christoph-weiser/gf180mcu_cw_ip_vref/README.md

# Current Mode Voltage Reference

### [Documentation](doc/main.md)

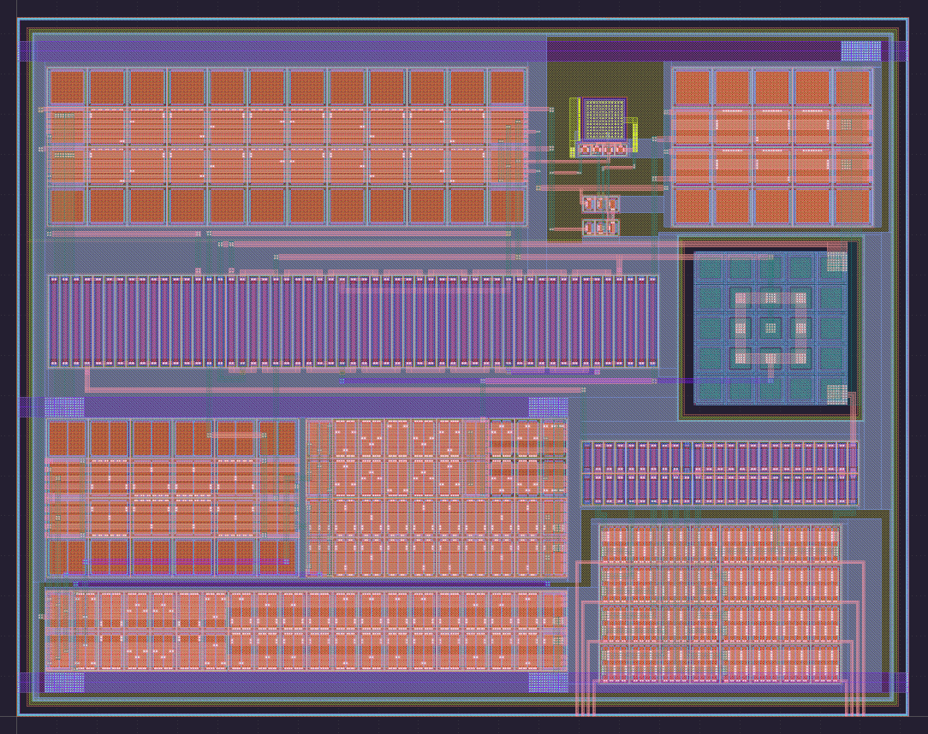
[picture p1: doc/pic/layout.png]
layout
