christoph-weiser/gf180mcu_cw_ip_vref/doc/bandgap/dc_bandgap_temperature.md

# Simulation Results 

Simulation results for dc_bandgap_temperature

## Pre-Layout Simulation

| | min | max | mean | std |
|:---|:---|:---|:---|:---|
| dv_dt | 32.53598u | 58.57123u | 42.82626u | 7.88363u |

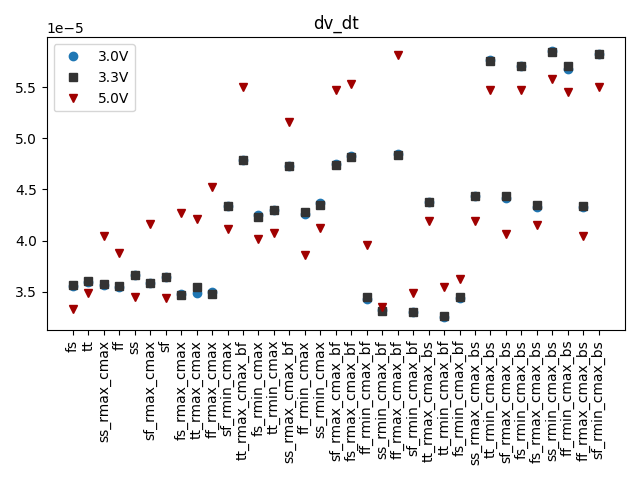
[picture p3: doc/bandgap/pic/sim_sch/dc_bandgap_temperature/dv_dt.png]
dv_dt


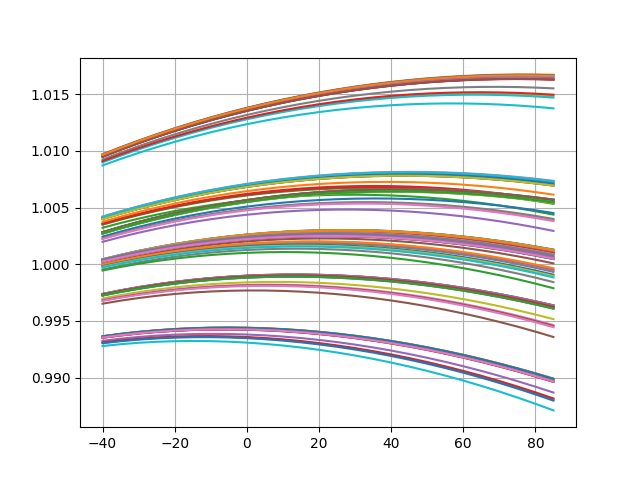
[picture p4: doc/bandgap/pic/sim_sch/dc_bandgap_temperature/tc.png]
tc

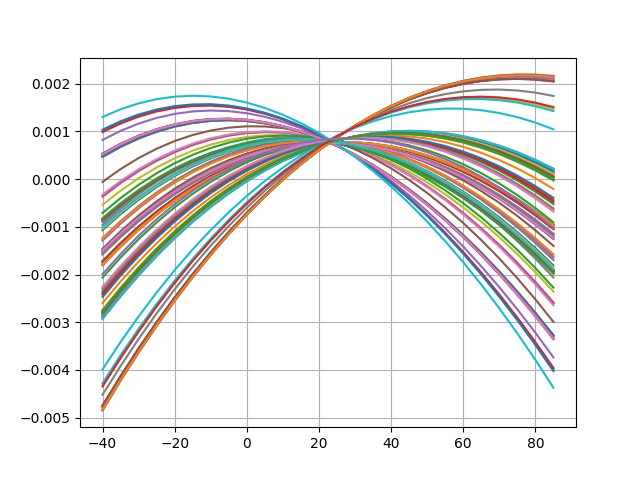
[picture p5: doc/bandgap/pic/sim_sch/dc_bandgap_temperature/tc_norm.png]
tc_norm


## Post-Layout Simulation

NGspice has difficulty to converge on the DC operating point of the circuit. 
While less efficient the Temperature coefficient can also be obtained
by stepping through transient simulations. 

For results see:
[tr_bandgap_temperature](tr_bandgap_temperature.md)
