christoph-weiser/gf180mcu_cw_ip_vref/doc/sim_sch.md

# Schematic Simulation Results

The results shown below are all pre-layout simulation results.

## op_bandgap_power

| | min | max | mean | std |
|:-----|:---|:---|:---|:---|
| iamp | 4.90561u  | 9.68597u  | 7.05185u  | 1.40299u  |
| ibgc | 7.19443u  | 12.44681u | 9.63843u  | 1.89971u  |
| itot | 16.42464u | 29.54914u | 22.46829u | 4.41985u  |
| pamp | 14.71684u | 48.42985u | 26.79417u | 9.11306u  |
| pbgc | 21.60794u | 62.15826u | 36.29921u | 11.20453u |
| ptot | 49.27392u | 147.7457u | 84.85841u | 27.02177u |

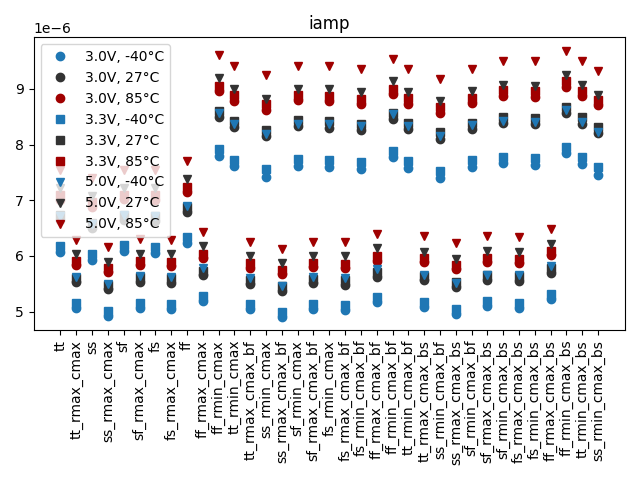
[picture p6: doc/pic/sim_sch/op_bandgap_power/iamp.png]
iamp

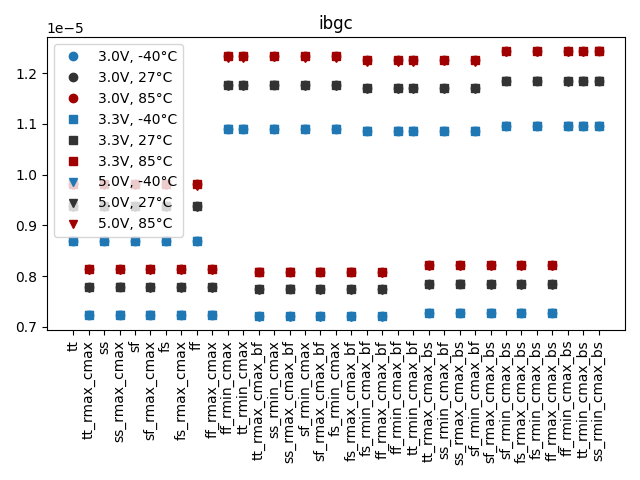
[picture p7: doc/pic/sim_sch/op_bandgap_power/ibgc.png]
ibgc

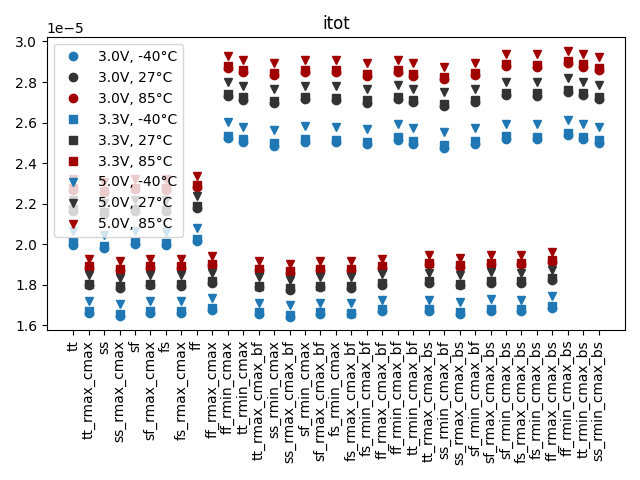
[picture p8: doc/pic/sim_sch/op_bandgap_power/itot.png]
itot

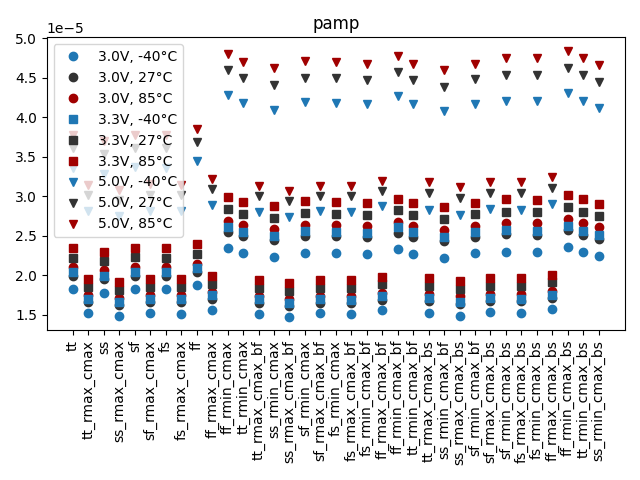
[picture p9: doc/pic/sim_sch/op_bandgap_power/pamp.png]
pamp

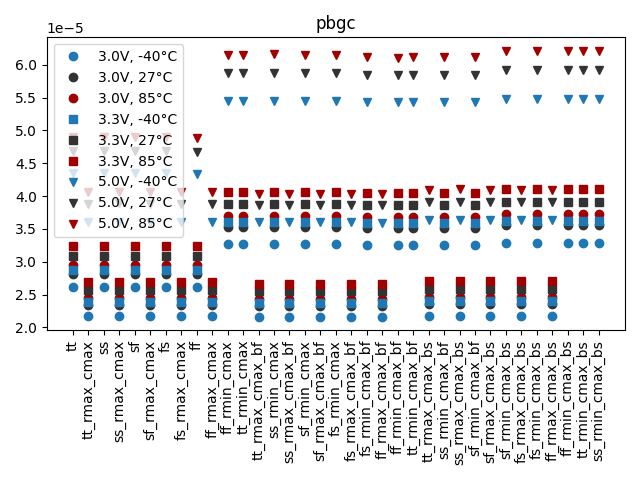
[picture p10: doc/pic/sim_sch/op_bandgap_power/pbgc.png]
pbgc

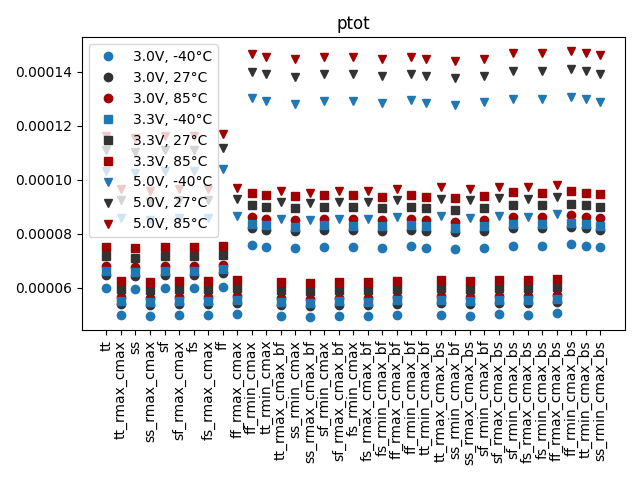
[picture p11: doc/pic/sim_sch/op_bandgap_power/ptot.png]
ptot
