christoph-weiser/gf180mcu_cw_ip_vref/doc/bandgap/no_bandgap.md

# Simulation Results 

Simulation results for no_bandgap

## Pre-Layout Simulation

| | min | max | mean | std |
|:---|:---|:---|:---|:---|
| onoise_total | 74.11961u | 96.98846u | 85.22032u | 5.52835u |

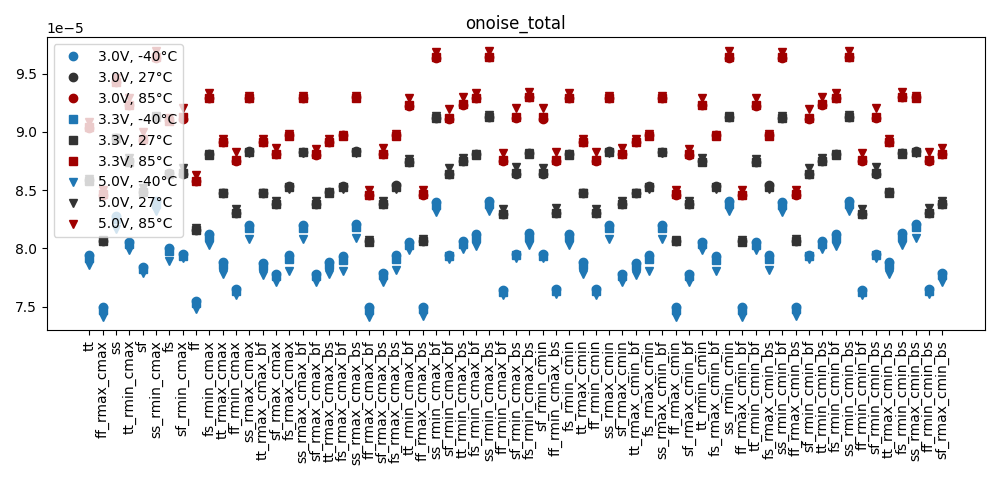
[picture p12: doc/bandgap/pic/sim_sch/no_bandgap/onoise_total.png]
onoise_total


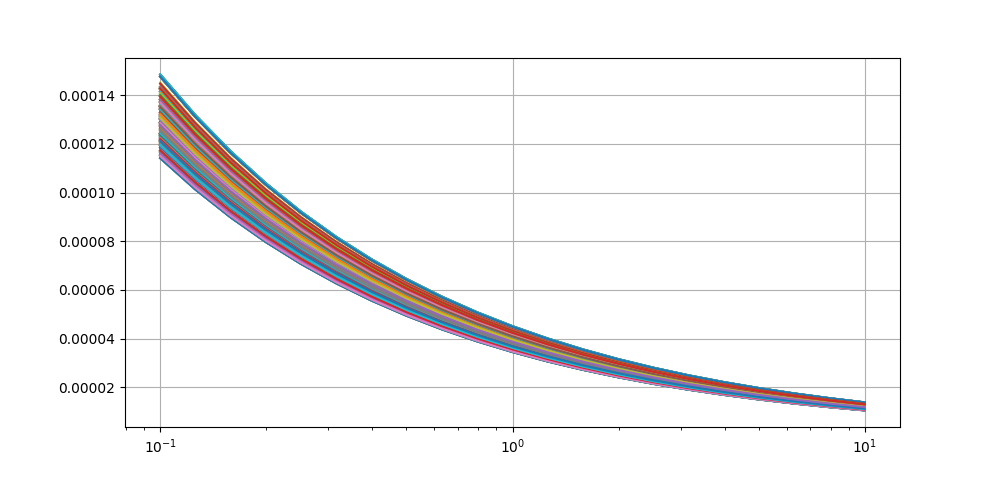
[picture p13: doc/bandgap/pic/sim_sch/no_bandgap/onoise.png]
onoise


## Post-Layout Simulation

| | min | max | mean | std |
|:---|:---|:---|:---|:---|
| onoise_total | 74.50524u | 97.26561u | 85.56302u | 5.44764u |

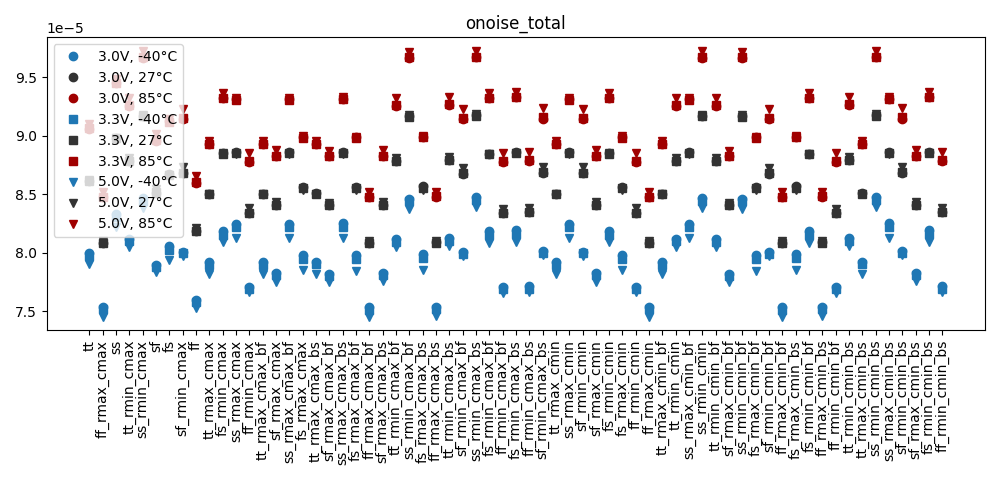
[picture p14: doc/bandgap/pic/sim_pex/no_bandgap/onoise_total.png]
onoise_total


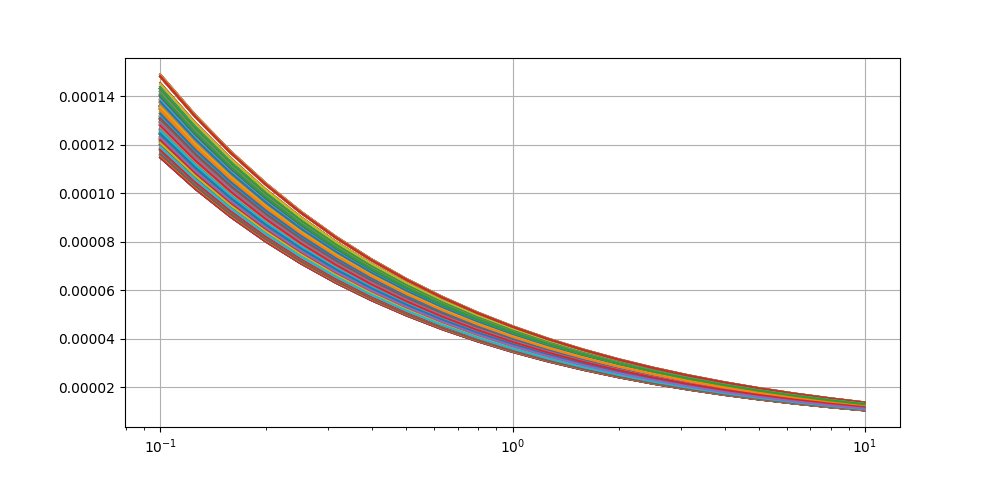
[picture p15: doc/bandgap/pic/sim_pex/no_bandgap/onoise.png]
onoise
