christoph-weiser/gf180mcu_cw_ip_vref/doc/bandgap/mc_bandgap_init_accuracy.md

# Simulation Results 

Simulation results for mc_bandgap_init_accuracy. 

## Pre-Layout Simulation

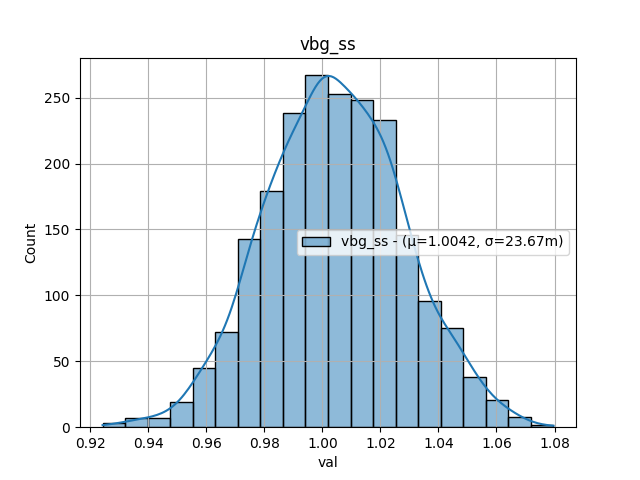
[picture p26: doc/bandgap/pic/sim_sch/mc_bandgap_init_accuracy/vbg_ss.png]
vbg
