christoph-weiser/gf180mcu_cw_ip_vref/doc/levelshifter/tr_levelshifter.md

# Simulation Results 

Simulation results for tr_levelshifter

## Pre-Layout Simulation

| | min | max | mean | std |
|:---|:---|:---|:---|:---|
| vhi | 1.79999 | 5.0 | 3.36666 | 1.30724 |
| vlo | -293.603n | 289.3036n | 379.6658p | 122.534n  |
| trise | 1.819n | 16.181n | 5.78693n  | 3.99033n  |
| tfall | 299.0p | 788.0p | 480.3111p | 105.1477p |

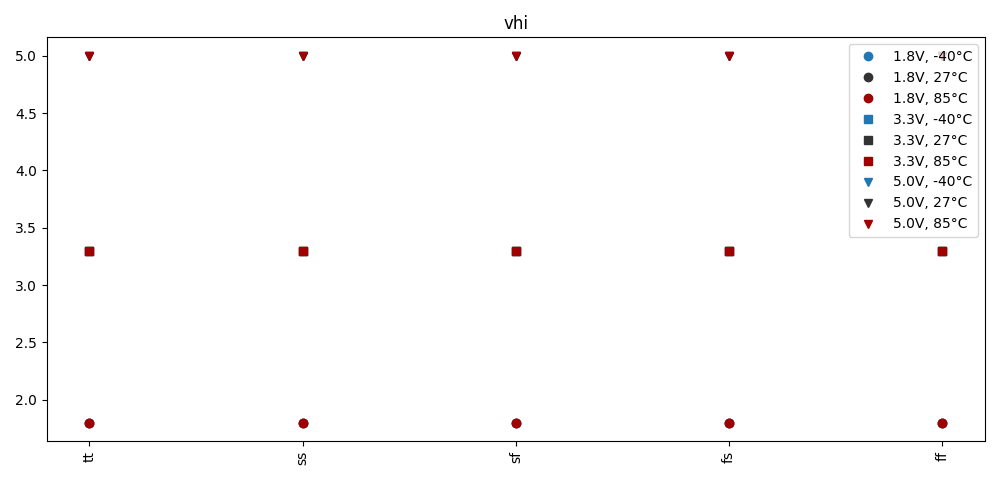
[picture p31: doc/levelshifter/pic/sim_sch/tr_levelshifter/vhi.png]
vhi

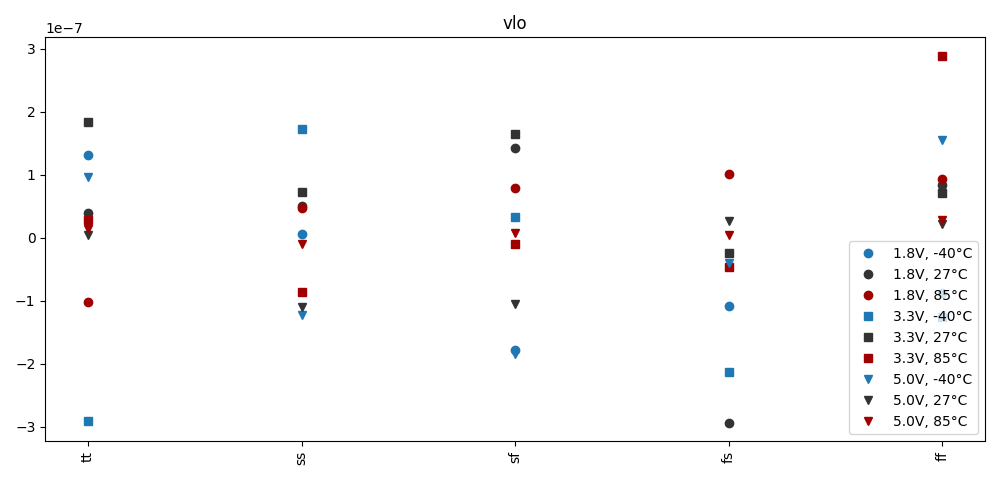
[picture p32: doc/levelshifter/pic/sim_sch/tr_levelshifter/vlo.png]

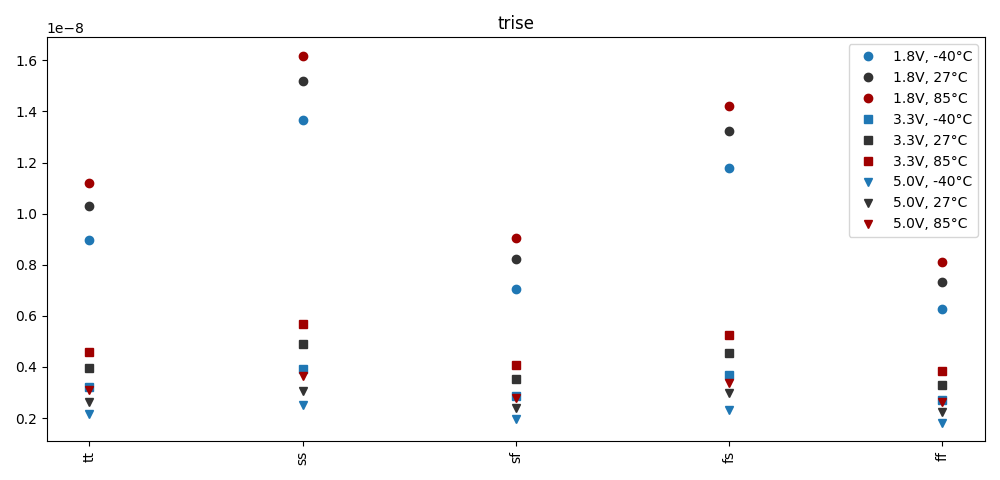
[picture p33: doc/levelshifter/pic/sim_sch/tr_levelshifter/trise.png]
trise

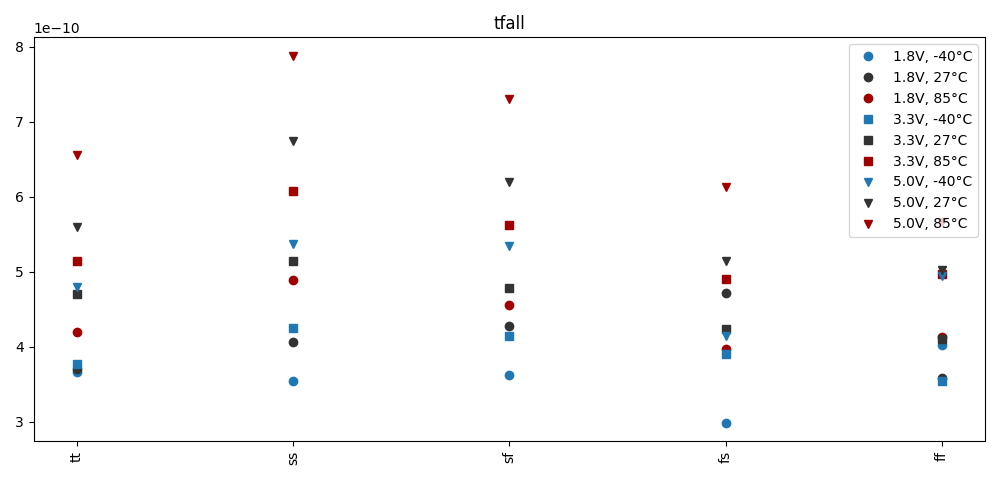
[picture p34: doc/levelshifter/pic/sim_sch/tr_levelshifter/tfall.png]
tfall


## Pre-Layout Simulation

| | min | max | mean | std |
|:---|:---|:---|:---|:---|
| vhi | 1.79999 | 5.0 | 3.36666 | 1.30724 |
| vlo | 652.4982p | 3.97652n | 1.87742n  | 867.5701p |
| trise | 1.91n | 16.477n  | 5.88106n  | 4.06896n  |
| tfall | 287.0p | 817.0p | 475.6222p | 117.6001p |

vhi
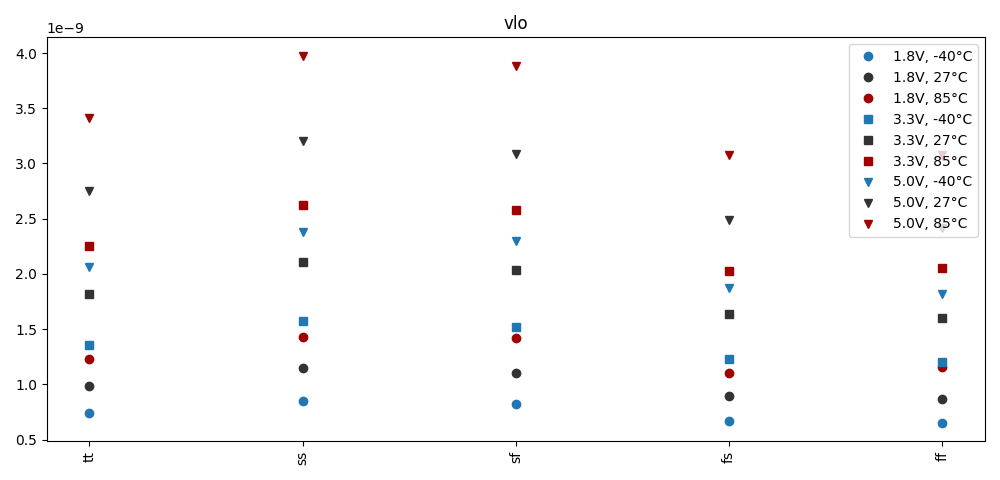
[picture p35: doc/levelshifter/pic/sim_pex/tr_levelshifter/vlo.png]

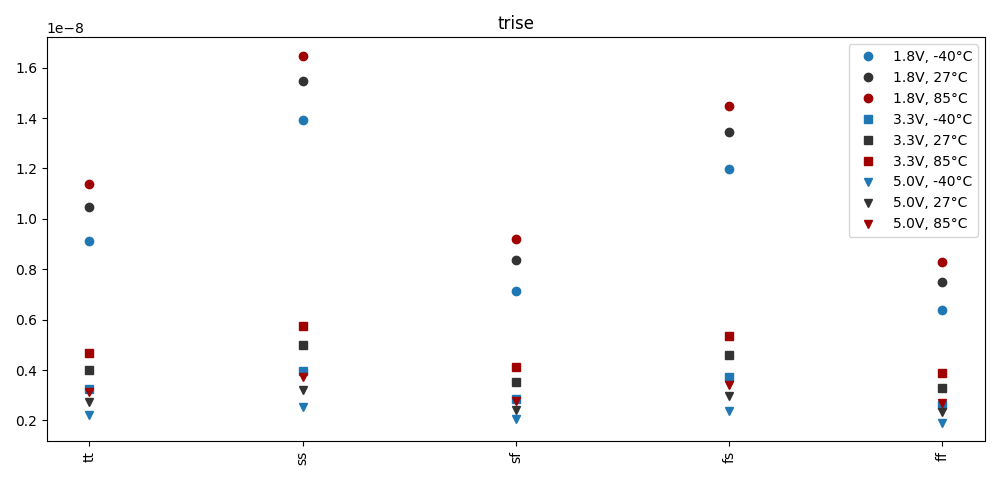
[picture p36: doc/levelshifter/pic/sim_pex/tr_levelshifter/trise.png]
trise

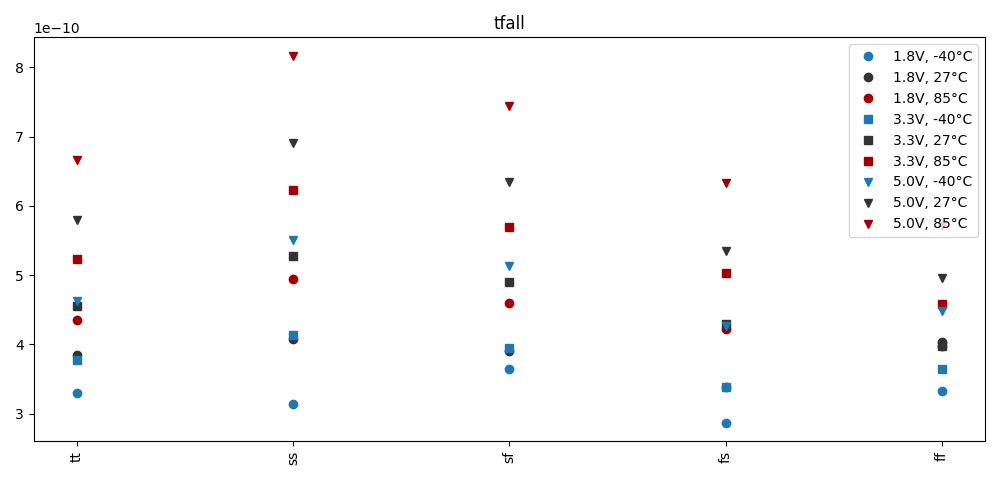
[picture p37: doc/levelshifter/pic/sim_pex/tr_levelshifter/tfall.png]
tfall
