christoph-weiser/gf180mcu_cw_ip_vref/doc/bandgap/tr_bandgap_power_off.md

# Simulation Results 

Simulation results for tr_bandgap_power_off

## Pre-Layout Simulation

| | min | max | mean | std |
|:---|:---|:---|:---|:---|
| ivdd_ss | 577.7768p | 1.07685n | 824.3538p | 156.7362p |

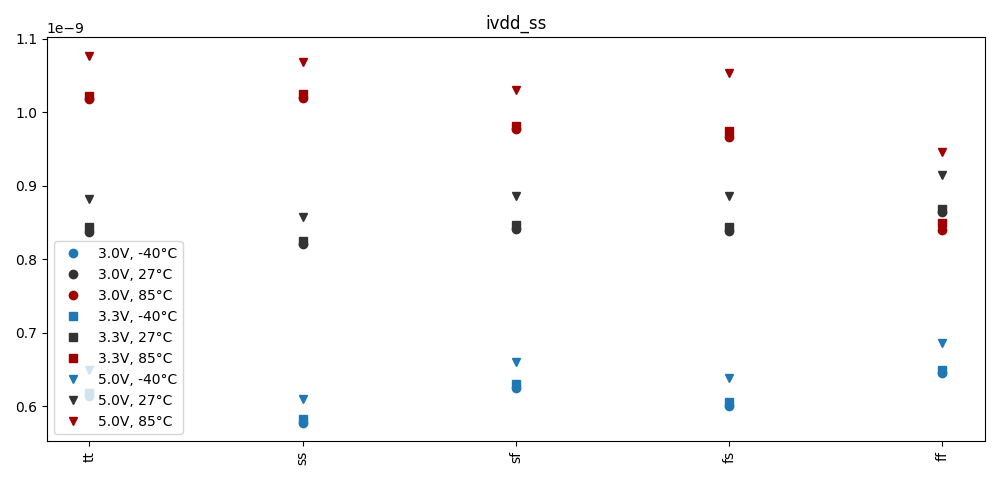
[picture p38: doc/bandgap/pic/sim_sch/tr_bandgap_power_off/ivdd_ss.png]
ivdd_ss


## Post-Layout Simulation

| | min | max | mean | std |
|:---|:---|:---|:---|:---|
| ivdd_ss | 803.8972p | 1.40141n | 1.08660n | 201.2443p |

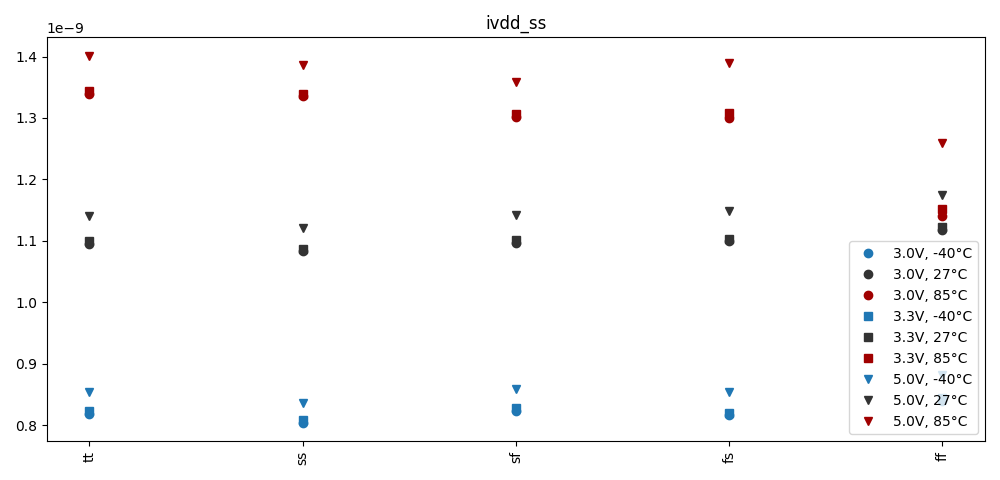
[picture p39: doc/bandgap/pic/sim_pex/tr_bandgap_power_off/ivdd_ss.png]
ivdd_ss
