christoph-weiser/gf180mcu_cw_ip_vref/doc/bandgap/tr_bandgap_trim_ss.md

# Simulation Results 

Simulation results for tr_bandgap_trim_ss

## Pre-Layout Simulation

| | min | max | mean | std |
|:----|---:|---:|---:|---:|
| vbg | 0.854512 | 1.15614 | 1.0061 | 0.0878226 |
| dnl | 0.000665 | 0.00195845 | 0.0011811 | 0.000326729 |

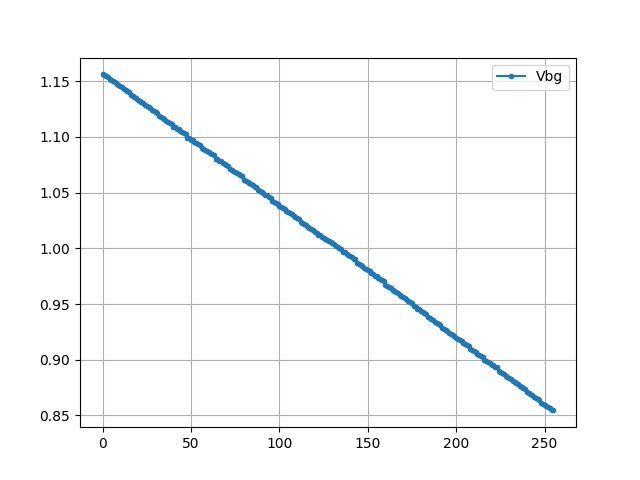
[picture p40: doc/bandgap/pic/sim_sch/tr_bandgap_trim_ss/trim.png]
trim

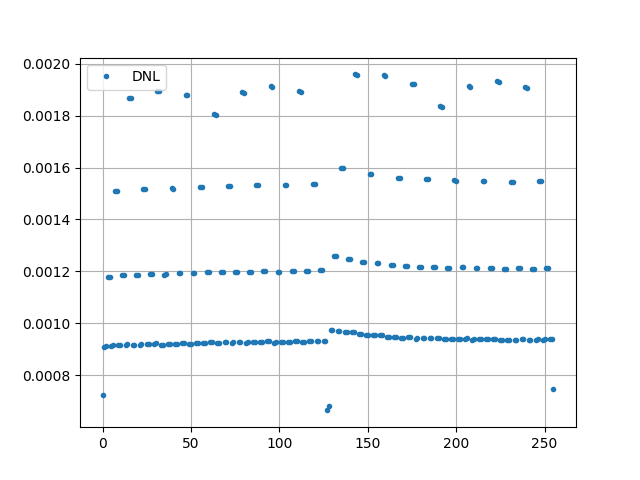
[picture p41: doc/bandgap/pic/sim_sch/tr_bandgap_trim_ss/dnl.png]


## Post-Layout Simulation

| | min | max | mean | std |
|:----|---:|---:|---:|---:|
| vbg | 0.855481 | 1.1622 | 1.00962 | 0.0896754 |
| dnl | 0.00072  | 0.00247275 | 0.00120096 | 0.000376068 |

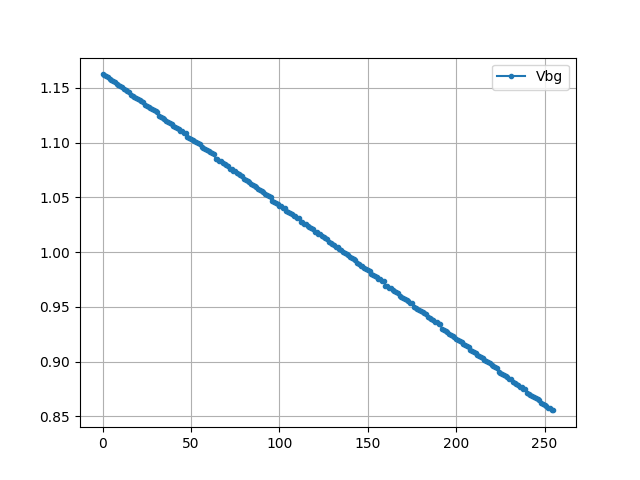
[picture p42: doc/bandgap/pic/sim_pex/tr_bandgap_trim_ss/trim.png]
trim

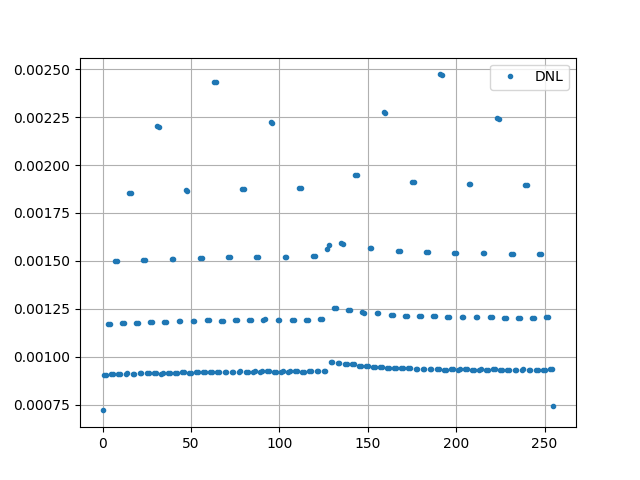
[picture p43: doc/bandgap/pic/sim_pex/tr_bandgap_trim_ss/dnl.png]
