christoph-weiser/gf180mcu_cw_ip_vref/doc/bandgap/tr_bandgap_supply.md

# Simulation Results 

Simulation results for tr_bandgap_supply

## Pre-Layout Simulation

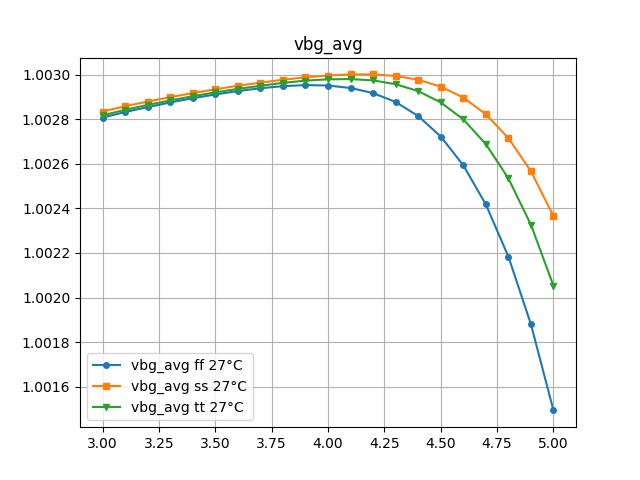
[picture p44: doc/bandgap/pic/sim_sch/tr_bandgap_supply/dv_dvdd.png]
dv_dvdd

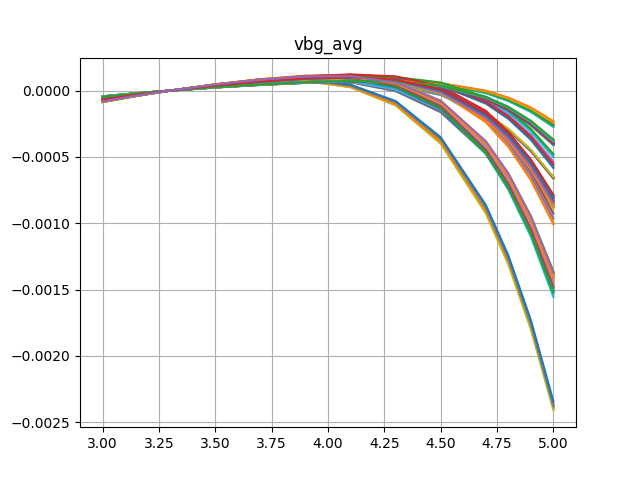
[picture p45: doc/bandgap/pic/sim_pex/tr_bandgap_supply/dv_dvdd_norm.png]
dv_dvdd_norm


## Post-Layout Simulation

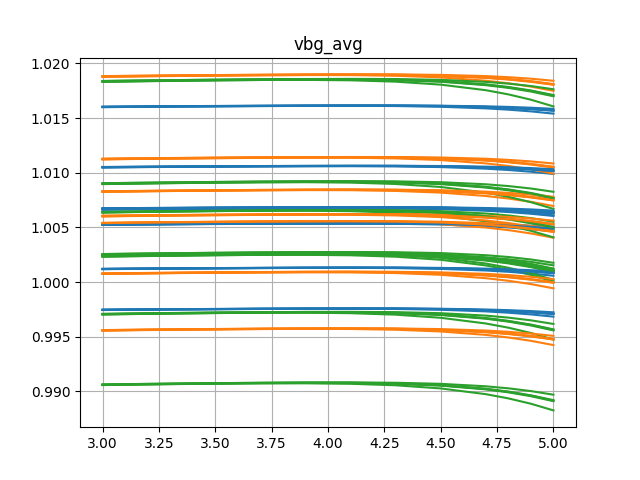
[picture p46: doc/bandgap/pic/sim_pex/tr_bandgap_supply/dv_dvdd.png]
dv_dvdd

dv_dvdd_norm
