christoph-weiser/gf180mcu_cw_ip_vref/doc/bandgap/dc_bandgap_supply.md

# Simulation Results 

Simulation results for dc_bandgap_supply

## Pre-Layout Simulation

| | min | max | mean | std |
|:---|:---|:---|:---|:---|
| vbg_min | 986.566m  | 1.01519 | 1.00181  | 6.74978m  |
| vbg_max | 989.0445m | 1.01600 | 1.00284  | 6.67039m  |
| dv_dvdd | 120.4u | 991.4u  | 411.693u | 226.6034u |

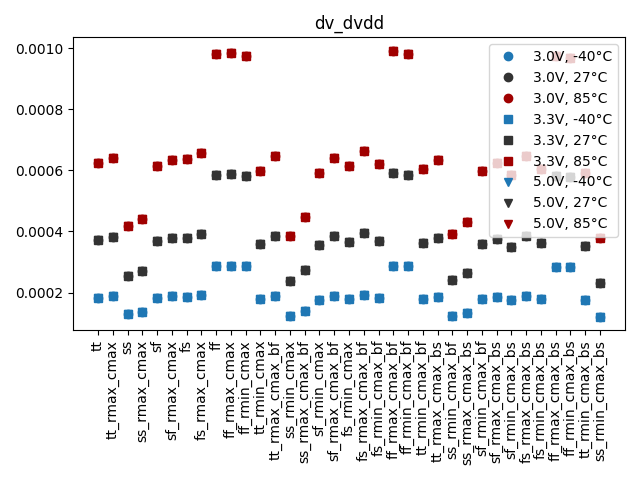
[picture p47: doc/bandgap/pic/sim_sch/dc_bandgap_supply/dv_dvdd.png]
dv_dvdd

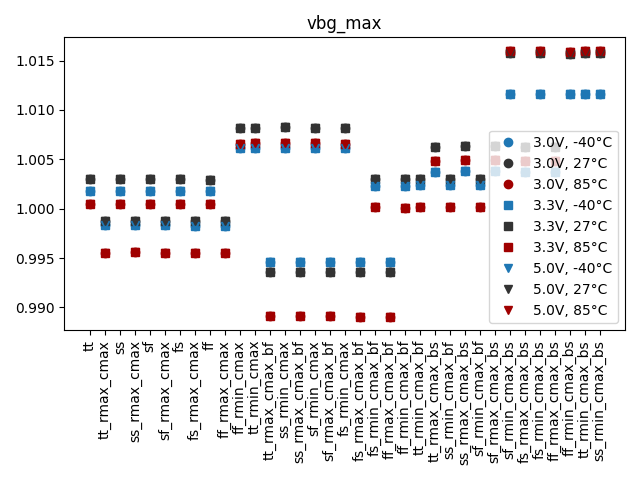
[picture p48: doc/bandgap/pic/sim_sch/dc_bandgap_supply/vbg_max.png]
vbg_max

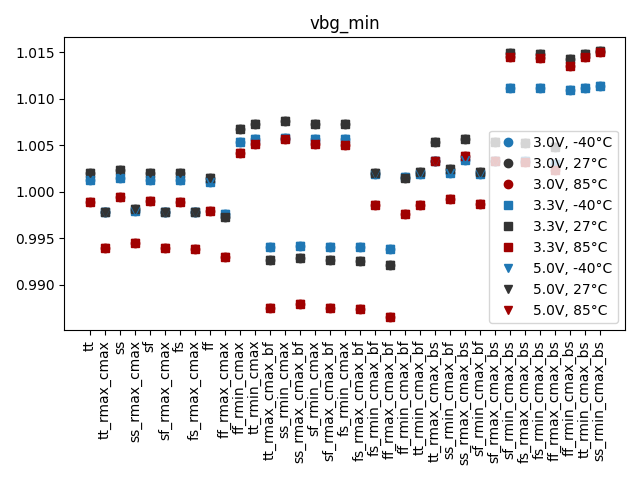
[picture p49: doc/bandgap/pic/sim_sch/dc_bandgap_supply/vbg_min.png]
vbg_min


## Post-Layout Simulation

NGspice has difficulty to converge on the DC operating point of the circuit. 
While less efficient the Supply dependency can also be obtained
by stepping through transient simulations. 

For results see:
[tr_bandgap_supply](tr_bandgap_supply.md)
