christoph-weiser/gf180mcu_cw_ip_vref/doc/bandgap/tr_bandgap_temperature.md

# Simulation Results 

Simulation results for tr_bandgap_temperature

The purpose of this particular testbench is to establish the
correctness of the corresponding .dc testbench.

## Pre-Layout Simulation

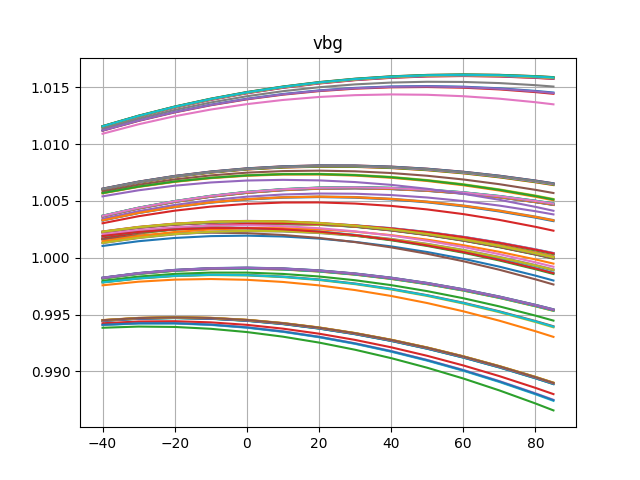
[picture p50: doc/bandgap/pic/sim_sch/tr_bandgap_temperature/vbg.png]

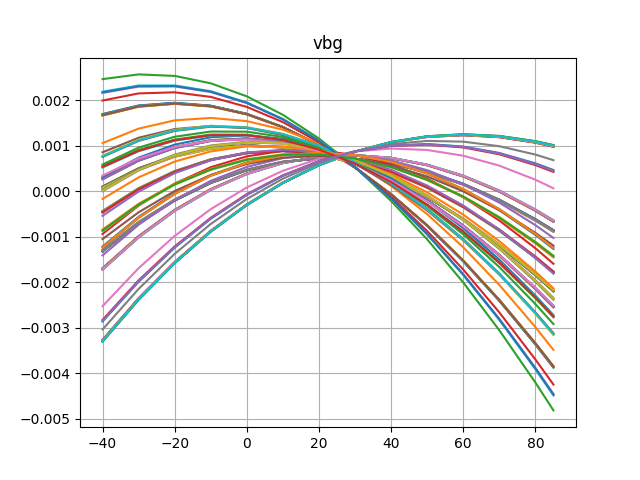
[picture p51: doc/bandgap/pic/sim_sch/tr_bandgap_temperature/vbg_norm.png]
vbg_norm


## Post-Layout Simulation

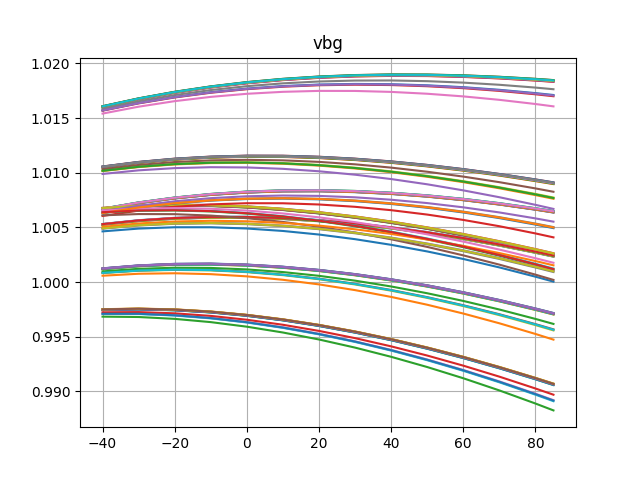
[picture p52: doc/bandgap/pic/sim_pex/tr_bandgap_temperature/vbg.png]

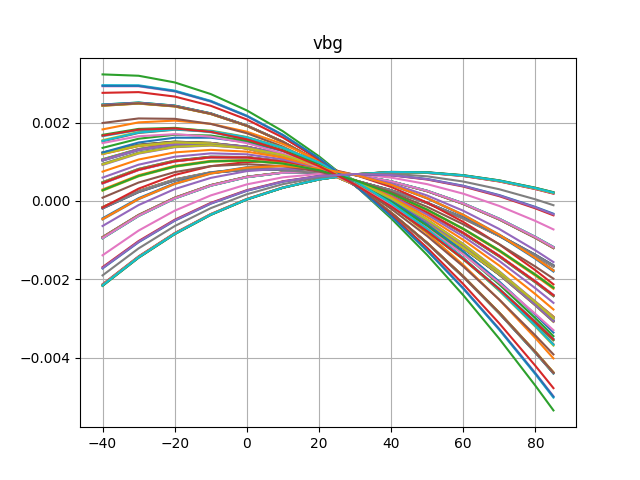
[picture p53: doc/bandgap/pic/sim_pex/tr_bandgap_temperature/vbg_norm.png]
vbg_norm
