christoph-weiser/gf180mcu_cw_ip_vref/doc/spdt/dc_spdt_leakage.md

# Simulation Results 

Simulation results for dc_spdt_leakage

## Pre-Layout Simulation

| | min | max | mean | std |
|:---|:---|:---|:---|:---|
| iin_max  | 7.37331p  | 101.7355p | 18.36708p | 23.94926p |

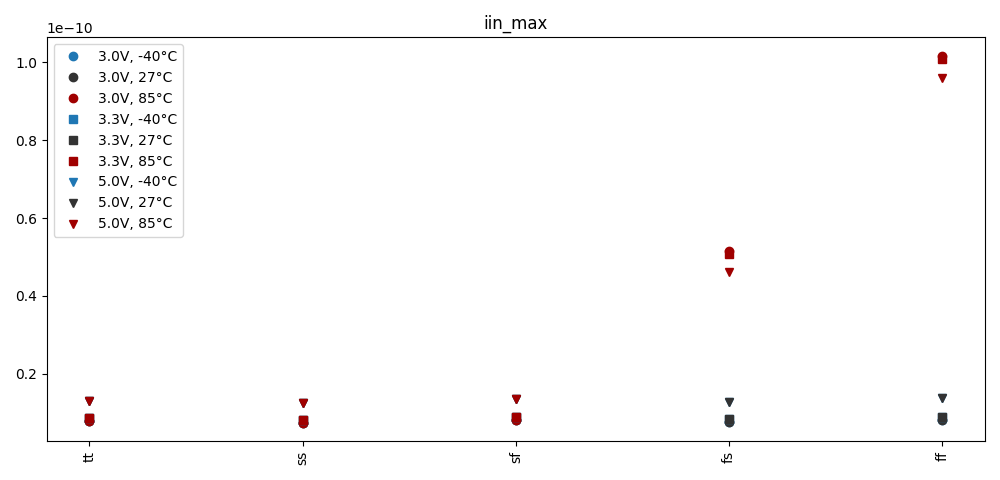
[picture p60: doc/spdt/pic/sim_sch/dc_spdt_leakage/iin_max.png]
iin_max
