christoph-weiser/gf180mcu_cw_ip_vref/doc/spdt/dc_spdt_ron.md

# Simulation Results 

Simulation results for dc_spdt_ron

## Pre-Layout Simulation

| | min | max | mean | std |
|:---|:---|:---|:---|:---|
| rsw_max | 185.4978 | 6.11348k | 934.2965  | 981.0074  |
| rsw_min | 50.0m | 2.4986 | 430.5267m | 886.6032m |

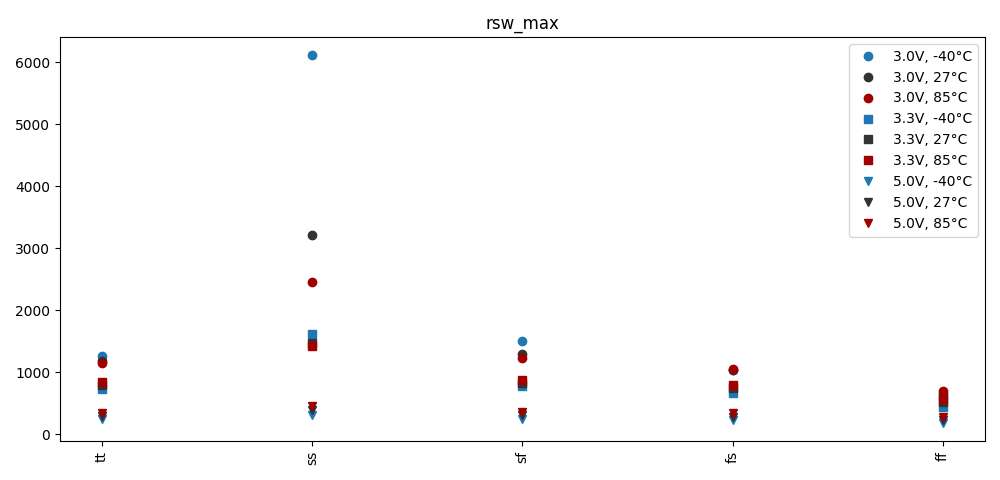
[picture p61: doc/spdt/pic/sim_sch/dc_spdt_ron/rsw_max.png]
rsw_max

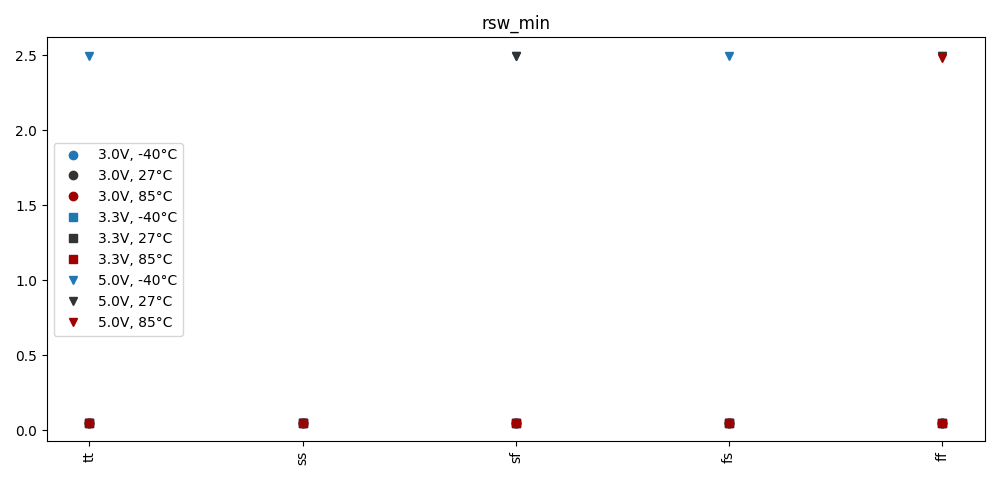
[picture p62: doc/spdt/pic/sim_sch/dc_spdt_ron/rsw_min.png]
rsw_min


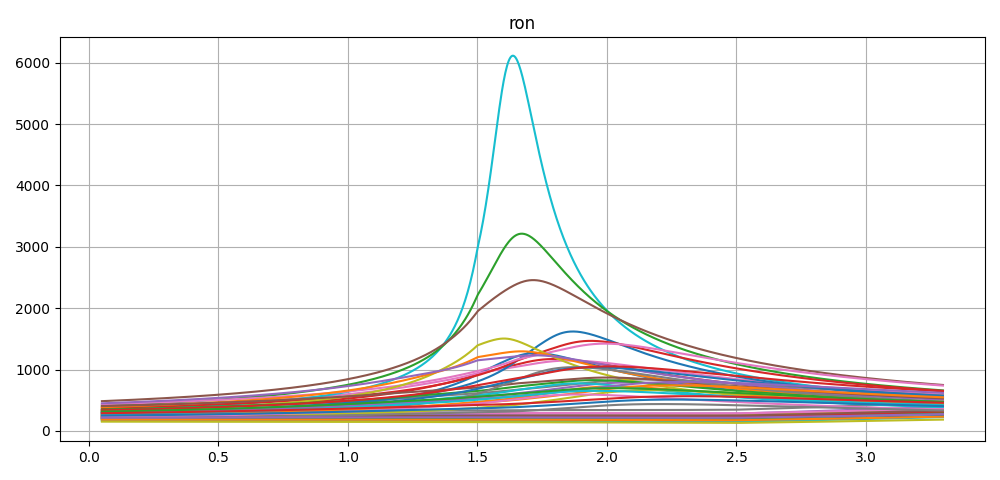
[picture p63: doc/spdt/pic/sim_sch/dc_spdt_ron/ron.png]
ron
