christoph-weiser/gf180mcu_cw_ip_vref/doc/bandgap/mc_bandgap_temperature.md

# Simulation Results 

Simulation results for mc_bandgap_temperature

## Pre-Layout Simulation

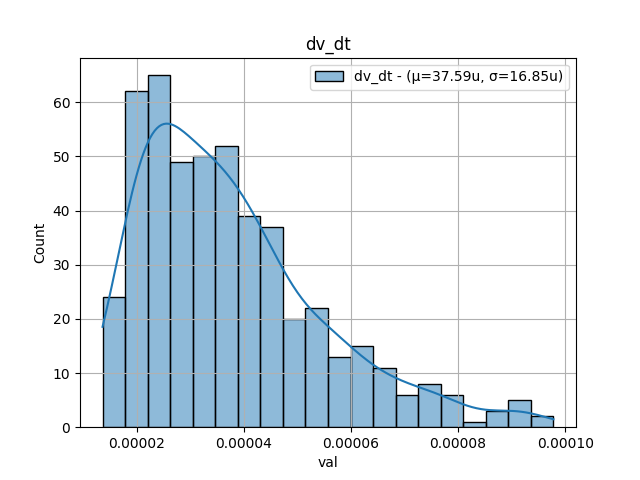
[picture p64: doc/bandgap/pic/sim_sch/mc_bandgap_temperature/dv_dt.png]
dv_dt


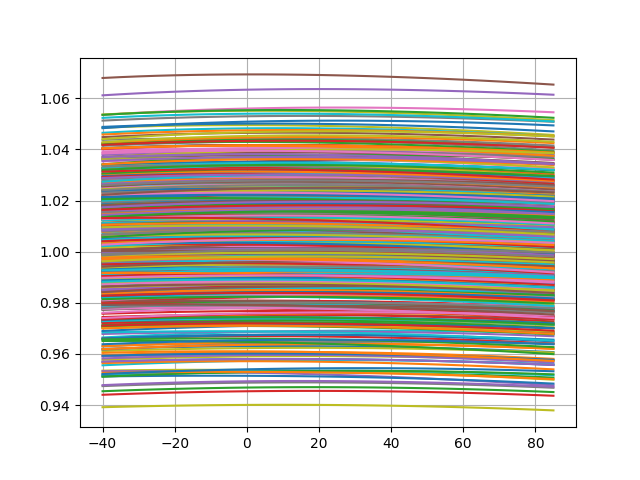
[picture p65: doc/bandgap/pic/sim_sch/mc_bandgap_temperature/tc.png]
tc

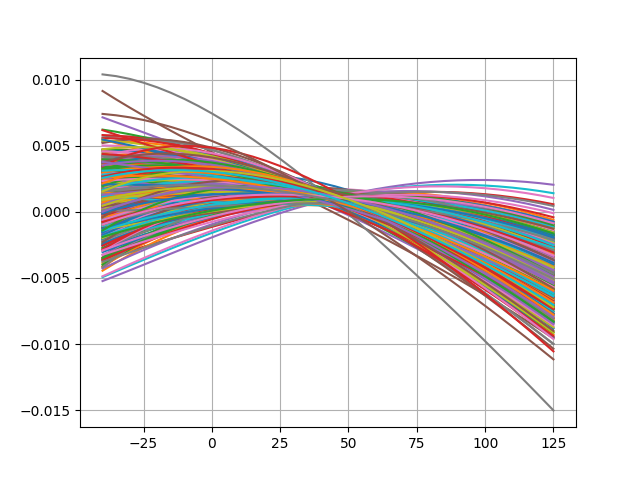
[picture p66: doc/bandgap/pic/sim_sch/mc_bandgap_temperature/tc_norm.png]
tc_norm


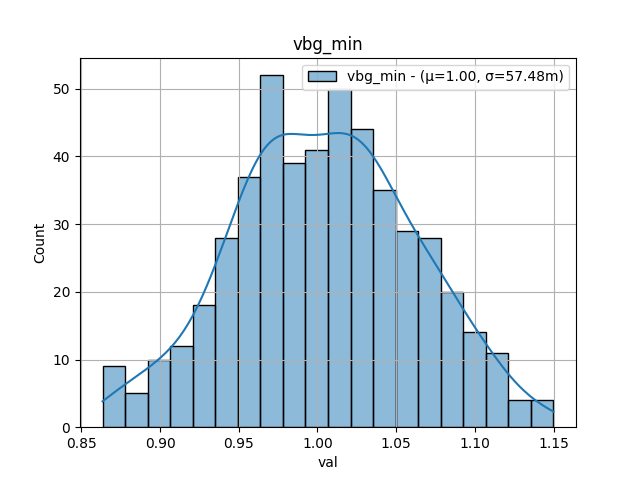
[picture p67: doc/bandgap/pic/sim_sch/mc_bandgap_temperature/vbg_min.png]
vbg_min

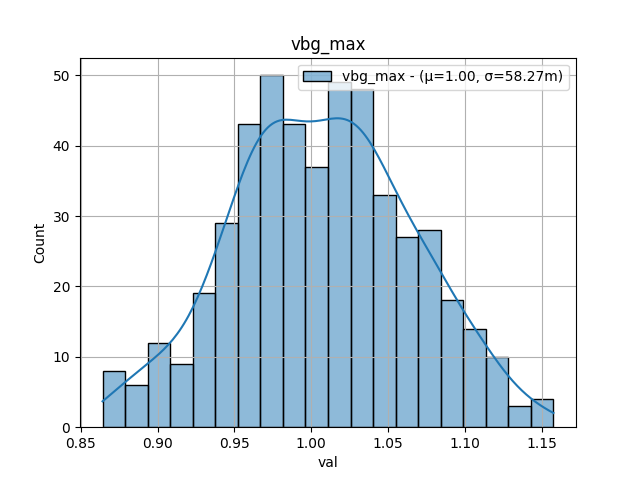
[picture p68: doc/bandgap/pic/sim_sch/mc_bandgap_temperature/vbg_max.png]
vbg_max
