christoph-weiser/gf180mcu_cw_ip_vref/doc/bandgap/tr_bandgap_psrr.md

# Simulation Results 

Simulation results for tr_bandgap_psrr

The purpose of this particular testbench is to establish the
correctness of the corresponding .ac testbench.

## Pre-Layout Simulation

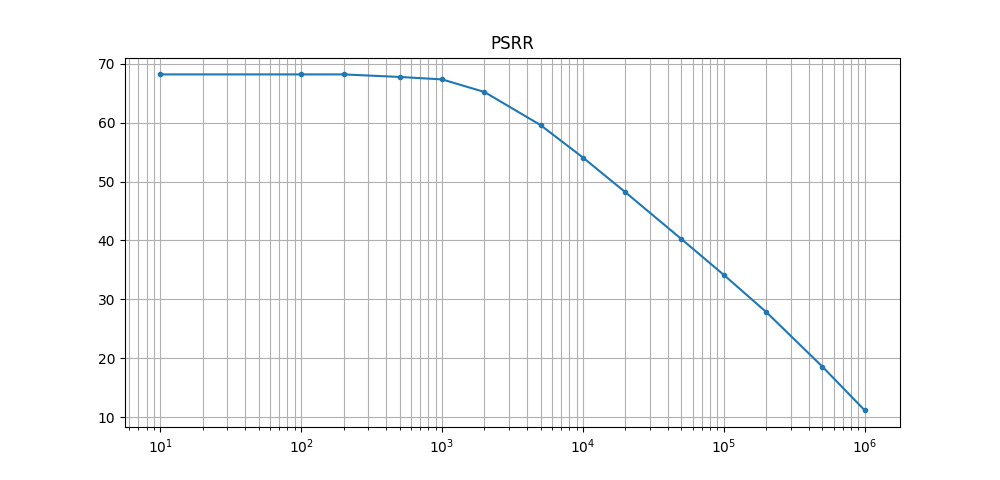
[picture p69: doc/bandgap/pic/sim_sch/tr_bandgap_psrr/psrr.png]
psrr
