christoph-weiser/gf180mcu_cw_ip_vref/doc/bandgap/ac_bandgap_stb.md

# Simulation Results 

Simulation results for ac_bandgap_stb

## Pre-Layout Simulation

| | min | max | mean | std |
|:---|:---|:---|:---|:---|
| gain | 60.67386  | 89.81982  | 81.48283  | 7.65744 |
| ugbw | 678.7398k | 1.57968M  | 1.02607M  | 240.2428k |
| pm | 75.4057 | 82.16207  | 79.44465  | 1.86628 |

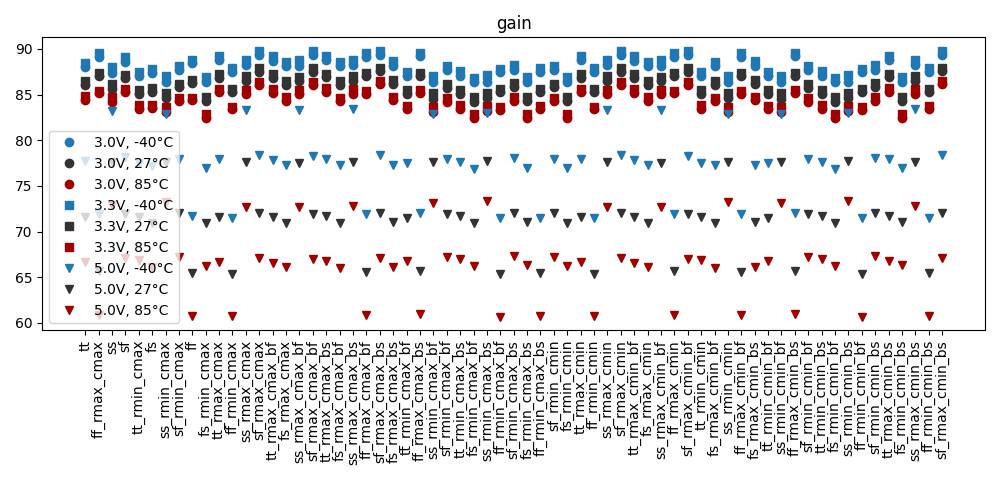
[picture p70: doc/bandgap/pic/sim_sch/ac_bandgap_stb/gain.png]
gain

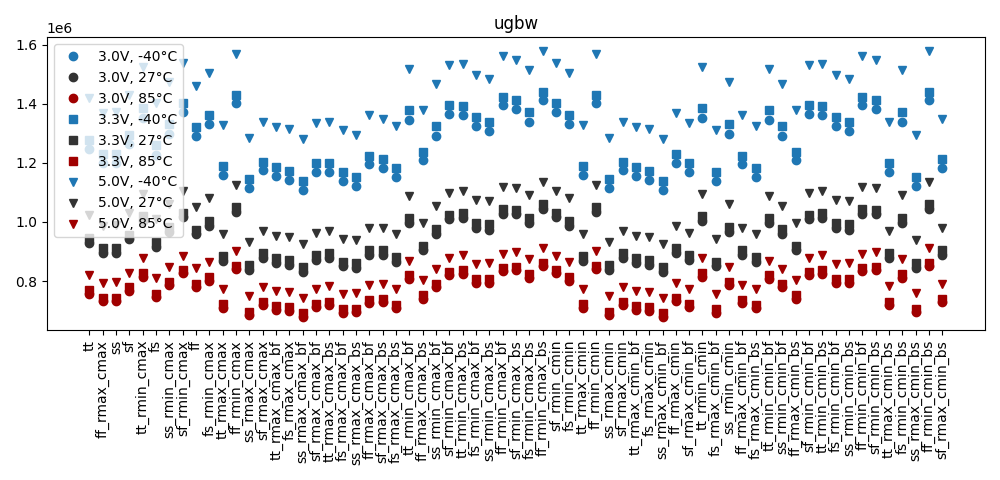
[picture p71: doc/bandgap/pic/sim_sch/ac_bandgap_stb/ugbw.png]
ugbw

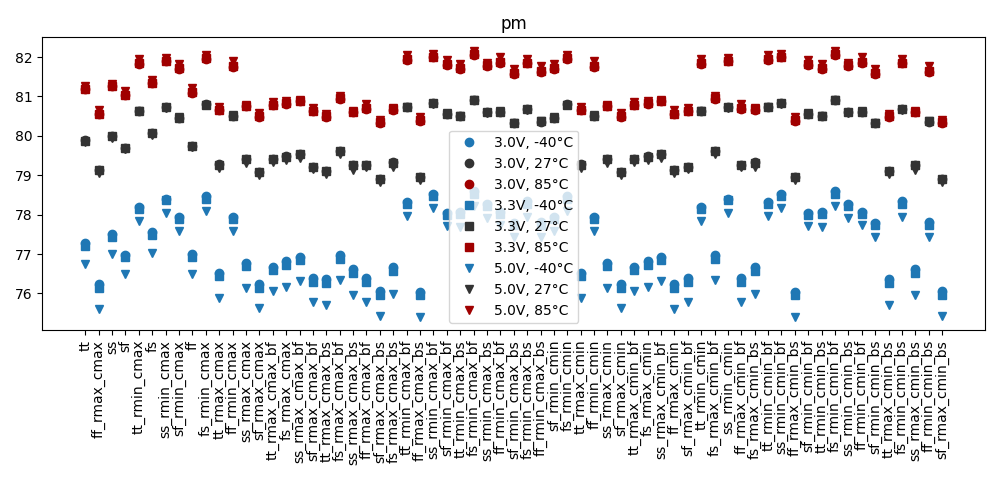
[picture p72: doc/bandgap/pic/sim_sch/ac_bandgap_stb/pm.png]
pm

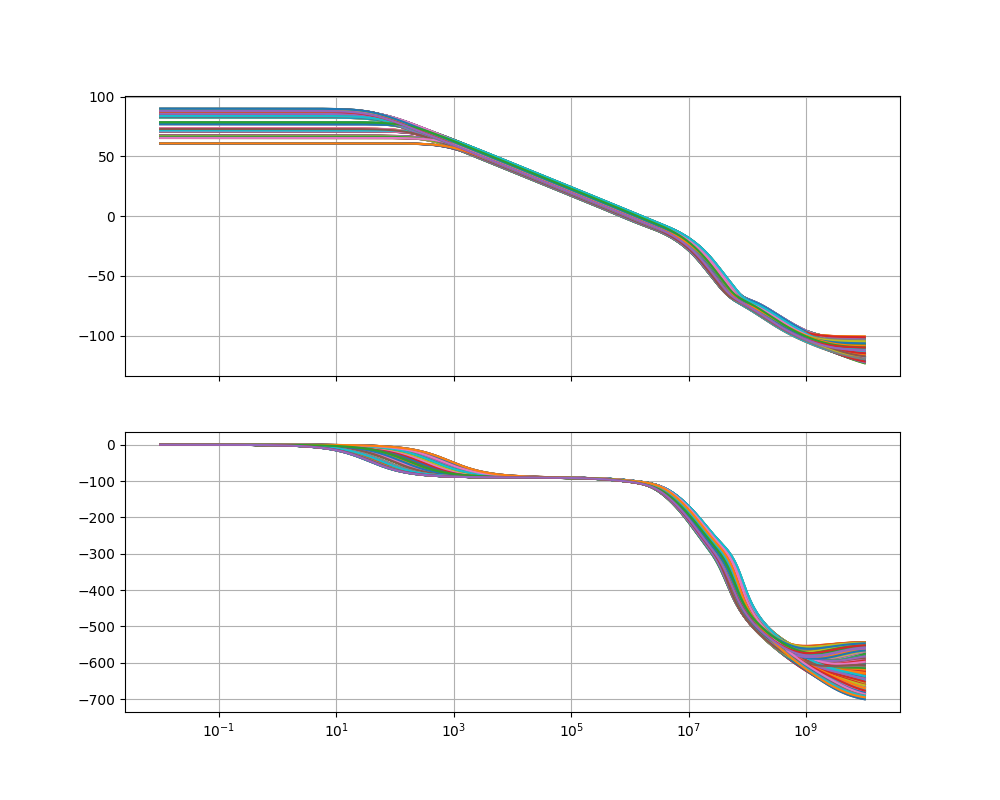
[picture p73: doc/bandgap/pic/sim_sch/ac_bandgap_stb/bode.png]
bode
