christoph-weiser/gf180mcu_cw_ip_vref/doc/bandgap/pic/sim_pex/t_lh.png

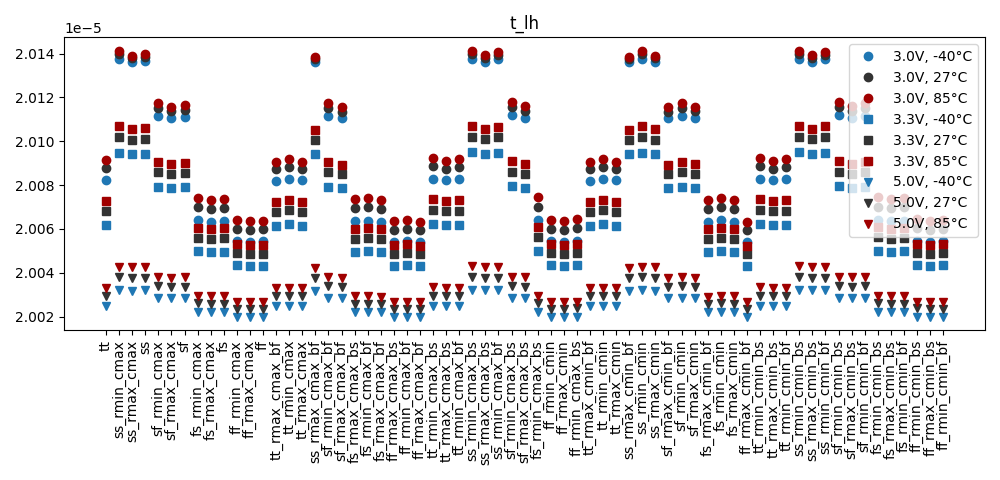
doc/bandgap/pic/sim_pex/t_lh.png
