christoph-weiser/gf180mcu_cw_ip_vref/doc/bandgap/pic/sim_pex/tr_bandgap_supply/vbg_ss.png

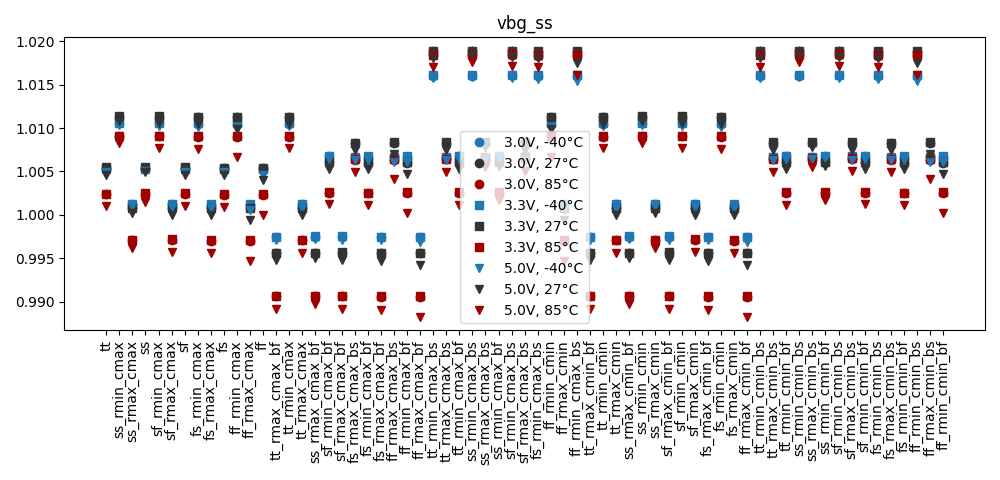
doc/bandgap/pic/sim_pex/tr_bandgap_supply/vbg_ss.png
