christoph-weiser/gf180mcu_cw_ip_vref/doc/testbuffer/ac_tb_amplifier_cmrr.md

# Simulation Results 

Simulation results for ac_tb_amplifier_cmrr

## Pre-Layout Simulation

| | min | max | mean | std |
|:-----|---:|---:|---:|---:|
| cmrr | 86.3821 | 109.983 | 93.1609 | 6.63915 |

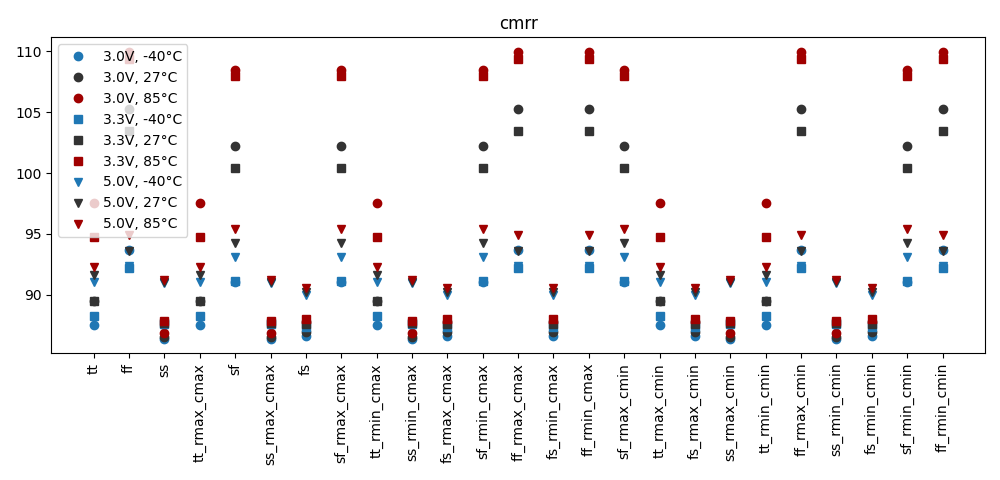
[picture p78: doc/testbuffer/pic/sim_sch/ac_tb_amplifier_cmrr/cmrr.png]
cmrr


## Post-Layout Simulation

| | min | max | mean | std |
|:-----|---:|---:|---:|---:|
| cmrr | 86.3819 | 109.984 | 93.1623 | 6.64021 |

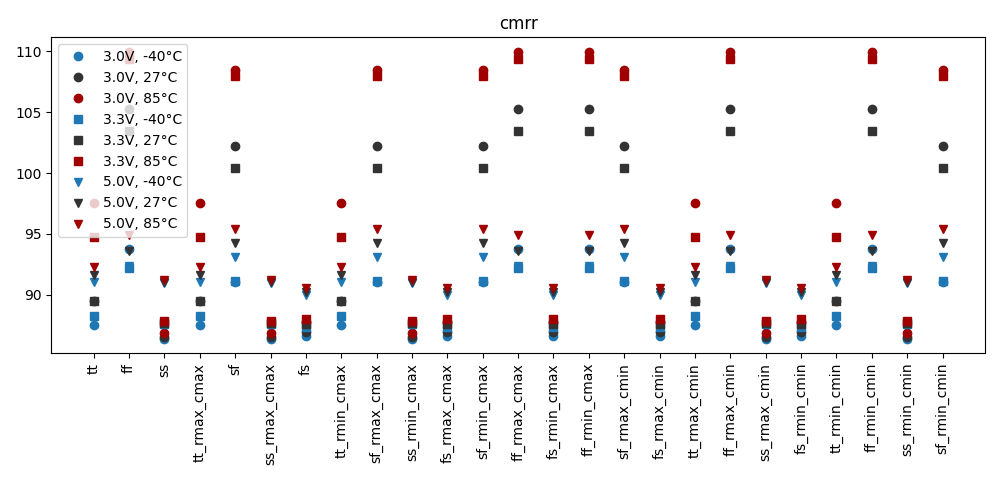
[picture p79: doc/testbuffer/pic/sim_pex/ac_tb_amplifier_cmrr/cmrr.png]
cmrr
