christoph-weiser/gf180mcu_cw_ip_vref/doc/testbuffer/ac_tb_amplifier_psrr.md

# Simulation Results 

Simulation results for ac_tb_amplifier_psrr

## Pre-Layout Simulation

| | min | max | mean | std |
|:---|---:|---:|---:|---:|
| psrr_p_1 | 103.15 | 131.412  | 113.903  |  6.83289 |
| psrr_p_10  | 102.508  | 114.559  | 109.289  |  2.70646 |
| psrr_p_100 |  90.0271 |  96.0439 |  92.7876 |  1.35344 |
| psrr_p_1k  |  70.0272 |  76.1325 |  72.8597 |  1.35908 |
| psrr_p_10k |  50.0271 |  56.1334 |  52.8604 |  1.35915 |
| psrr_n_1 |  99.9941 | 146.248  | 118.31 | 11.5974  |
| psrr_n_10  |  99.9941 | 145.994  | 118.29 | 11.5609  |
| psrr_n_100 |  99.9923 | 137.747  | 117.335  | 10.0519  |
| psrr_n_1k  |  99.8179 | 118.401  | 110.742  |  4.39667 |
| psrr_n_10k |  90.553  |  98.632  |  94.2556 |  1.70738 |

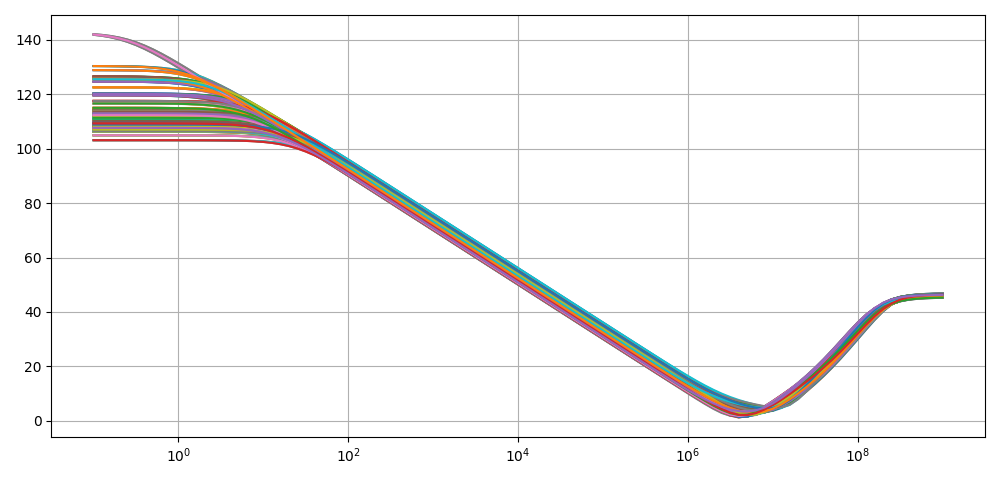
[picture p80: doc/testbuffer/pic/sim_sch/ac_tb_amplifier_psrr/psrr_p.png]
psrr_p

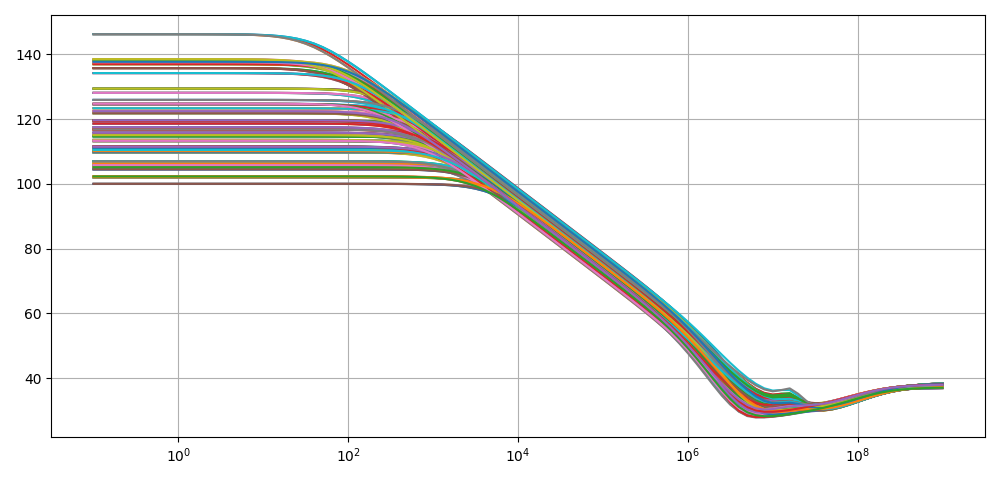
[picture p81: doc/testbuffer/pic/sim_sch/ac_tb_amplifier_psrr/psrr_n.png]
psrr_n


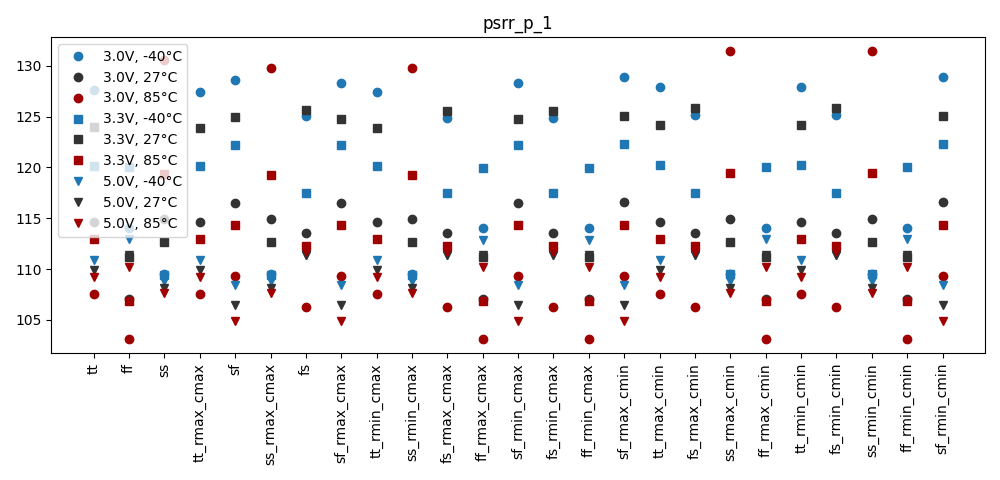
[picture p82: doc/testbuffer/pic/sim_sch/ac_tb_amplifier_psrr/psrr_p_1.png]
psrr_p_1

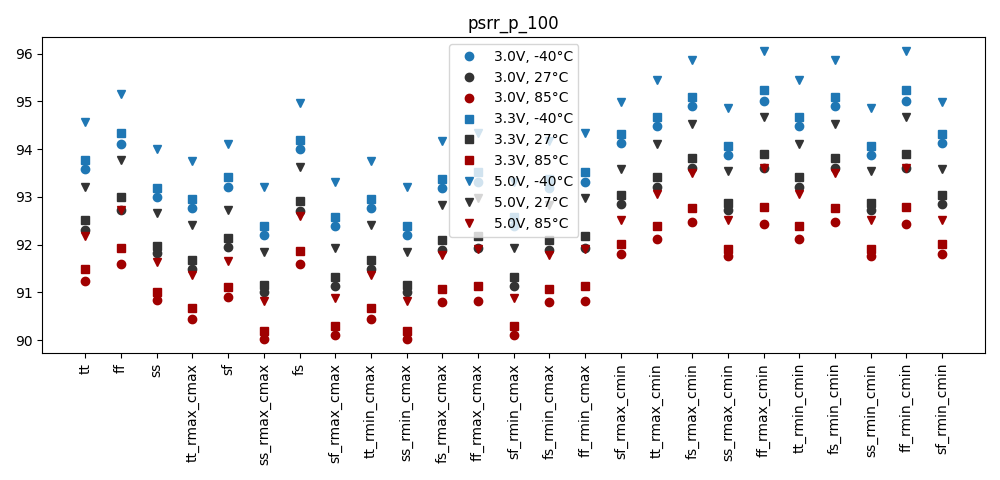
[picture p83: doc/testbuffer/pic/sim_sch/ac_tb_amplifier_psrr/psrr_p_100.png]
psrr_p_100

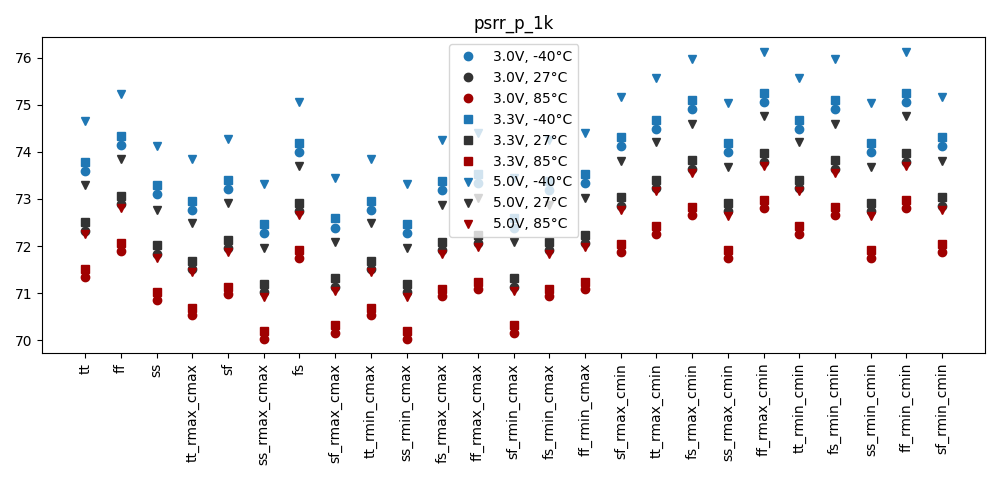
[picture p84: doc/testbuffer/pic/sim_sch/ac_tb_amplifier_psrr/psrr_p_1k.png]
psrr_p_1k

psrr_p_10k
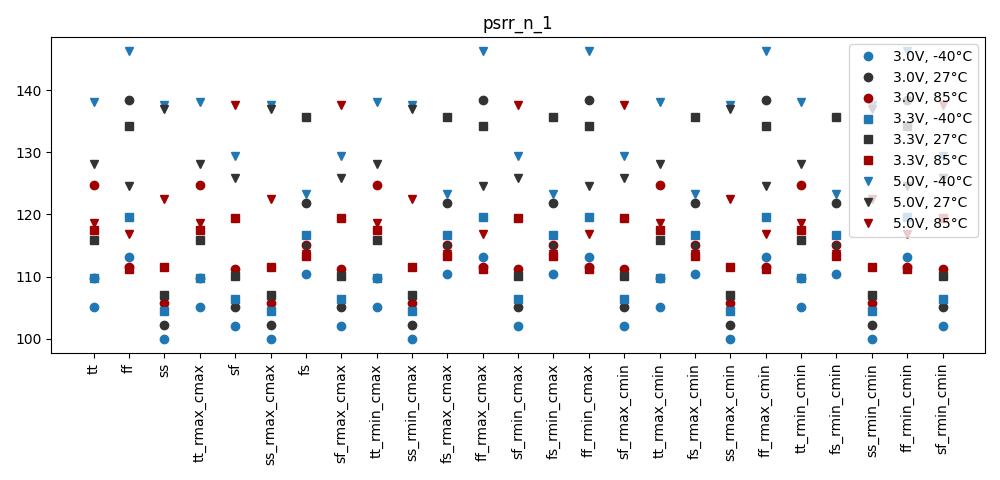
[picture p85: doc/testbuffer/pic/sim_sch/ac_tb_amplifier_psrr/psrr_n_1.png]
psrr_n_1

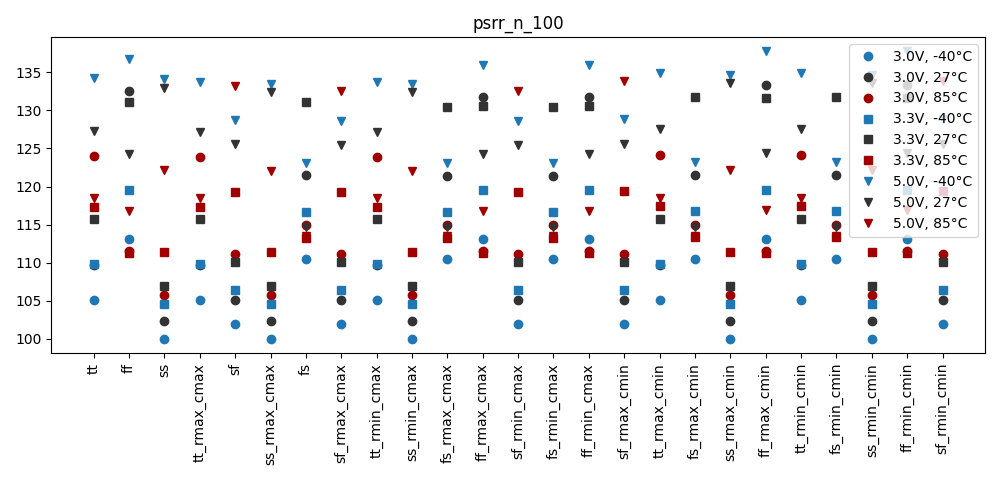
[picture p86: doc/testbuffer/pic/sim_sch/ac_tb_amplifier_psrr/psrr_n_100.png]
psrr_n_100

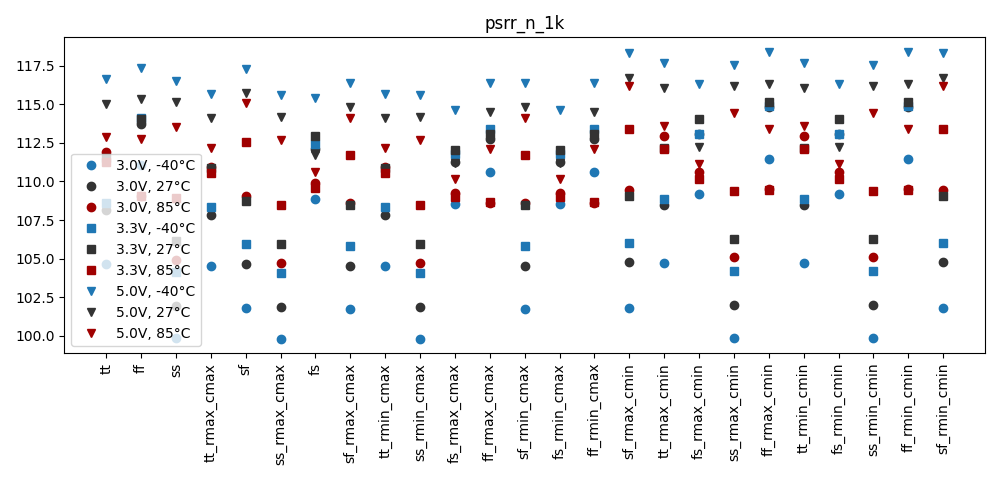
[picture p87: doc/testbuffer/pic/sim_sch/ac_tb_amplifier_psrr/psrr_n_1k.png]
psrr_n_1k


## Post-Layout Simulation

| | min | max | mean | std |
|:---|---:|---:|---:|---:|
| psrr_p_1 | 103.144  | 131.386  | 113.899  |  6.82287 |
| psrr_p_10  | 102.499  | 114.527  | 109.274  |  2.69577 |
| psrr_p_100 |  89.9982 |  96.0093 |  92.7561 |  1.35193 |
| psrr_p_1k  |  69.9982 |  76.0973 |  72.8276 |  1.35742 |
| psrr_p_10k |  49.9982 |  56.0982 |  52.8283 |  1.35749 |
| psrr_n_1 |  99.9936 | 167.739  | 118.47 | 12.8245  |
| psrr_n_10  |  99.9936 | 159.498  | 118.25 | 12.0483  |
| psrr_n_100 |  99.9929 | 142.499  | 117.523  | 10.393 |
| psrr_n_1k  |  99.9285 | 124.841  | 113.28 |  6.05051 |
| psrr_n_10k |  93.8559 | 106.478  |  99.0905 |  2.5436  |

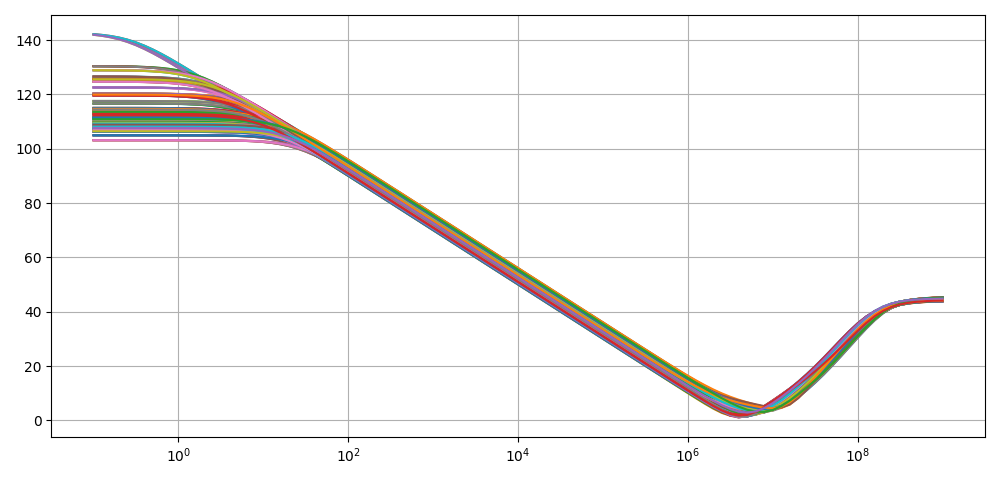
[picture p88: doc/testbuffer/pic/sim_pex/ac_tb_amplifier_psrr/psrr_p.png]
psrr_p

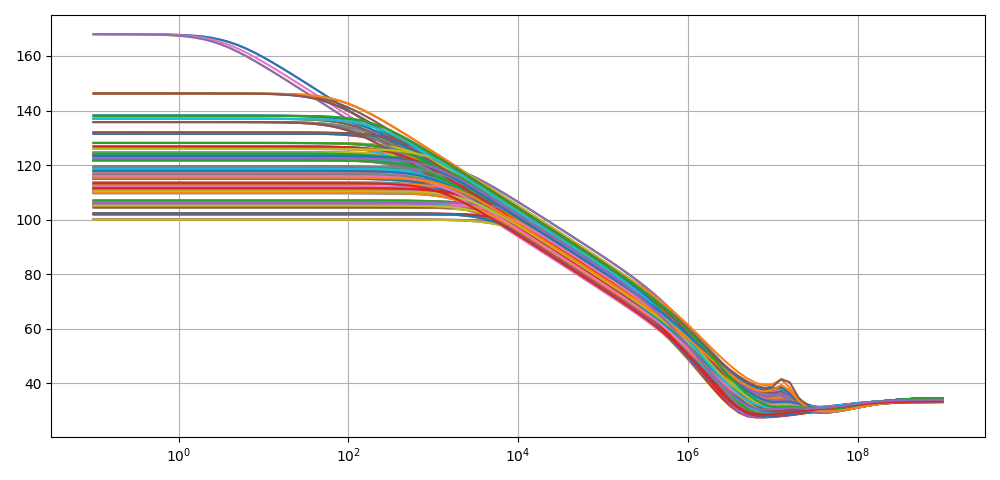
[picture p89: doc/testbuffer/pic/sim_pex/ac_tb_amplifier_psrr/psrr_n.png]
psrr_n


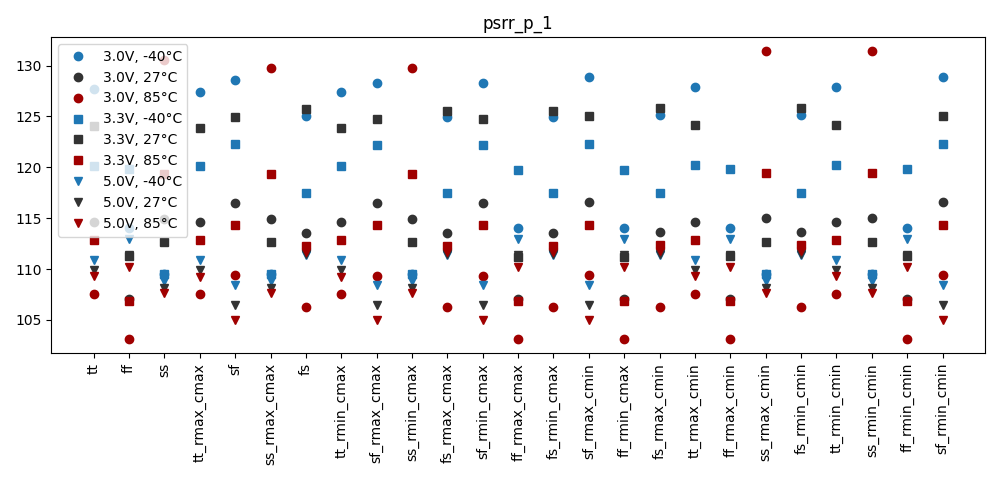
[picture p90: doc/testbuffer/pic/sim_pex/ac_tb_amplifier_psrr/psrr_p_1.png]
psrr_p_1

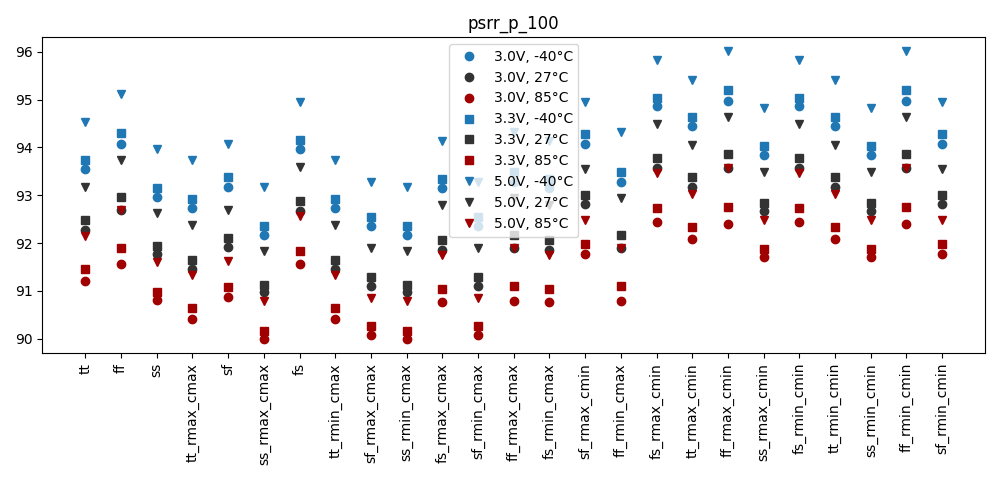
[picture p91: doc/testbuffer/pic/sim_pex/ac_tb_amplifier_psrr/psrr_p_100.png]
psrr_p_100

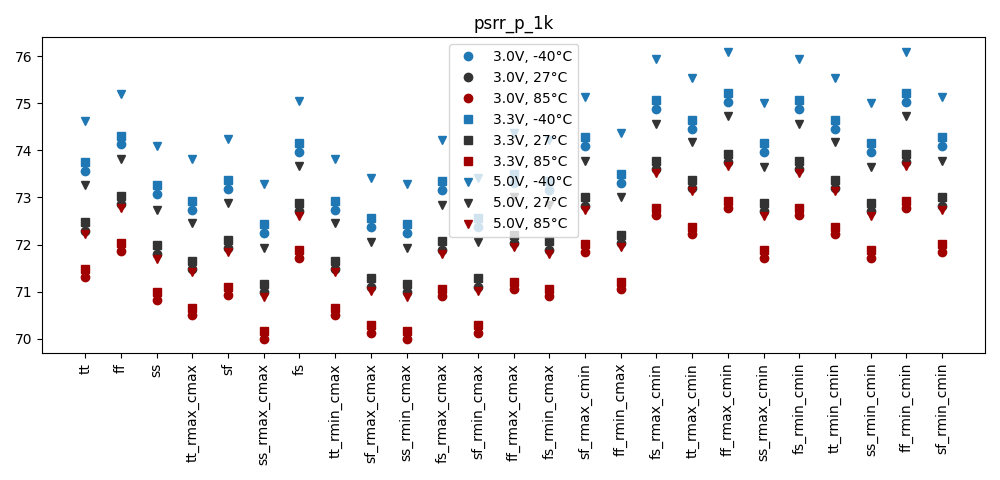
[picture p92: doc/testbuffer/pic/sim_pex/ac_tb_amplifier_psrr/psrr_p_1k.png]
psrr_p_1k

psrr_p_10k
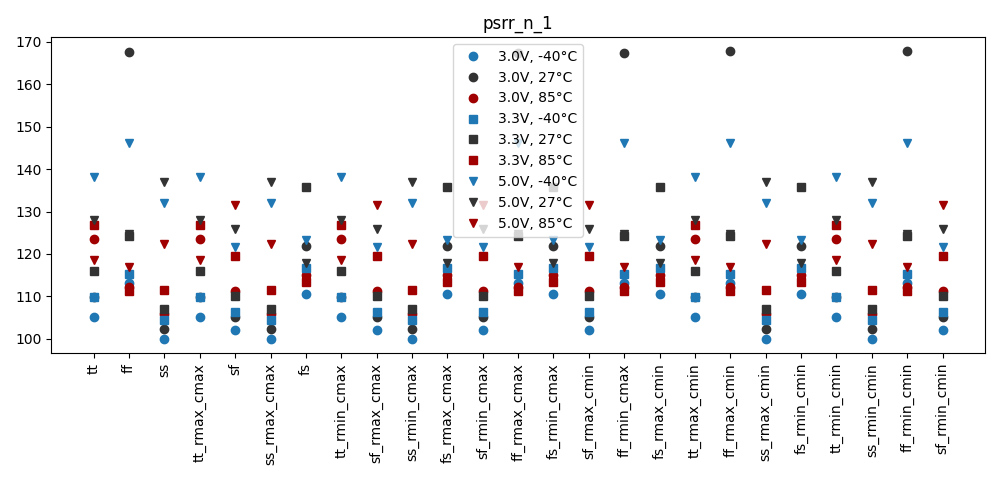
[picture p93: doc/testbuffer/pic/sim_pex/ac_tb_amplifier_psrr/psrr_n_1.png]
psrr_n_1

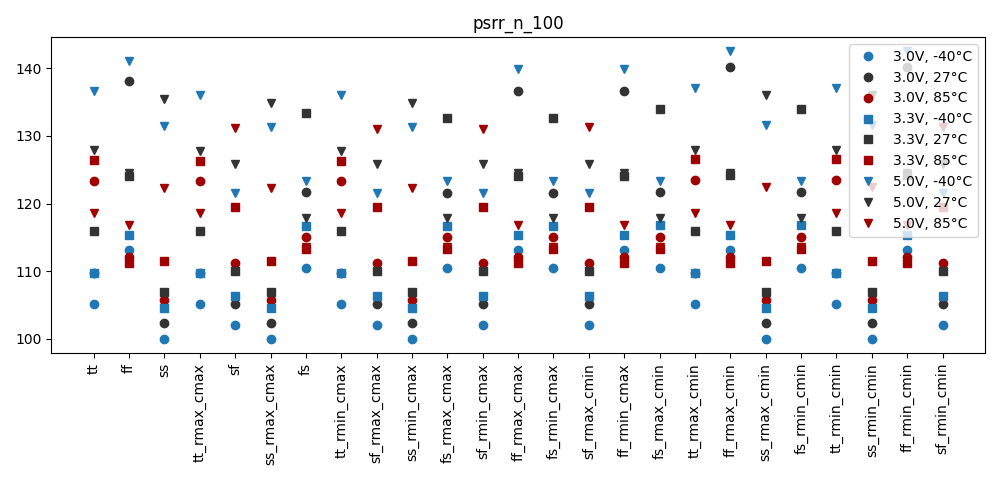
[picture p94: doc/testbuffer/pic/sim_pex/ac_tb_amplifier_psrr/psrr_n_100.png]
psrr_n_100

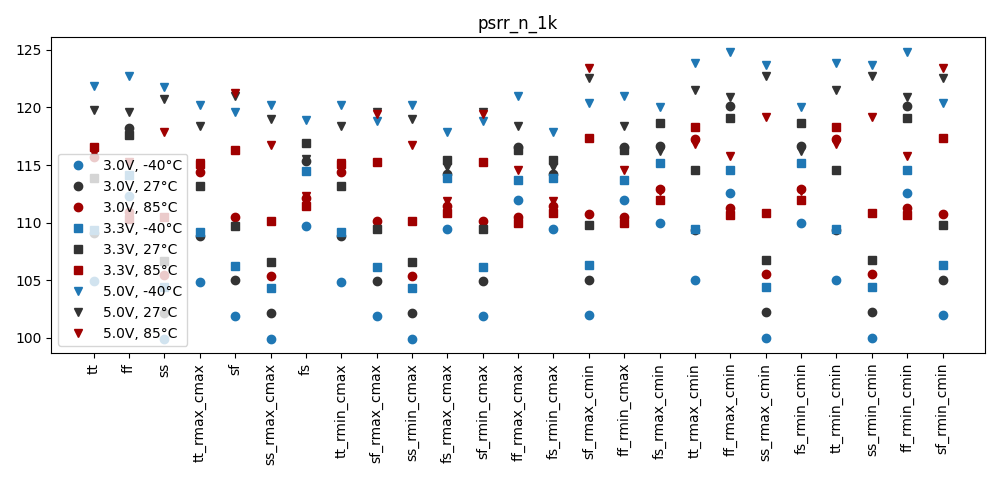
[picture p95: doc/testbuffer/pic/sim_pex/ac_tb_amplifier_psrr/psrr_n_1k.png]
psrr_n_1k
