christoph-weiser/gf180mcu_cw_ip_vref/doc/testbuffer/dc_tb_amplifier_icmr.md

# Simulation Results 

Simulation results for dc_tb_amplifier_icmr

## Pre-Layout Simulation

| | min | max | mean | std |
|:---|:---|:---|:---|:---|
| vin_min  | 328.8146m | 759.9463m | 566.7406m | 102.0405m |
| icmr_min | 328.8146m | 759.9463m | 566.7406m | 102.0405m |
| vin_max  | 2.91150 | 4.98706 | 3.72923 | 890.2352m |
| icmr_max | 12.933m | 88.492m | 37.43636m | 17.40443m |

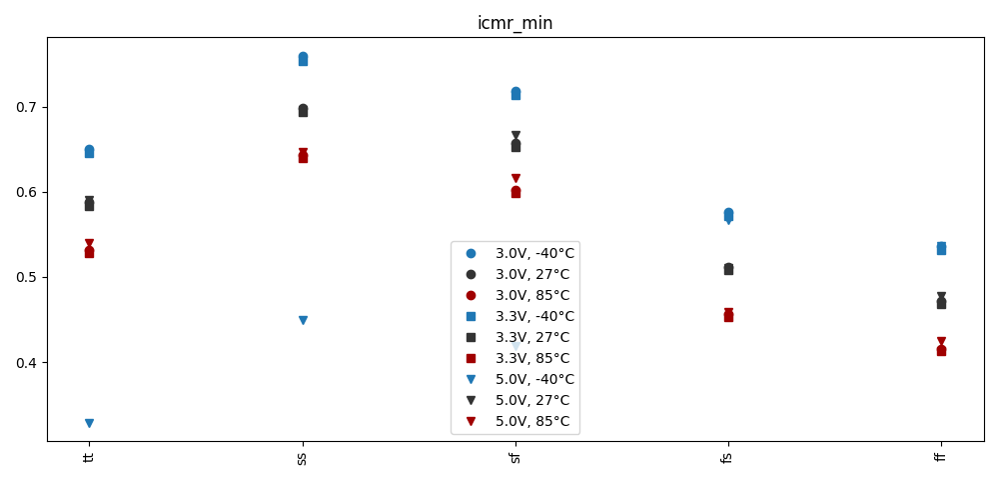
[picture p104: doc/testbuffer/pic/sim_sch/dc_tb_amplifier_icmr/icmr_min.png]
icmr_min

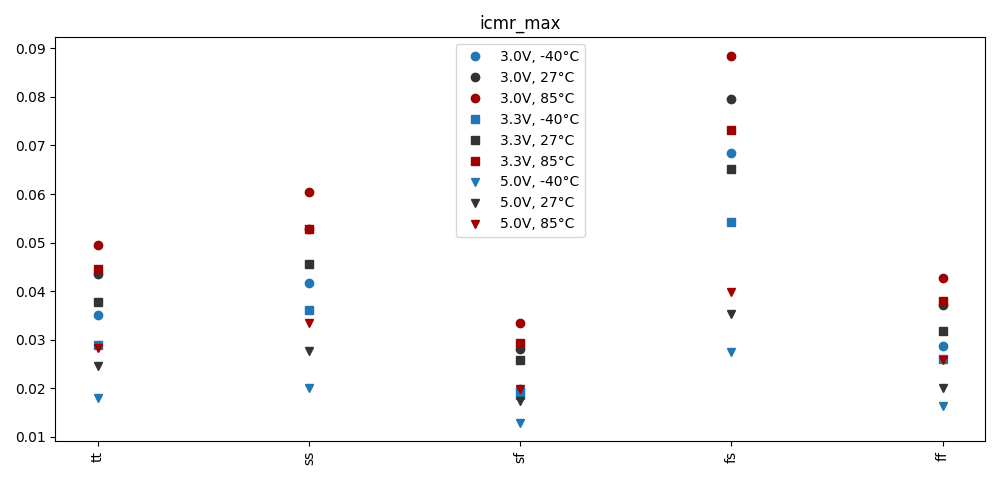
[picture p105: doc/testbuffer/pic/sim_sch/dc_tb_amplifier_icmr/icmr_max.png]
icmr_max


## Post-Layout Simulation

| | min | max | mean | std |
|:---|:---|:---|:---|:---|
| vin_min  | 412.5882m | 760.0589m | 587.1753m | 96.68055m |
| icmr_min | 412.5882m | 760.0589m | 587.1753m | 96.68055m |
| vin_max  | 2.91150 | 4.98707 | 3.72923 | 890.2362m |
| icmr_max | 12.928m | 88.491m | 37.435m | 17.4054m  |

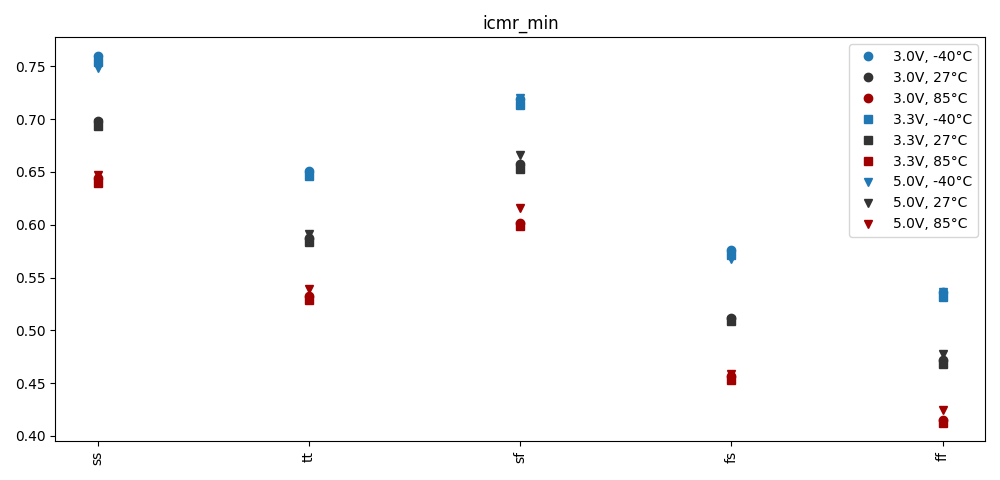
[picture p106: doc/testbuffer/pic/sim_pex/dc_tb_amplifier_icmr/icmr_min.png]
icmr_min

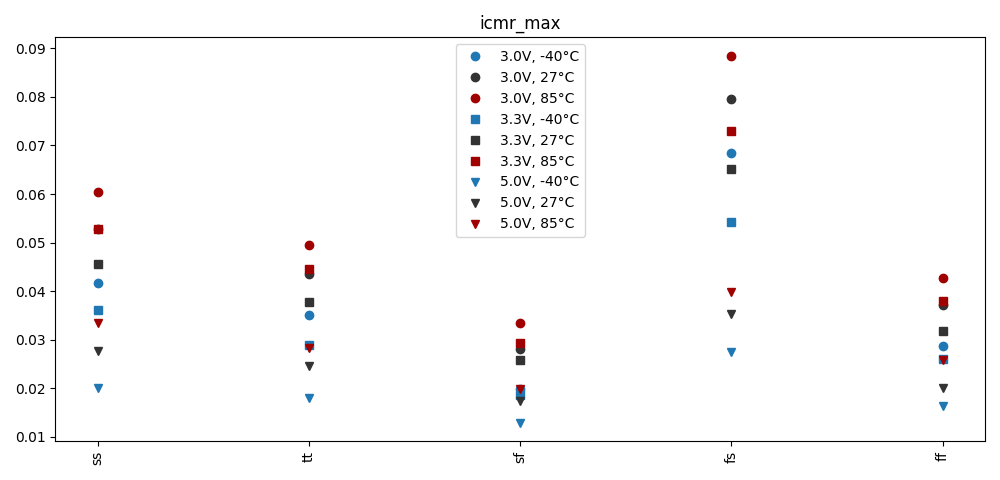
[picture p107: doc/testbuffer/pic/sim_pex/dc_tb_amplifier_icmr/icmr_max.png]
icmr_max
