christoph-weiser/gf180mcu_cw_ip_vref/doc/testbuffer/no_tb_amplifier.md

# Simulation Results 

Simulation results for no_tb_amplifier

## Pre-Layout Simulation

| | min | max | mean | std |
|:---|:---|:---|:---|:---|
| inoise_total | 27.4658u  | 43.31215u | 35.35848u | 4.57442u  |

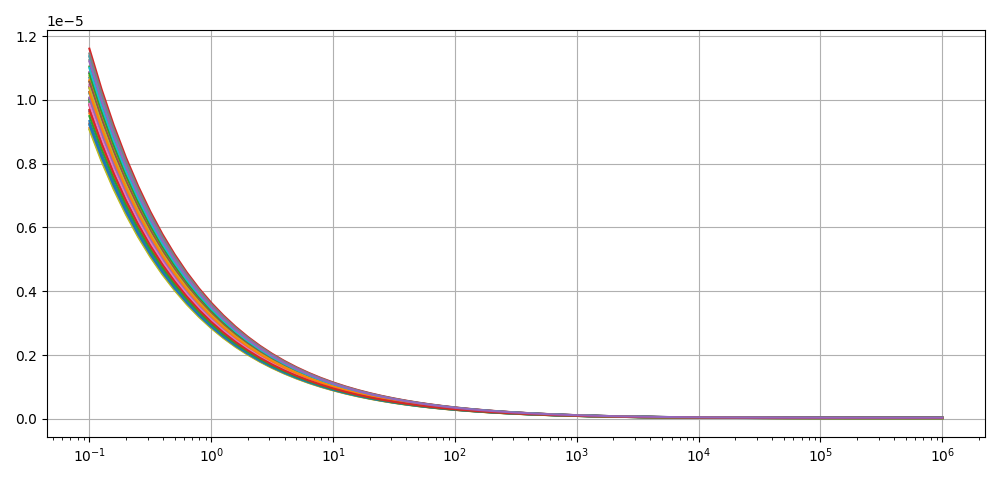
[picture p112: doc/testbuffer/pic/sim_sch/no_tb_amplifier/inoise.png]
inoise


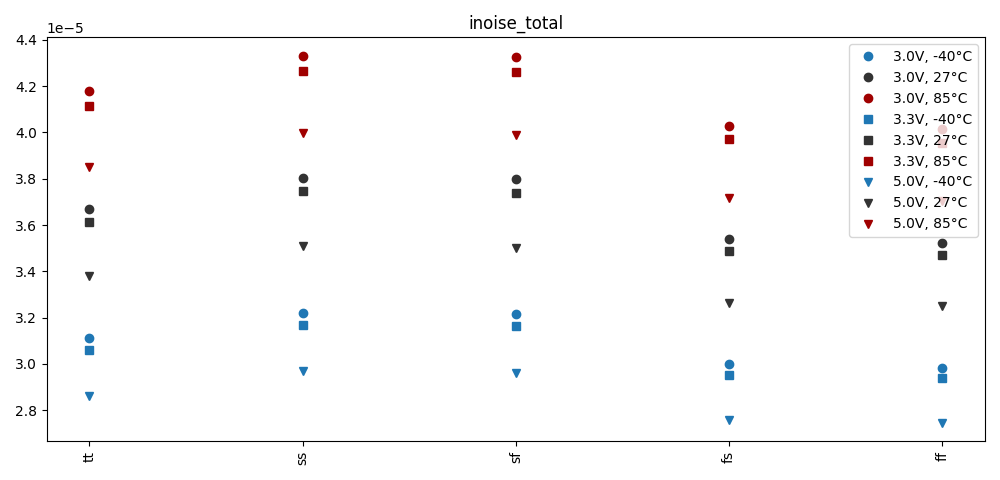
[picture p113: doc/testbuffer/pic/sim_sch/no_tb_amplifier/inoise_total.png]
inoise_total


## Post-Layout Simulation

| | min | max | mean | std |
|:---|:---|:---|:---|:---|
| inoise_total | 27.49043u | 43.34846u | 35.389u  | 4.57674u  |

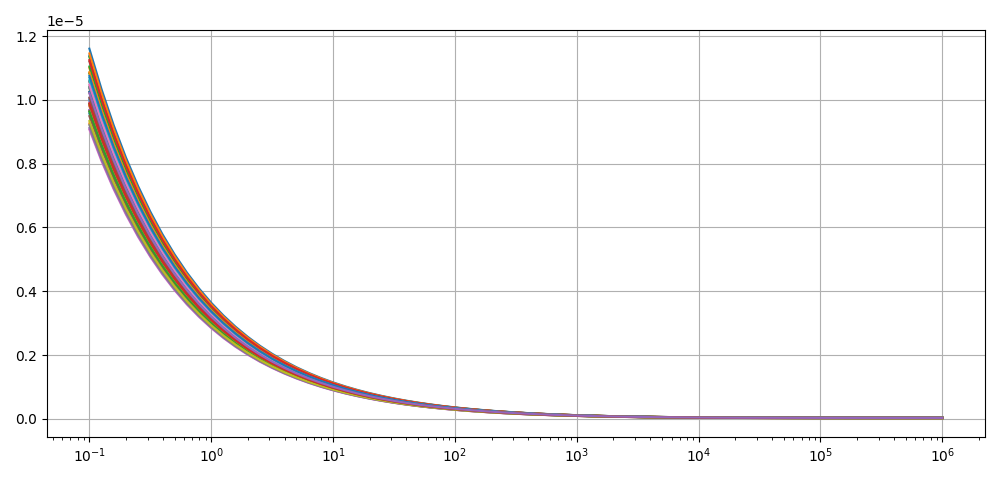
[picture p114: doc/testbuffer/pic/sim_pex/no_tb_amplifier/inoise.png]
inoise


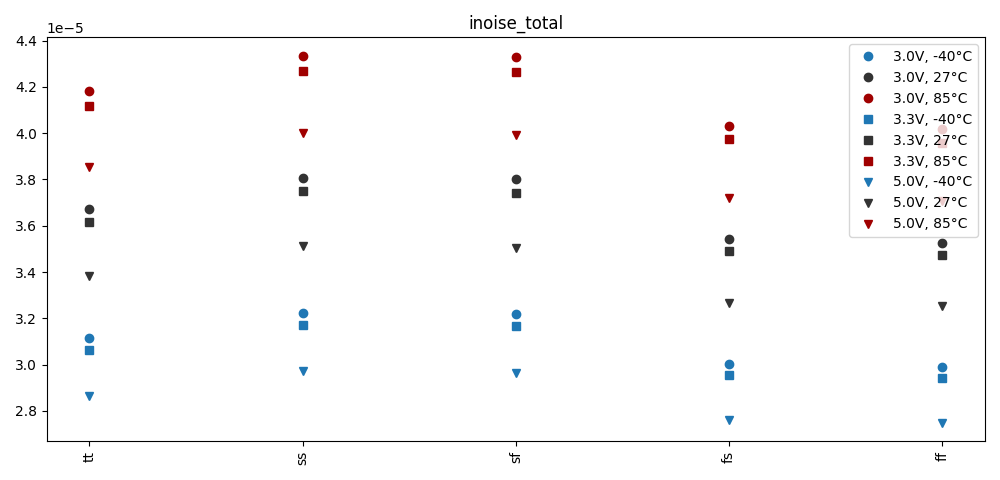
[picture p115: doc/testbuffer/pic/sim_pex/no_tb_amplifier/inoise_total.png]
inoise_total
