christoph-weiser/gf180mcu_cw_ip_vref/doc/testbuffer/tr_tb_amplifier_slew.md

# Simulation Results 

Simulation results for tr_tb_amplifier_slew

## Pre-Layout Simulation

| | min | max | mean | std |
|:---|:---|:---|:---|:---|
| sr_pos  | 2.88439M  | 3.77450M  | 3.21177M  | 247.14k |
| sr_neg  | 2.31689M  | 2.87512M  | 2.56397M  | 155.1168k |

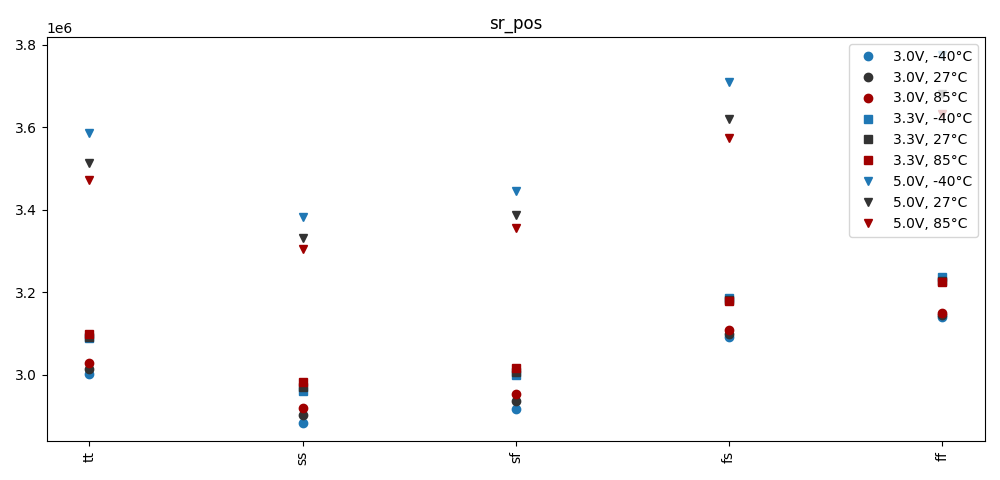
[picture p116: doc/testbuffer/pic/sim_sch/tr_tb_amplifier_slew/sr_pos.png]

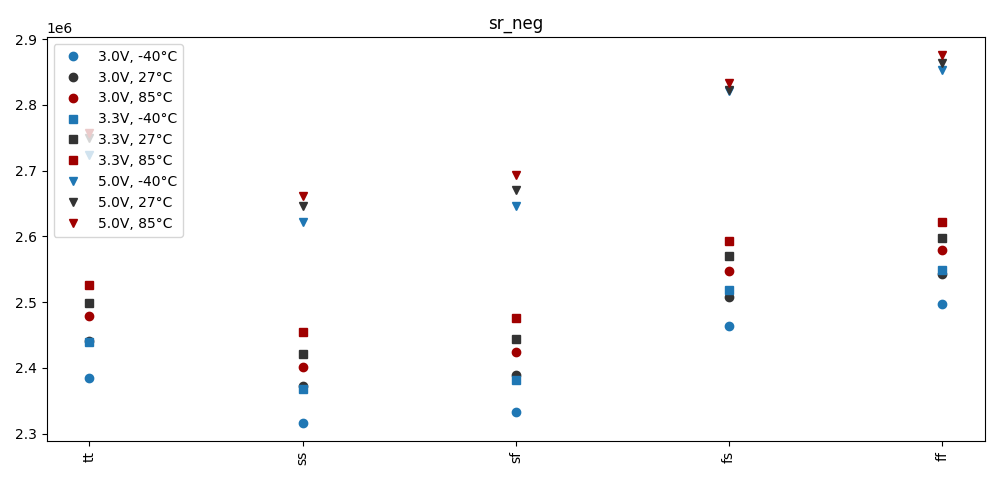
[picture p117: doc/testbuffer/pic/sim_sch/tr_tb_amplifier_slew/sr_neg.png]


## Post-Layout Simulation

| | min | max | mean | std |
|:---|:---|:---|:---|:---|
| sr_pos  | 2.88355M  | 3.77523M  | 3.21119M  | 247.0098k |
| sr_neg  | 2.30429M  | 2.86052M  | 2.55397M  | 155.2369k |

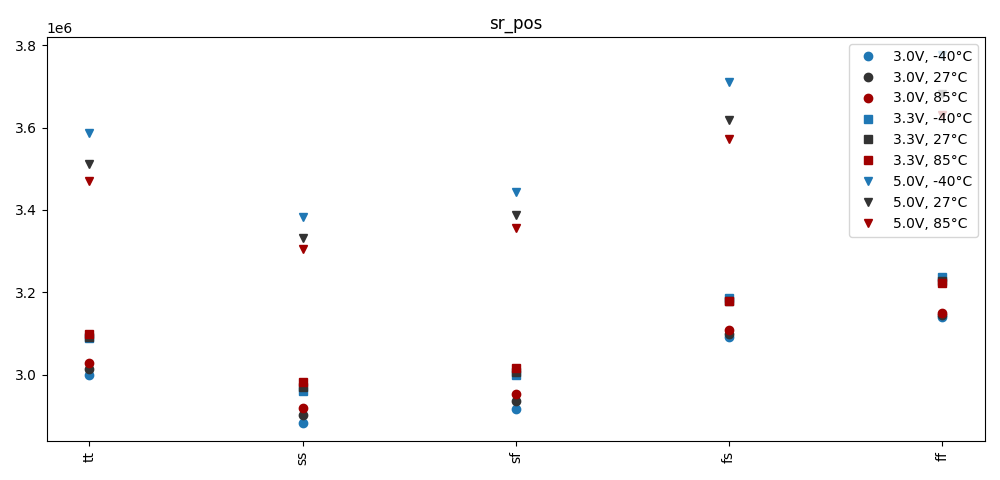
[picture p118: doc/testbuffer/pic/sim_pex/tr_tb_amplifier_slew/sr_pos.png]

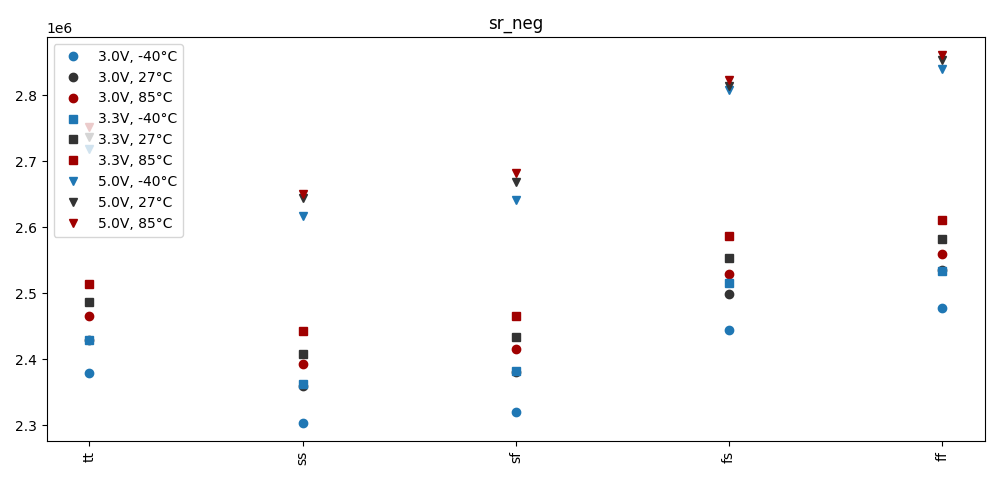
[picture p119: doc/testbuffer/pic/sim_pex/tr_tb_amplifier_slew/sr_neg.png]
