christoph-weiser/gf180mcu_cw_ip_vref/doc/testbuffer/op_tb_amplifier.md

# Simulation Results 

Simulation results for op_tb_amplifier

## Pre-Layout Simulation

| | min | max | mean | std |
|:---|:---|:---|:---|:---|
| id_xm1 | 2.28579u  | 2.84622u  | 2.54057u | 150.7684n |
| id_xm2 | 2.28558u  | 2.84492u  | 2.53989u | 150.6269n |
| id_xm4 | 2.28558u  | 2.84524u  | 2.53992u | 150.6662n |
| id_xmb1 | 4.99999u  | 5.00000u  | 4.99999u | 1.20779p  |
| id_xm5 | 4.57138u  | 5.69114u  | 5.08039u | 301.3606n |
| id_xm6 | 32.35317u | 39.14687u | 34.80915u  | 1.89415u  |
| id_xm3 | 2.28579u  | 2.84652u  | 2.54057u | 150.7892n |
| id_xm7 | 33.85321u | 41.64758u | 36.69295u  | 2.28729u  |
| id_xmb2 | 4.21708u  | 6.68118u  | 5.38986u | 647.4807n |
| id_xmb3 | 4.21708u  | 6.68155u  | 5.38996u | 647.6341n |
| id_xmb4 | 4.21708u  | 6.68154u  | 5.38995u | 647.6329n |
| gm_xm4 | 21.2649u  | 32.59083u | 25.84675u  | 2.79683u  |
| gm_xmb1 | 81.25665u | 118.7497u | 98.43662u  | 13.05831u |
| gm_xm5 | 78.5205u  | 130.5965u | 99.62703u  | 13.42088u |
| gm_xm6 | 520.2831u | 884.2992u | 667.6933u  | 97.23236u |
| gm_xm1 | 40.57791u | 66.85407u | 51.2648u | 6.62221u  |
| gm_xm2 | 40.56891u | 66.82813u | 51.24825u  | 6.62104u  |
| gm_xm3 | 21.26876u | 32.60111u | 25.85358u  | 2.79724u  |
| gm_xm7 | 304.3259u | 508.7748u | 387.3328u  | 49.0226u  |
| gm_xmb2 | 77.04428u | 150.2138u | 104.3642u  | 16.61674u |
| gm_xmb3 | 45.40499u | 82.52233u | 59.63922u  | 8.36105u  |
| gm_xmb4 | 45.11201u | 81.49818u | 59.05292u  | 8.12668u  |
| gds_xm1 | 115.5628n | 179.0793n | 144.6808n  | 17.86007n |
| gds_xm2 | 115.4065n | 178.6611n | 144.2854n  | 17.85822n |
| gds_xm4 | 27.06869n | 39.61464n | 32.37785n  | 2.92218n  |
| gds_xmb1 | 647.5557n | 1.01331u  | 828.251n | 115.5683n |
| gds_xm5 | 544.5705n | 1.05919u  | 818.0424n  | 134.3443n |
| gds_xm6 | 2.75626u  | 4.92377u  | 3.80411u | 534.6684n |
| gds_xm3 | 26.97711n | 38.69848n | 31.99672n  | 2.74545n  |
| gds_xm7 | 712.168n  | 1.10569u  | 918.1732n  | 99.30239n |
| gds_xmb2 | 464.9555n | 2.16953u  | 808.2079n  | 298.3222n |
| gds_xmb3 | 117.7186n | 237.0886n | 170.5207n  | 30.23741n |
| gds_xmb4 | 140.0299n | 288.4737n | 206.5863n  | 37.9621n  |
| vdsat_xm1  | 50.7144m  | 82.63359m | 65.97608m  | 10.80276m |
| vdsat_xm2  | 50.68726m | 82.6119m  | 65.94923m  | 10.79725m |
| vdsat_xm4  | 115.5309m | 178.6061m | 145.9701m  | 18.98317m |
| vdsat_xmb1 | 43.60908m | 70.12239m | 56.64522m  | 9.10936m  |
| vdsat_xm5  | 43.60908m | 70.12239m | 56.64522m  | 9.10936m  |
| vdsat_xm6  | 43.60909m | 70.1224m  | 56.64523m  | 9.10936m  |
| vdsat_xm3  | 115.5309m | 178.6061m | 145.9701m  | 18.98317m |
| vdsat_xm7  | 119.8208m | 189.2815m | 153.0801m  | 20.61315m |
| vdsat_xmb2 | 43.60908m | 70.1224m  | 56.64522m  | 9.10936m  |
| vdsat_xmb3 | 120.4202m | 200.1613m | 157.0221m  | 22.70576m |
| vdsat_xmb4 | 112.3552m | 186.3693m | 146.4291m  | 21.3607m  |
| vth_xm1 | 792.8543m | 1.34149 | 1.03701 | 140.0903m |
| vth_xm2 | 792.8543m | 1.34149 | 1.03701 | 140.0903m |
| vth_xm4 | 688.064m  | 1.09899 | 892.2202m  | 115.4598m |
| vth_xmb1 | 524.3686m | 926.5539m | 724.8095m  | 116.1086m |
| vth_xm5 | 524.3685m | 926.5539m | 724.8095m  | 116.1087m |
| vth_xm6 | 524.3685m | 926.5539m | 724.8095m  | 116.1087m |
| vth_xm3 | 688.064m  | 1.09899 | 892.2202m  | 115.4598m |
| vth_xm7 | 660.1865m | 1.08626 | 872.1574m  | 119.3326m |
| vth_xmb2 | 524.3684m | 926.5539m | 724.8095m  | 116.1087m |
| vth_xmb3 | 1.00246 | 1.53154 | 1.26930 | 150.0525m |
| vth_xmb4 | 660.3856m | 1.08628 | 872.2453m  | 119.3099m |
| vgs_xm1 | 803.8623m | 1.34285 | 1.04316 | 139.3543m |
| vgs_xm2 | 803.7432m | 1.34282 | 1.04309 | 139.3639m |
| vgs_xm4 | 854.9322m | 1.24461 | 1.04869 | 111.8593m |
| vgs_xmb1 | 529.5499m | 925.7523m | 727.4593m  | 115.9985m |
| vgs_xm5 | 529.5499m | 925.7523m | 727.4593m  | 115.9985m |
| vgs_xm6 | 529.5499m | 925.7523m | 727.4593m  | 115.9985m |
| vgs_xm3 | 854.9322m | 1.24461 | 1.04869 | 111.8593m |
| vgs_xm7 | 823.1867m | 1.23551 | 1.02866 | 118.228m  |
| vgs_xmb2 | 529.5499m | 925.7523m | 727.4593m  | 115.9985m |
| vgs_xmb3 | 1.15544 | 1.67660 | 1.41605 | 148.6165m |
| vgs_xmb4 | 815.6533m | 1.22862 | 1.01895 | 114.5361m |
| vds_xm1 | 1.23130 | 2.82005 | 1.87773 | 556.9416m |
| vds_xm2 | 1.24313 | 2.84948 | 1.89776 | 558.125m  |
| vds_xm4 | 823.187m  | 1.23551 | 1.02866 | 118.228m  |
| vds_xmb1 | 529.5497m | 925.7521m | 727.4591m  | 115.9985m |
| vds_xm5 | 413.904m  | 1.44397 | 840.2361m  | 339.3929m |
| vds_xm6 | 1.50002 | 2.50010 | 1.88340 | 440.3265m |
| vds_xm3 | 854.9321m | 1.24461 | 1.04869 | 111.8593m |
| vds_xm7 | 1.49988 | 2.49997 | 1.88326 | 440.3298m |
| vds_xmb2 | 153.6208m | 2.98068 | 1.33166 | 897.2315m |
| vds_xmb3 | 1.15544 | 1.67660 | 1.41605 | 148.6165m |
| vds_xmb4 | 815.6529m | 1.22862 | 1.01894 | 114.536m  |
| vsat_xm1 | 1.17228 | 2.73809 | 1.81176 | 555.329m  |
| vsat_xm2 | 1.19184 | 2.76757 | 1.83181 | 556.4521m |
| vsat_xm4 | 662.6483m | 1.10541 | 882.6933m  | 124.0581m |
| vsat_xmb1  | 464.8257m | 878.2606m | 670.8139m  | 119.221m  |
| vsat_xm5 | 366.4125m | 1.37925 | 783.591m | 338.8471m |
| vsat_xm6 | 1.42993 | 2.45646 | 1.82675 | 440.4204m |
| vsat_xm3 | 694.3933m | 1.11450 | 902.7232m  | 117.6164m |
| vsat_xm7 | 1.31805 | 2.37423 | 1.73018 | 437.7848m |
| vsat_xmb2  | 106.1293m | 2.91595 | 1.27501 | 896.3867m |
| vsat_xmb3  | 985.8548m | 1.53088 | 1.25903 | 152.8132m |
| vsat_xmb4  | 656.1005m | 1.09399 | 872.5201m  | 121.1415m |
| vov_xm1 | -3.8103m  | 16.80866m | 6.15307m | 6.47413m  |
| vov_xm2 | -3.88643m | 16.75245m | 6.08326m | 6.46387m  |
| vov_xm4 | 122.3066m | 195.2971m | 156.4731m  | 19.77771m |
| vov_xmb1 | -9.77164m | 17.47461m | 2.64975m | 7.91729m  |
| vov_xm5 | -9.77164m | 17.47463m | 2.64975m | 7.91729m  |
| vov_xm6 | -9.77162m | 17.47466m | 2.64978m | 7.91729m  |
| vov_xm3 | 122.3066m | 195.2971m | 156.4731m  | 19.77771m |
| vov_xm7 | 118.8249m | 199.2006m | 156.5056m  | 22.23618m |
| vov_xmb2 | -9.77164m | 17.47466m | 2.64977m | 7.91729m  |
| vov_xmb3 | 110.2541m | 192.0348m | 146.7512m  | 21.44678m |
| vov_xmb4 | 107.4089m | 195.1126m | 146.7043m  | 23.4412m  |
| comp | 1.77396 | 4.16676 | 2.73800 | 884.2457m |
| vbm | 153.6211m | 2.98068 | 1.33166 | 897.2316m |
| vbt | 1.79714 | 4.16398 | 2.74771 | 878.4243m |
| mirr | 1.76613 | 4.13411 | 2.71797 | 882.9731m |
| vcm | 413.9043m | 1.44397 | 840.2366m  | 339.393m  |
| bias | 529.5501m | 925.7525m | 727.4595m  | 115.9985m |
| in | 1.5 | 2.5 | 1.88333 | 440.3282m |
| out | 1.50002 | 2.50010 | 1.88340 | 440.3265m |
| voff | -119.097u | -27.6961u | -69.81961u | 23.50588u |
