christoph-weiser/gf180mcu_cw_ip_vref/doc/testbuffer/pic/sim_pex/tr_tb_amplifier_slew/slew.png

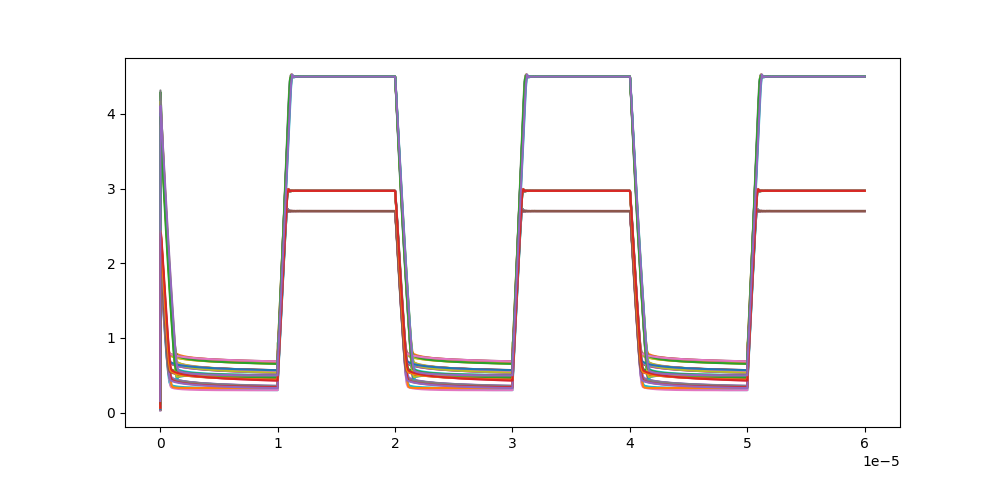
doc/testbuffer/pic/sim_pex/tr_tb_amplifier_slew/slew.png
