christoph-weiser/gf180mcu_cw_ip_vref/validate/lvs/lay_gf180mcu_cw_ip_vref_hier.spice

* Layout netlist hierachical

Xgf__bandgap_cm_0 w_41706_23485# m3_53511_9912# m2_50770_8396# m2_49918_7454# m3_64941_21277#
+ m2_36786_6525# w_9284_9257# m2_50202_7790# m2_36502_6193# VAPWR m3_58309_21277#
+ m2_37354_7139# m2_37070_6795# m2_50486_8120# VGND gf__bandgap_cm
Xgf__spdt_group_0 m3_62910_8048# m3_63806_8346# VAPWR w_55284_17504# m3_64941_21277#
+ vext m3_65487_22109# m3_58309_21277# vout m3_60905_21401# VGND gf__spdt_group
Xgf__testbuffer_0 w_55284_25430# VAPWR m3_60905_21401# m3_65487_22109# VGND bias gf__testbuffer
Xgf__levelshifter_0[0] en VDPWR VAPWR m3_53511_9912# VDPWR VAPWR VGND VGND gf__levelshifter
Xgf__levelshifter_0[1] trim[0] VDPWR VAPWR m2_50770_8396# VDPWR VAPWR VGND VGND gf__levelshifter
Xgf__levelshifter_0[2] trim[1] VDPWR VAPWR m2_50486_8120# VDPWR VAPWR VGND VGND gf__levelshifter
Xgf__levelshifter_0[3] trim[2] VDPWR VAPWR m2_50202_7790# VDPWR VAPWR VGND VGND gf__levelshifter
Xgf__levelshifter_0[4] trim[3] VDPWR VAPWR m2_49918_7454# VDPWR VAPWR VGND VGND gf__levelshifter
Xgf__levelshifter_0[5] trim[4] VDPWR VAPWR m2_37354_7139# VDPWR VAPWR VGND VGND gf__levelshifter
Xgf__levelshifter_0[6] trim[5] VDPWR VAPWR m2_37070_6795# VDPWR VAPWR VGND VGND gf__levelshifter
Xgf__levelshifter_0[7] trim[6] VDPWR VAPWR m2_36786_6525# VDPWR VAPWR VGND VGND gf__levelshifter
Xgf__levelshifter_0[8] trim[7] VDPWR VAPWR m2_36502_6193# VDPWR VAPWR VGND VGND gf__levelshifter
Xgf__levelshifter_0[9] dsw[0] VDPWR VAPWR m3_62910_8048# VDPWR VAPWR VGND VGND gf__levelshifter
Xgf__levelshifter_0[10] dsw[1] VDPWR VAPWR m3_63806_8346# VDPWR VAPWR VGND VGND gf__levelshifter


.subckt nfet_06v0_8u_8u_1nf a_192_272# a_280_180# a_1880_272# a_48_48#
X0 a_1880_272# a_280_180# a_192_272# a_48_48# nfet_06v0 ad=3.52p pd=16.88u as=3.52p ps=16.88u w=8u l=8u
.ends

.subckt bg__mb2_mb3 m2_61_3679# m2_61_4900# m2_61_2331# m2_61_5655# m2_61_4307# m2_61_2924#
+ VSUBS
Xnfet_06v0_8u_8u_1nf_0[0|0] VSUBS VSUBS VSUBS VSUBS nfet_06v0_8u_8u_1nf
Xnfet_06v0_8u_8u_1nf_0[1|0] VSUBS VSUBS VSUBS VSUBS nfet_06v0_8u_8u_1nf
Xnfet_06v0_8u_8u_1nf_0[2|0] VSUBS VSUBS VSUBS VSUBS nfet_06v0_8u_8u_1nf
Xnfet_06v0_8u_8u_1nf_0[3|0] VSUBS VSUBS VSUBS VSUBS nfet_06v0_8u_8u_1nf
Xnfet_06v0_8u_8u_1nf_0[0|1] VSUBS VSUBS VSUBS VSUBS nfet_06v0_8u_8u_1nf
Xnfet_06v0_8u_8u_1nf_0[1|1] m2_61_2924# m2_61_3679# m2_61_3679# VSUBS nfet_06v0_8u_8u_1nf
Xnfet_06v0_8u_8u_1nf_0[2|1] m2_61_4900# m2_61_5655# m2_61_5655# VSUBS nfet_06v0_8u_8u_1nf
Xnfet_06v0_8u_8u_1nf_0[3|1] VSUBS VSUBS VSUBS VSUBS nfet_06v0_8u_8u_1nf
Xnfet_06v0_8u_8u_1nf_0[0|2] VSUBS VSUBS VSUBS VSUBS nfet_06v0_8u_8u_1nf
Xnfet_06v0_8u_8u_1nf_0[1|2] m2_61_2924# m2_61_3679# m2_61_2331# VSUBS nfet_06v0_8u_8u_1nf
Xnfet_06v0_8u_8u_1nf_0[2|2] m2_61_4307# m2_61_5655# m2_61_4900# VSUBS nfet_06v0_8u_8u_1nf
Xnfet_06v0_8u_8u_1nf_0[3|2] VSUBS VSUBS VSUBS VSUBS nfet_06v0_8u_8u_1nf
Xnfet_06v0_8u_8u_1nf_0[0|3] VSUBS VSUBS VSUBS VSUBS nfet_06v0_8u_8u_1nf
Xnfet_06v0_8u_8u_1nf_0[1|3] m2_61_3679# m2_61_3679# m2_61_2924# VSUBS nfet_06v0_8u_8u_1nf
Xnfet_06v0_8u_8u_1nf_0[2|3] m2_61_5655# m2_61_5655# m2_61_4900# VSUBS nfet_06v0_8u_8u_1nf
Xnfet_06v0_8u_8u_1nf_0[3|3] VSUBS VSUBS VSUBS VSUBS nfet_06v0_8u_8u_1nf
Xnfet_06v0_8u_8u_1nf_0[0|4] VSUBS VSUBS VSUBS VSUBS nfet_06v0_8u_8u_1nf
Xnfet_06v0_8u_8u_1nf_0[1|4] VSUBS VSUBS VSUBS VSUBS nfet_06v0_8u_8u_1nf
Xnfet_06v0_8u_8u_1nf_0[2|4] VSUBS VSUBS VSUBS VSUBS nfet_06v0_8u_8u_1nf
Xnfet_06v0_8u_8u_1nf_0[3|4] VSUBS VSUBS VSUBS VSUBS nfet_06v0_8u_8u_1nf
.ends

.subckt nfet_06v0_2u_1u_1nf a_480_272# a_192_272# a_280_180# a_48_48#
X0 a_480_272# a_280_180# a_192_272# a_48_48# nfet_06v0 ad=0.88p pd=4.88u as=0.88p ps=4.88u w=2u l=1u
.ends

.subckt pfet_06v0_2u_1u_1nf a_480_272# a_192_272# a_280_180# w_16_16#
X0 a_480_272# a_280_180# a_192_272# w_16_16# pfet_06v0 ad=0.88p pd=4.88u as=0.88p ps=4.88u w=2u l=1u
.ends

.subckt bg__mi1_mi2_me1_me2_me3_me4 m2_294_694# via__M1_M2_SQU_0/m1_0_0# via__M1_M2_SQU_1/m1_0_0#
+ via__M1_M2_SQU_2/m1_0_0# via__M1_M2_SQU_3/m1_0_0# VSUBS m1_61_1458#
Xnfet_06v0_2u_1u_1nf_0[0] m2_498_378# VSUBS m2_294_694# VSUBS nfet_06v0_2u_1u_1nf
Xnfet_06v0_2u_1u_1nf_0[1] via__M1_M2_SQU_2/m1_0_0# VSUBS m2_498_378# VSUBS nfet_06v0_2u_1u_1nf
Xnfet_06v0_2u_1u_1nf_0[2] via__M1_M2_SQU_3/m1_0_0# VSUBS m2_498_378# VSUBS nfet_06v0_2u_1u_1nf
Xpfet_06v0_2u_1u_1nf_0[0] m2_498_378# m1_61_1458# m2_294_694# m1_61_1458# pfet_06v0_2u_1u_1nf
Xpfet_06v0_2u_1u_1nf_0[1] via__M1_M2_SQU_0/m1_0_0# m1_61_1458# m2_294_694# m1_61_1458#
+ pfet_06v0_2u_1u_1nf
Xpfet_06v0_2u_1u_1nf_0[2] via__M1_M2_SQU_1/m1_0_0# m1_61_1458# m2_294_694# m1_61_1458#
+ pfet_06v0_2u_1u_1nf
.ends

.subckt nfet_06v0_1u_1u_1nf a_480_272# a_192_272# a_280_180# a_48_48#
X0 a_480_272# a_280_180# a_192_272# a_48_48# nfet_06v0 ad=0.44p pd=2.88u as=0.44p ps=2.88u w=1u l=1u
.ends

.subckt cap_mim_10u_10u m4_120_120# m4_0_0#
X0 m4_120_120# m4_0_0# cap_mim_2f0_m4m5_noshield c_width=10u c_length=10u
.ends

.subckt bg__ms1_ms2_ms3_ms4_c1 m2_61_286# m2_935_505# m2_2274_286# m2_294_505# via__M1_M2_MIN_0/m1_0_0#
+ VSUBS
Xnfet_06v0_1u_1u_1nf_0[0] VSUBS m2_61_286# m2_294_505# VSUBS nfet_06v0_1u_1u_1nf
Xnfet_06v0_1u_1u_1nf_0[1] m2_1090_286# m2_294_505# m2_935_505# VSUBS nfet_06v0_1u_1u_1nf
Xnfet_06v0_1u_1u_1nf_0[2] VSUBS m2_1090_286# via__M1_M2_MIN_0/m1_0_0# VSUBS nfet_06v0_1u_1u_1nf
Xnfet_06v0_1u_1u_1nf_0[3] m2_2274_286# m2_1090_286# m2_935_505# VSUBS nfet_06v0_1u_1u_1nf
Xcap_mim_10u_10u_0 m2_2274_286# VSUBS cap_mim_10u_10u
.ends

.subckt ppoly_u_1k_6p0_1u_20u w_8_8# a_244_244# a_244_4366#
X0 a_244_4366# a_244_244# w_8_8# ppolyf_u_1k_6p0 r_width=1u r_length=20u
.ends

.subckt bg__r1_r2_r3_ro m2_9068_4406# m2_7412_4406# m3_14588_n259# m2_1892_n259# m3_22868_n259#
+ m3_9620_n259# m2_27284_n259# m2_28388_4406# w_n24_n40#
Xppoly_u_1k_6p0_1u_20u_0[0] w_n24_n40# w_n24_n40# w_n24_n40# ppoly_u_1k_6p0_1u_20u
Xppoly_u_1k_6p0_1u_20u_0[1] w_n24_n40# w_n24_n40# w_n24_n40# ppoly_u_1k_6p0_1u_20u
Xppoly_u_1k_6p0_1u_20u_0[2] w_n24_n40# w_n24_n40# w_n24_n40# ppoly_u_1k_6p0_1u_20u
Xppoly_u_1k_6p0_1u_20u_0[3] w_n24_n40# m2_1892_n259# m2_1892_4406# ppoly_u_1k_6p0_1u_20u
Xppoly_u_1k_6p0_1u_20u_0[4] w_n24_n40# m2_2444_234# m2_1892_4406# ppoly_u_1k_6p0_1u_20u
Xppoly_u_1k_6p0_1u_20u_0[5] w_n24_n40# m2_2444_234# m2_2996_4406# ppoly_u_1k_6p0_1u_20u
Xppoly_u_1k_6p0_1u_20u_0[6] w_n24_n40# m2_3548_234# m2_2996_4406# ppoly_u_1k_6p0_1u_20u
Xppoly_u_1k_6p0_1u_20u_0[7] w_n24_n40# m2_3548_234# m2_4100_4406# ppoly_u_1k_6p0_1u_20u
Xppoly_u_1k_6p0_1u_20u_0[8] w_n24_n40# m2_4652_234# m2_4100_4406# ppoly_u_1k_6p0_1u_20u
Xppoly_u_1k_6p0_1u_20u_0[9] w_n24_n40# m2_4652_234# m2_5204_4406# ppoly_u_1k_6p0_1u_20u
Xppoly_u_1k_6p0_1u_20u_0[10] w_n24_n40# m2_5756_234# m2_5204_4406# ppoly_u_1k_6p0_1u_20u
Xppoly_u_1k_6p0_1u_20u_0[11] w_n24_n40# m2_5756_234# m2_6308_4406# ppoly_u_1k_6p0_1u_20u
Xppoly_u_1k_6p0_1u_20u_0[12] w_n24_n40# m2_6860_234# m2_6308_4406# ppoly_u_1k_6p0_1u_20u
Xppoly_u_1k_6p0_1u_20u_0[13] w_n24_n40# m2_6860_234# m2_7412_4406# ppoly_u_1k_6p0_1u_20u
Xppoly_u_1k_6p0_1u_20u_0[14] w_n24_n40# w_n24_n40# w_n24_n40# ppoly_u_1k_6p0_1u_20u
Xppoly_u_1k_6p0_1u_20u_0[15] w_n24_n40# w_n24_n40# w_n24_n40# ppoly_u_1k_6p0_1u_20u
Xppoly_u_1k_6p0_1u_20u_0[16] w_n24_n40# m2_9068_n166# m2_9068_4406# ppoly_u_1k_6p0_1u_20u
Xppoly_u_1k_6p0_1u_20u_0[17] w_n24_n40# m3_9620_n259# m2_9620_4406# ppoly_u_1k_6p0_1u_20u
Xppoly_u_1k_6p0_1u_20u_0[18] w_n24_n40# m2_9068_n166# m2_10172_4406# ppoly_u_1k_6p0_1u_20u
Xppoly_u_1k_6p0_1u_20u_0[19] w_n24_n40# m2_10724_n166# m2_10172_4406# ppoly_u_1k_6p0_1u_20u
Xppoly_u_1k_6p0_1u_20u_0[20] w_n24_n40# m2_11276_234# m2_9620_4406# ppoly_u_1k_6p0_1u_20u
Xppoly_u_1k_6p0_1u_20u_0[21] w_n24_n40# m2_11276_234# m2_11828_4406# ppoly_u_1k_6p0_1u_20u
Xppoly_u_1k_6p0_1u_20u_0[22] w_n24_n40# m2_10724_n166# m2_12380_4406# ppoly_u_1k_6p0_1u_20u
Xppoly_u_1k_6p0_1u_20u_0[23] w_n24_n40# m2_12932_n166# m2_12380_4406# ppoly_u_1k_6p0_1u_20u
Xppoly_u_1k_6p0_1u_20u_0[24] w_n24_n40# m2_13484_234# m2_11828_4406# ppoly_u_1k_6p0_1u_20u
Xppoly_u_1k_6p0_1u_20u_0[25] w_n24_n40# m2_13484_234# m2_14036_4406# ppoly_u_1k_6p0_1u_20u
Xppoly_u_1k_6p0_1u_20u_0[26] w_n24_n40# m3_14588_n259# m2_14588_3806# ppoly_u_1k_6p0_1u_20u
Xppoly_u_1k_6p0_1u_20u_0[27] w_n24_n40# m2_12932_n166# m2_15140_4406# ppoly_u_1k_6p0_1u_20u
Xppoly_u_1k_6p0_1u_20u_0[28] w_n24_n40# m2_15692_n166# m2_15140_4406# ppoly_u_1k_6p0_1u_20u
Xppoly_u_1k_6p0_1u_20u_0[29] w_n24_n40# m2_16244_234# m2_14036_4406# ppoly_u_1k_6p0_1u_20u
Xppoly_u_1k_6p0_1u_20u_0[30] w_n24_n40# m2_16244_234# m2_16796_4406# ppoly_u_1k_6p0_1u_20u
Xppoly_u_1k_6p0_1u_20u_0[31] w_n24_n40# m2_15692_n166# m2_17348_4406# ppoly_u_1k_6p0_1u_20u
Xppoly_u_1k_6p0_1u_20u_0[32] w_n24_n40# m2_17900_n166# m2_17348_4406# ppoly_u_1k_6p0_1u_20u
Xppoly_u_1k_6p0_1u_20u_0[33] w_n24_n40# m2_18452_234# m2_16796_4406# ppoly_u_1k_6p0_1u_20u
Xppoly_u_1k_6p0_1u_20u_0[34] w_n24_n40# m2_18452_234# m2_19004_4406# ppoly_u_1k_6p0_1u_20u
Xppoly_u_1k_6p0_1u_20u_0[35] w_n24_n40# m2_17900_n166# m2_19556_4406# ppoly_u_1k_6p0_1u_20u
Xppoly_u_1k_6p0_1u_20u_0[36] w_n24_n40# m2_20108_n166# m2_19556_4406# ppoly_u_1k_6p0_1u_20u
Xppoly_u_1k_6p0_1u_20u_0[37] w_n24_n40# m2_20660_234# m2_19004_4406# ppoly_u_1k_6p0_1u_20u
Xppoly_u_1k_6p0_1u_20u_0[38] w_n24_n40# m2_20660_234# m2_21212_4406# ppoly_u_1k_6p0_1u_20u
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
Xpfet_06v0_8u_8u_1nf_0[0|6] m1_107_107# m1_107_107# m1_107_107# m1_107_107# pfet_06v0_8u_8u_1nf
Xpfet_06v0_8u_8u_1nf_0[1|6] m2_61_3254# m2_61_3846# m1_107_107# m2_61_3498# pfet_06v0_8u_8u_1nf
Xpfet_06v0_8u_8u_1nf_0[2|6] m2_61_5230# m2_61_5822# m1_107_107# m2_61_5474# pfet_06v0_8u_8u_1nf
Xpfet_06v0_8u_8u_1nf_0[3|6] m1_107_107# m1_107_107# m1_107_107# m1_107_107# pfet_06v0_8u_8u_1nf
Xpfet_06v0_8u_8u_1nf_0[0|7] m1_107_107# m1_107_107# m1_107_107# m1_107_107# pfet_06v0_8u_8u_1nf
Xpfet_06v0_8u_8u_1nf_0[1|7] m2_61_3498# m2_61_3846# m1_107_107# m2_61_3010# pfet_06v0_8u_8u_1nf
Xpfet_06v0_8u_8u_1nf_0[2|7] m2_61_5474# m2_61_5822# m1_107_107# m2_61_4986# pfet_06v0_8u_8u_1nf
Xpfet_06v0_8u_8u_1nf_0[3|7] m1_107_107# m1_107_107# m1_107_107# m1_107_107# pfet_06v0_8u_8u_1nf
Xpfet_06v0_8u_8u_1nf_0[0|8] m1_107_107# m1_107_107# m1_107_107# m1_107_107# pfet_06v0_8u_8u_1nf
Xpfet_06v0_8u_8u_1nf_0[1|8] m2_61_2522# m2_61_3846# m1_107_107# m2_61_3498# pfet_06v0_8u_8u_1nf
Xpfet_06v0_8u_8u_1nf_0[2|8] m2_61_4498# m2_61_5822# m1_107_107# m2_61_5474# pfet_06v0_8u_8u_1nf
Xpfet_06v0_8u_8u_1nf_0[3|8] m1_107_107# m1_107_107# m1_107_107# m1_107_107# pfet_06v0_8u_8u_1nf
Xpfet_06v0_8u_8u_1nf_0[0|9] m1_107_107# m1_107_107# m1_107_107# m1_107_107# pfet_06v0_8u_8u_1nf
Xpfet_06v0_8u_8u_1nf_0[1|9] m2_61_3498# m2_61_3846# m1_107_107# m2_61_2766# pfet_06v0_8u_8u_1nf
Xpfet_06v0_8u_8u_1nf_0[2|9] m2_61_5474# m2_61_5822# m1_107_107# m2_61_5230# pfet_06v0_8u_8u_1nf
Xpfet_06v0_8u_8u_1nf_0[3|9] m1_107_107# m1_107_107# m1_107_107# m1_107_107# pfet_06v0_8u_8u_1nf
Xpfet_06v0_8u_8u_1nf_0[0|10] m1_107_107# m1_107_107# m1_107_107# m1_107_107# pfet_06v0_8u_8u_1nf
Xpfet_06v0_8u_8u_1nf_0[1|10] m2_61_2278# m2_61_3846# m1_107_107# m2_61_3498# pfet_06v0_8u_8u_1nf
Xpfet_06v0_8u_8u_1nf_0[2|10] m2_61_4254# m2_61_5822# m1_107_107# m2_61_5474# pfet_06v0_8u_8u_1nf
Xpfet_06v0_8u_8u_1nf_0[3|10] m1_107_107# m1_107_107# m1_107_107# m1_107_107# pfet_06v0_8u_8u_1nf
Xpfet_06v0_8u_8u_1nf_0[0|11] m1_107_107# m1_107_107# m1_107_107# m1_107_107# pfet_06v0_8u_8u_1nf
Xpfet_06v0_8u_8u_1nf_0[1|11] m1_107_107# m1_107_107# m1_107_107# m1_107_107# pfet_06v0_8u_8u_1nf
Xpfet_06v0_8u_8u_1nf_0[2|11] m1_107_107# m1_107_107# m1_107_107# m1_107_107# pfet_06v0_8u_8u_1nf
Xpfet_06v0_8u_8u_1nf_0[3|11] m1_107_107# m1_107_107# m1_107_107# m1_107_107# pfet_06v0_8u_8u_1nf
.ends

.subckt ppolyf_u_1k_6p0_1u_5u w_8_8# a_244_244# a_244_1366#
X0 a_244_1366# a_244_244# w_8_8# ppolyf_u_1k_6p0 r_width=1u r_length=5u
.ends

.subckt bgt__runits m2_4636_218# via__M1_M2_SQU_89/m1_0_0# m2_7948_2986# m2_5740_218#
+ m2_2428_218# m2_7948_1814# m2_5740_2986# m2_4084_2986# m2_3532_218# m2_5740_1390#
+ w_n40_n40# m2_4636_1390#
Xppolyf_u_1k_6p0_1u_5u_0[0|0] w_n40_n40# w_n40_n40# w_n40_n40# ppolyf_u_1k_6p0_1u_5u
Xppolyf_u_1k_6p0_1u_5u_0[1|0] w_n40_n40# w_n40_n40# w_n40_n40# ppolyf_u_1k_6p0_1u_5u
Xppolyf_u_1k_6p0_1u_5u_0[0|1] w_n40_n40# via__M1_M2_SQU_89/m1_0_0# m2_772_1390# ppolyf_u_1k_6p0_1u_5u
Xppolyf_u_1k_6p0_1u_5u_0[1|1] w_n40_n40# m2_772_1390# m2_772_2986# ppolyf_u_1k_6p0_1u_5u
Xppolyf_u_1k_6p0_1u_5u_0[0|2] w_n40_n40# m2_1324_218# m2_1324_1390# ppolyf_u_1k_6p0_1u_5u
Xppolyf_u_1k_6p0_1u_5u_0[1|2] w_n40_n40# m2_1324_1390# m2_772_2986# ppolyf_u_1k_6p0_1u_5u
Xppolyf_u_1k_6p0_1u_5u_0[0|3] w_n40_n40# m2_1324_218# m2_1876_1390# ppolyf_u_1k_6p0_1u_5u
Xppolyf_u_1k_6p0_1u_5u_0[1|3] w_n40_n40# m2_1876_1390# m2_1876_2986# ppolyf_u_1k_6p0_1u_5u
Xppolyf_u_1k_6p0_1u_5u_0[0|4] w_n40_n40# m2_2428_218# m2_2428_1390# ppolyf_u_1k_6p0_1u_5u
Xppolyf_u_1k_6p0_1u_5u_0[1|4] w_n40_n40# m2_2428_1390# m2_1876_2986# ppolyf_u_1k_6p0_1u_5u
Xppolyf_u_1k_6p0_1u_5u_0[0|5] w_n40_n40# m2_2428_218# m2_2980_1390# ppolyf_u_1k_6p0_1u_5u
Xppolyf_u_1k_6p0_1u_5u_0[1|5] w_n40_n40# m2_2980_1390# m2_2980_2986# ppolyf_u_1k_6p0_1u_5u
Xppolyf_u_1k_6p0_1u_5u_0[0|6] w_n40_n40# m2_3532_218# m2_3532_1390# ppolyf_u_1k_6p0_1u_5u
Xppolyf_u_1k_6p0_1u_5u_0[1|6] w_n40_n40# m2_3532_1390# m2_2980_2986# ppolyf_u_1k_6p0_1u_5u
Xppolyf_u_1k_6p0_1u_5u_0[0|7] w_n40_n40# m2_3532_218# m2_4084_1390# ppolyf_u_1k_6p0_1u_5u
Xppolyf_u_1k_6p0_1u_5u_0[1|7] w_n40_n40# m2_4084_1390# m2_4084_2986# ppolyf_u_1k_6p0_1u_5u
Xppolyf_u_1k_6p0_1u_5u_0[0|8] w_n40_n40# m2_4636_218# m2_4636_1390# ppolyf_u_1k_6p0_1u_5u
Xppolyf_u_1k_6p0_1u_5u_0[1|8] w_n40_n40# m2_4636_1390# m2_4084_2986# ppolyf_u_1k_6p0_1u_5u
Xppolyf_u_1k_6p0_1u_5u_0[0|9] w_n40_n40# m2_4636_218# m2_4636_1390# ppolyf_u_1k_6p0_1u_5u
Xppolyf_u_1k_6p0_1u_5u_0[1|9] w_n40_n40# w_n40_n40# w_n40_n40# ppolyf_u_1k_6p0_1u_5u
Xppolyf_u_1k_6p0_1u_5u_0[0|10] w_n40_n40# m2_5740_218# m2_5740_1390# ppolyf_u_1k_6p0_1u_5u
Xppolyf_u_1k_6p0_1u_5u_0[1|10] w_n40_n40# m2_5740_1390# m2_5740_2986# ppolyf_u_1k_6p0_1u_5u
Xppolyf_u_1k_6p0_1u_5u_0[0|11] w_n40_n40# m2_5740_218# m2_5740_1390# ppolyf_u_1k_6p0_1u_5u
Xppolyf_u_1k_6p0_1u_5u_0[1|11] w_n40_n40# m2_5740_1390# m2_5740_2986# ppolyf_u_1k_6p0_1u_5u
Xppolyf_u_1k_6p0_1u_5u_0[0|12] w_n40_n40# m2_5740_218# m2_5740_1390# ppolyf_u_1k_6p0_1u_5u
Xppolyf_u_1k_6p0_1u_5u_0[1|12] w_n40_n40# m2_5740_1390# m2_5740_2986# ppolyf_u_1k_6p0_1u_5u
Xppolyf_u_1k_6p0_1u_5u_0[0|13] w_n40_n40# m2_5740_218# m2_5740_1390# ppolyf_u_1k_6p0_1u_5u
Xppolyf_u_1k_6p0_1u_5u_0[1|13] w_n40_n40# m2_5740_1390# m2_5740_2986# ppolyf_u_1k_6p0_1u_5u
Xppolyf_u_1k_6p0_1u_5u_0[0|14] w_n40_n40# m2_5740_218# m2_5740_1390# ppolyf_u_1k_6p0_1u_5u
Xppolyf_u_1k_6p0_1u_5u_0[1|14] w_n40_n40# m2_7948_1814# m2_7948_2986# ppolyf_u_1k_6p0_1u_5u
Xppolyf_u_1k_6p0_1u_5u_0[0|15] w_n40_n40# m2_5740_218# m2_5740_1390# ppolyf_u_1k_6p0_1u_5u
Xppolyf_u_1k_6p0_1u_5u_0[1|15] w_n40_n40# m2_7948_1814# m2_7948_2986# ppolyf_u_1k_6p0_1u_5u
Xppolyf_u_1k_6p0_1u_5u_0[0|16] w_n40_n40# m2_5740_218# m2_5740_1390# ppolyf_u_1k_6p0_1u_5u
Xppolyf_u_1k_6p0_1u_5u_0[1|16] w_n40_n40# m2_7948_1814# m2_7948_2986# ppolyf_u_1k_6p0_1u_5u
Xppolyf_u_1k_6p0_1u_5u_0[0|17] w_n40_n40# m2_5740_218# m2_5740_1390# ppolyf_u_1k_6p0_1u_5u
Xppolyf_u_1k_6p0_1u_5u_0[1|17] w_n40_n40# m2_7948_1814# m2_7948_2986# ppolyf_u_1k_6p0_1u_5u
Xppolyf_u_1k_6p0_1u_5u_0[0|18] w_n40_n40# m2_7948_2986# m2_7948_1814# ppolyf_u_1k_6p0_1u_5u
Xppolyf_u_1k_6p0_1u_5u_0[1|18] w_n40_n40# m2_7948_1814# m2_7948_2986# ppolyf_u_1k_6p0_1u_5u
Xppolyf_u_1k_6p0_1u_5u_0[0|19] w_n40_n40# m2_7948_2986# m2_7948_1814# ppolyf_u_1k_6p0_1u_5u
Xppolyf_u_1k_6p0_1u_5u_0[1|19] w_n40_n40# m2_7948_1814# m2_7948_2986# ppolyf_u_1k_6p0_1u_5u
Xppolyf_u_1k_6p0_1u_5u_0[0|20] w_n40_n40# m2_7948_2986# m2_7948_1814# ppolyf_u_1k_6p0_1u_5u
Xppolyf_u_1k_6p0_1u_5u_0[1|20] w_n40_n40# m2_7948_1814# m2_7948_2986# ppolyf_u_1k_6p0_1u_5u
Xppolyf_u_1k_6p0_1u_5u_0[0|21] w_n40_n40# m2_7948_2986# m2_7948_1814# ppolyf_u_1k_6p0_1u_5u
Xppolyf_u_1k_6p0_1u_5u_0[1|21] w_n40_n40# m2_7948_1814# m2_7948_2986# ppolyf_u_1k_6p0_1u_5u
Xppolyf_u_1k_6p0_1u_5u_0[0|22] w_n40_n40# m2_7948_2986# m2_7948_1814# ppolyf_u_1k_6p0_1u_5u
Xppolyf_u_1k_6p0_1u_5u_0[1|22] w_n40_n40# m2_7948_1814# m2_7948_2986# ppolyf_u_1k_6p0_1u_5u
Xppolyf_u_1k_6p0_1u_5u_0[0|23] w_n40_n40# m2_7948_2986# m2_7948_1814# ppolyf_u_1k_6p0_1u_5u
Xppolyf_u_1k_6p0_1u_5u_0[1|23] w_n40_n40# m2_7948_1814# m2_7948_2986# ppolyf_u_1k_6p0_1u_5u
Xppolyf_u_1k_6p0_1u_5u_0[0|24] w_n40_n40# w_n40_n40# w_n40_n40# ppolyf_u_1k_6p0_1u_5u
Xppolyf_u_1k_6p0_1u_5u_0[1|24] w_n40_n40# w_n40_n40# w_n40_n40# ppolyf_u_1k_6p0_1u_5u
.ends

.subckt nfet_06v0_8u_1u_4nf a_784_272# a_584_180# a_480_272# a_1392_272# a_192_272#
+ a_280_180# a_1192_180# a_1088_272# a_48_48# a_888_180#
X0 a_1392_272# a_1192_180# a_1088_272# a_48_48# nfet_06v0 ad=3.52p pd=16.88u as=2.08p ps=8.52u w=8u l=1u
X1 a_1088_272# a_888_180# a_784_272# a_48_48# nfet_06v0 ad=2.08p pd=8.52u as=2.08p ps=8.52u w=8u l=1u
X2 a_784_272# a_584_180# a_480_272# a_48_48# nfet_06v0 ad=2.08p pd=8.52u as=2.08p ps=8.52u w=8u l=1u
X3 a_480_272# a_280_180# a_192_272# a_48_48# nfet_06v0 ad=2.08p pd=8.52u as=3.52p ps=16.88u w=8u l=1u
.ends

.subckt bgt__trimsw m2_282_6043# m2_282_4067# m2_6221_479# m2_205_1215# m2_6221_7143#
+ m2_205_479# m2_6298_6043# m2_205_2455# m2_205_3191# m2_6298_4067# m2_6221_1215#
+ m2_205_4431# m2_6298_115# m2_205_6407# m2_205_5167# m2_6221_4431# m2_6221_3191#
+ m2_282_2091# m2_6221_5167# m2_282_115# m2_6221_2455# m2_205_7143# m2_6298_2091#
+ m2_6221_6407# VSUBS
Xnfet_06v0_8u_1u_4nf_0[0|0] m2_205_479# m2_282_115# m2_205_1215# m2_205_479# m2_205_479#
+ m2_282_115# m2_282_115# m2_205_1215# VSUBS m2_282_115# nfet_06v0_8u_1u_4nf
Xnfet_06v0_8u_1u_4nf_0[1|0] m2_205_2455# m2_282_2091# m2_205_3191# m2_205_2455# m2_205_2455#
+ m2_282_2091# m2_282_2091# m2_205_3191# VSUBS m2_282_2091# nfet_06v0_8u_1u_4nf
Xnfet_06v0_8u_1u_4nf_0[2|0] m2_205_4431# m2_282_4067# m2_205_5167# m2_205_4431# m2_205_4431#
+ m2_282_4067# m2_282_4067# m2_205_5167# VSUBS m2_282_4067# nfet_06v0_8u_1u_4nf
Xnfet_06v0_8u_1u_4nf_0[3|0] m2_205_6407# m2_282_6043# m2_205_7143# m2_205_6407# m2_205_6407#
+ m2_282_6043# m2_282_6043# m2_205_7143# VSUBS m2_282_6043# nfet_06v0_8u_1u_4nf
Xnfet_06v0_8u_1u_4nf_0[0|1] m2_205_479# m2_282_115# m2_205_1215# m2_205_479# m2_205_479#
+ m2_282_115# m2_282_115# m2_205_1215# VSUBS m2_282_115# nfet_06v0_8u_1u_4nf
Xnfet_06v0_8u_1u_4nf_0[1|1] m2_205_2455# m2_282_2091# m2_205_3191# m2_205_2455# m2_205_2455#
+ m2_282_2091# m2_282_2091# m2_205_3191# VSUBS m2_282_2091# nfet_06v0_8u_1u_4nf
Xnfet_06v0_8u_1u_4nf_0[2|1] m2_205_4431# m2_282_4067# m2_205_5167# m2_205_4431# m2_205_4431#
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
Xnfet_06v0_8u_1u_4nf_0[2|7] m2_6221_4431# m2_6298_4067# m2_6221_5167# m2_6221_4431#
+ m2_6221_4431# m2_6298_4067# m2_6298_4067# m2_6221_5167# VSUBS m2_6298_4067# nfet_06v0_8u_1u_4nf
Xnfet_06v0_8u_1u_4nf_0[3|7] m2_6221_6407# m2_6298_6043# m2_6221_7143# m2_6221_6407#
+ m2_6221_6407# m2_6298_6043# m2_6298_6043# m2_6221_7143# VSUBS m2_6298_6043# nfet_06v0_8u_1u_4nf
.ends

.subckt bg__trimres bgt__trimsw_0/m2_6298_6043# m3_12631_7391# bgt__trimsw_0/m2_6298_4067#
+ bgt__trimsw_0/m2_6298_115# bgt__trimsw_0/m2_282_115# bgt__trimsw_0/m2_282_2091#
+ bgt__runits_0/w_n40_n40# bgt__trimsw_0/m2_282_6043# bgt__trimsw_0/m2_6298_2091#
+ VSUBS bgt__trimsw_0/m2_282_4067# m3_788_8323#
Xbgt__runits_0 m3_5204_1339# m3_788_8323# m3_12631_7391# m3_6458_5291# m3_1213_5291#
+ m3_6458_5291# m3_5204_1339# m3_1213_1339# m3_1213_3315# m3_5756_3315# bgt__runits_0/w_n40_n40#
+ m3_1213_603# bgt__runits
Xbgt__trimsw_0 bgt__trimsw_0/m2_282_6043# bgt__trimsw_0/m2_282_4067# m3_1213_603#
+ m3_1213_1339# m3_12631_7391# m3_1213_603# bgt__trimsw_0/m2_6298_6043# m3_1213_1339#
+ m3_1213_3315# bgt__trimsw_0/m2_6298_4067# m3_5204_1339# m3_1213_3315# bgt__trimsw_0/m2_6298_115#
+ m3_1213_5291# m3_1213_5291# m3_5756_3315# m3_5756_3315# bgt__trimsw_0/m2_282_2091#
+ m3_6458_5291# bgt__trimsw_0/m2_282_115# m3_5204_1339# m3_788_8323# bgt__trimsw_0/m2_6298_2091#
+ m3_6458_5291# VSUBS bgt__trimsw
.ends

.subckt pnp_05p00x05p00 a_32_32# w_148_148# a_328_328#
X0 a_328_328# w_148_148# a_32_32# pnp_05p00x05p00
**devattr d=1000000,4000
.ends

.subckt bg__pnp_group m2_2088_2088# pnp_05p00x05p00_0[2|2]/a_328_328# VSUBS
Xpnp_05p00x05p00_0[0|0] VSUBS VSUBS VSUBS pnp_05p00x05p00
Xpnp_05p00x05p00_0[1|0] VSUBS VSUBS VSUBS pnp_05p00x05p00
Xpnp_05p00x05p00_0[2|0] VSUBS VSUBS VSUBS pnp_05p00x05p00
Xpnp_05p00x05p00_0[3|0] VSUBS VSUBS VSUBS pnp_05p00x05p00
Xpnp_05p00x05p00_0[4|0] VSUBS VSUBS VSUBS pnp_05p00x05p00
Xpnp_05p00x05p00_0[0|1] VSUBS VSUBS VSUBS pnp_05p00x05p00
Xpnp_05p00x05p00_0[1|1] VSUBS VSUBS m2_2088_2088# pnp_05p00x05p00
Xpnp_05p00x05p00_0[2|1] VSUBS VSUBS m2_2088_2088# pnp_05p00x05p00
Xpnp_05p00x05p00_0[3|1] VSUBS VSUBS m2_2088_2088# pnp_05p00x05p00
Xpnp_05p00x05p00_0[4|1] VSUBS VSUBS VSUBS pnp_05p00x05p00
Xpnp_05p00x05p00_0[0|2] VSUBS VSUBS VSUBS pnp_05p00x05p00
Xpnp_05p00x05p00_0[1|2] VSUBS VSUBS m2_2088_2088# pnp_05p00x05p00
Xpnp_05p00x05p00_0[2|2] VSUBS VSUBS pnp_05p00x05p00_0[2|2]/a_328_328# pnp_05p00x05p00
Xpnp_05p00x05p00_0[3|2] VSUBS VSUBS m2_2088_2088# pnp_05p00x05p00
Xpnp_05p00x05p00_0[4|2] VSUBS VSUBS VSUBS pnp_05p00x05p00
Xpnp_05p00x05p00_0[0|3] VSUBS VSUBS VSUBS pnp_05p00x05p00
Xpnp_05p00x05p00_0[1|3] VSUBS VSUBS m2_2088_2088# pnp_05p00x05p00
Xpnp_05p00x05p00_0[2|3] VSUBS VSUBS m2_2088_2088# pnp_05p00x05p00
Xpnp_05p00x05p00_0[3|3] VSUBS VSUBS m2_2088_2088# pnp_05p00x05p00
Xpnp_05p00x05p00_0[4|3] VSUBS VSUBS VSUBS pnp_05p00x05p00
Xpnp_05p00x05p00_0[0|4] VSUBS VSUBS VSUBS pnp_05p00x05p00
Xpnp_05p00x05p00_0[1|4] VSUBS VSUBS VSUBS pnp_05p00x05p00
Xpnp_05p00x05p00_0[2|4] VSUBS VSUBS VSUBS pnp_05p00x05p00
Xpnp_05p00x05p00_0[3|4] VSUBS VSUBS VSUBS pnp_05p00x05p00
Xpnp_05p00x05p00_0[4|4] VSUBS VSUBS VSUBS pnp_05p00x05p00
.ends
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
