christoph-weiser/gf180mcu_cw_ip_vref/layout/lvs/lay_gf180mcu_cw_ip_vref.spice

* SPICE3 file created from gf180mcu_cw_ip_vref.ext - technology: gf180mcuD

X0 a_58848_8833# a_58456_10901# VGND VGND nfet_06v0 ad=1.76p pd=8.88u as=1.04p ps=4.52u w=4u l=1u
X1 VAPWR a_24590_15686# a_12342_17754# VAPWR pfet_06v0 ad=3.52p pd=16.88u as=2.08p ps=8.52u w=8u l=2u
X2 VAPWR a_55856_15007# a_43894_16339# VAPWR pfet_06v0 ad=0.52p pd=2.52u as=0.88p ps=4.88u w=2u l=1u
X3 VGND a_62936_10901# a_62936_8925# VGND nfet_06v0 ad=2.08p pd=8.52u as=3.52p ps=16.88u w=8u l=1u
X4 a_58544_15007# a_58848_8833# VGND VGND nfet_06v0 ad=3.52p pd=16.88u as=2.08p ps=8.52u w=8u l=1u
X5 a_37790_10503# a_37878_10411# a_37790_12479# VGND nfet_06v0 ad=2.08p pd=8.52u as=2.08p ps=8.52u w=8u l=1u
X6 VAPWR VAPWR VAPWR VAPWR pfet_06v0 ad=2.08p pd=8.52u as=0.80096n ps=3.7068m w=8u l=4u
X7 a_12082_26215# a_37878_16339# a_37790_16431# VGND nfet_06v0 ad=2.08p pd=8.52u as=3.52p ps=16.88u w=8u l=1u
X8 a_11542_11118# a_12838_11118# VGND VGND nfet_06v0 ad=2.08p pd=8.52u as=3.52p ps=16.88u w=8u l=2u
X9 VGND VGND VGND pnp_05p00x05p00
**devattr d=1000000,4000
X10 a_58393_27544# a_58393_27544# VAPWR VAPWR pfet_06v0 ad=3.52p pd=16.88u as=2.08p ps=8.52u w=8u l=4u
X11 a_24590_19638# a_14276_35251# VGND VGND nfet_06v0 ad=3.52p pd=16.88u as=3.52p ps=16.88u w=8u l=8u
X12 a_14276_37227# a_38026_26215# VAPWR ppolyf_u_1k_6p0 r_width=1u r_length=20u
X13 VGND bias a_56297_31862# VGND nfet_06v0 ad=2.08p pd=8.52u as=3.52p ps=16.88u w=8u l=1u
X14 VAPWR VAPWR VAPWR VAPWR pfet_06v0 ad=3.52p pd=16.88u as=0 ps=0 w=8u l=4u
X15 a_41390_19348# a_43894_10411# a_37790_10503# VGND nfet_06v0 ad=2.08p pd=8.52u as=3.52p ps=16.88u w=8u l=1u
X16 bias bias VGND VGND nfet_06v0 ad=3.52p pd=16.88u as=2.08p ps=8.52u w=8u l=1u
X17 a_24590_15686# a_24590_15686# VAPWR VAPWR pfet_06v0 ad=2.08p pd=8.52u as=3.52p ps=16.88u w=8u l=2u
X18 a_11542_11118# a_12838_11118# VGND VGND nfet_06v0 ad=2.08p pd=8.52u as=3.52p ps=16.88u w=8u l=2u
X19 VDPWR trim_6_ a_61144_10901# VDPWR pfet_06v0 ad=2.08p pd=8.52u as=3.52p ps=16.88u w=8u l=1u
X20 a_22018_30337# a_23674_26215# VAPWR ppolyf_u_1k_6p0 r_width=1u r_length=20u
X21 VAPWR VAPWR VAPWR VAPWR pfet_06v0 ad=2.08p pd=8.52u as=0 ps=0 w=8u l=2u
X22 a_13230_17754# a_11630_11026# a_14134_11118# VGND nfet_06v0 ad=2.08p pd=8.52u as=3.52p ps=16.88u w=8u l=2u
X23 a_17602_30337# a_17050_26215# VAPWR ppolyf_u_1k_6p0 r_width=1u r_length=20u
X24 a_12082_26215# a_37878_16339# a_37790_16431# VGND nfet_06v0 ad=2.08p pd=8.52u as=2.08p ps=8.52u w=8u l=1u
X25 vext a_63447_19170# a_57681_34556# VGND nfet_06v0 ad=3.52p pd=16.88u as=2.08p ps=8.52u w=8u l=1u
X26 vout a_56815_19170# a_13972_35251# VAPWR pfet_06v0 ad=2.08p pd=8.52u as=2.08p ps=8.52u w=8u l=1u
X27 a_57681_34556# a_63447_19170# a_17602_30337# VAPWR pfet_06v0 ad=2.08p pd=8.52u as=2.08p ps=8.52u w=8u l=1u
X28 VGND VGND VGND VGND nfet_06v0 ad=3.52p pd=16.88u as=0.54032n ps=2.45736m w=8u l=2u
X29 a_60640_8833# a_60248_10901# VDPWR VDPWR pfet_06v0 ad=3.52p pd=16.88u as=2.08p ps=8.52u w=8u l=1u
X30 a_42494_20470# a_42494_19348# VAPWR ppolyf_u_1k_6p0 r_width=1u r_length=5u
X31 VAPWR a_62128_15007# a_37878_16339# VAPWR pfet_06v0 ad=0.52p pd=2.52u as=0.88p ps=4.88u w=2u l=1u
X32 VAPWR VAPWR VAPWR VAPWR pfet_06v0 ad=3.52p pd=16.88u as=0 ps=0 w=8u l=2u
X33 a_37790_10503# a_37878_10411# a_37790_12479# VGND nfet_06v0 ad=3.52p pd=16.88u as=2.08p ps=8.52u w=8u l=1u
X34 VAPWR a_24590_15686# a_12342_17754# VAPWR pfet_06v0 ad=3.52p pd=16.88u as=2.08p ps=8.52u w=8u l=2u
X35 VAPWR a_12030_11118# a_17602_30337# VAPWR pfet_06v0 ad=3.52p pd=16.88u as=3.52p ps=16.88u w=8u l=8u
X36 a_41390_19348# a_43894_12387# a_42494_20470# VGND nfet_06v0 ad=2.08p pd=8.52u as=2.08p ps=8.52u w=8u l=1u
X37 VGND a_12838_11118# a_11542_11118# VGND nfet_06v0 ad=3.52p pd=16.88u as=2.08p ps=8.52u w=8u l=2u
X38 VGND VGND a_24778_26215# pnp_05p00x05p00
**devattr d=1000000,4000
X39 VAPWR VAPWR VAPWR VAPWR pfet_06v0 ad=2.08p pd=8.52u as=0 ps=0 w=8u l=4u
X40 VAPWR a_58544_15007# a_43894_10411# VAPWR pfet_06v0 ad=0.52p pd=2.52u as=0.88p ps=4.88u w=2u l=1u
X41 a_41390_19348# a_43894_10411# a_37790_10503# VGND nfet_06v0 ad=2.08p pd=8.52u as=2.08p ps=8.52u w=8u l=1u
X42 a_37790_14455# a_37878_14363# a_37790_16431# VGND nfet_06v0 ad=3.52p pd=16.88u as=2.08p ps=8.52u w=8u l=1u
X43 a_61232_15007# a_37878_14363# VAPWR VAPWR pfet_06v0 ad=0.88p pd=4.88u as=0.52p ps=2.52u w=2u l=1u
X44 a_57681_34556# a_63447_19170# vext VGND nfet_06v0 ad=2.08p pd=8.52u as=3.52p ps=16.88u w=8u l=1u
X45 vout a_56223_19170# a_56297_31862# VAPWR pfet_06v0 ad=2.08p pd=8.52u as=3.52p ps=16.88u w=8u l=1u
X46 VAPWR VAPWR VAPWR VAPWR pfet_06v0 ad=2.08p pd=8.52u as=0 ps=0 w=8u l=4u
X47 a_57681_34556# a_62855_19170# vext VAPWR pfet_06v0 ad=2.08p pd=8.52u as=2.08p ps=8.52u w=8u l=1u
X48 VGND VGND VGND VGND nfet_06v0 ad=2.08p pd=8.52u as=0 ps=0 w=8u l=2u
X49 VAPWR VAPWR VAPWR VAPWR pfet_06v0 ad=3.52p pd=16.88u as=0 ps=0 w=8u l=8u
X50 a_57648_15007# a_43894_12387# VAPWR VAPWR pfet_06v0 ad=0.88p pd=4.88u as=0.52p ps=2.52u w=2u l=1u
X51 VGND VGND VGND VGND nfet_06v0 ad=3.52p pd=16.88u as=0 ps=0 w=8u l=8u
X52 a_24778_30337# a_12430_17662# VAPWR ppolyf_u_1k_6p0 r_width=1u r_length=20u
X53 a_12082_26215# a_37878_16339# a_37790_16431# VGND nfet_06v0 ad=2.08p pd=8.52u as=2.08p ps=8.52u w=8u l=1u
X54 VGND a_12838_11118# a_13230_17754# VGND nfet_06v0 ad=3.52p pd=16.88u as=2.08p ps=8.52u w=8u l=2u
X55 a_13230_17754# a_12430_17662# a_12342_17754# VAPWR pfet_06v0 ad=2.08p pd=8.52u as=3.52p ps=16.88u w=8u l=4u
X56 a_13230_17754# a_12838_11118# VGND VGND nfet_06v0 ad=2.08p pd=8.52u as=3.52p ps=16.88u w=8u l=2u
X57 a_17602_30337# a_62855_19170# a_57681_34556# VGND nfet_06v0 ad=3.52p pd=16.88u as=2.08p ps=8.52u w=8u l=1u
X58 VAPWR VAPWR VAPWR VAPWR pfet_06v0 ad=3.52p pd=16.88u as=0 ps=0 w=8u l=8u
X59 a_12342_17754# a_12430_17662# a_13230_17754# VAPWR pfet_06v0 ad=3.52p pd=16.88u as=2.08p ps=8.52u w=8u l=4u
X60 VAPWR VAPWR VAPWR VAPWR pfet_06v0 ad=2.08p pd=8.52u as=0 ps=0 w=8u l=2u
X61 a_37790_16431# a_37878_14363# a_37790_14455# VGND nfet_06v0 ad=2.08p pd=8.52u as=3.52p ps=16.88u w=8u l=1u
X62 a_24502_19730# a_24590_19638# a_14134_11118# VAPWR pfet_06v0 ad=3.52p pd=16.88u as=2.08p ps=8.52u w=8u l=2u
X63 a_12342_17754# a_24590_15686# VAPWR VAPWR pfet_06v0 ad=2.08p pd=8.52u as=3.52p ps=16.88u w=8u l=2u
X64 a_58848_8833# a_58456_10901# VDPWR VDPWR pfet_06v0 ad=3.52p pd=16.88u as=2.08p ps=8.52u w=8u l=1u
X65 a_62583_32316# a_64605_32796# VAPWR ppolyf_u_1k_6p0 r_width=2u r_length=9.5u
X66 a_11630_11026# a_11630_11026# a_12838_11118# VGND nfet_06v0 ad=2.08p pd=8.52u as=3.52p ps=16.88u w=8u l=2u
X67 VGND a_42494_19348# VAPWR ppolyf_u_1k_6p0 r_width=1u r_length=5u
X68 VAPWR a_24590_15686# a_11630_11026# VAPWR pfet_06v0 ad=3.52p pd=16.88u as=2.08p ps=8.52u w=8u l=2u
X69 a_37790_14455# a_37878_14363# a_37790_16431# VGND nfet_06v0 ad=3.52p pd=16.88u as=2.08p ps=8.52u w=8u l=1u
X70 VAPWR VAPWR VAPWR VAPWR pfet_06v0 ad=3.52p pd=16.88u as=0 ps=0 w=8u l=8u
X71 a_12030_11118# a_24590_19638# a_25798_19730# VAPWR pfet_06v0 ad=2.08p pd=8.52u as=3.52p ps=16.88u w=8u l=2u
X72 a_12030_11118# a_11630_11026# a_11542_11118# VGND nfet_06v0 ad=2.08p pd=8.52u as=3.52p ps=16.88u w=8u l=2u
X73 VGND VGND VGND VGND nfet_06v0 ad=3.52p pd=16.88u as=0 ps=0 w=8u l=8u
X74 a_38630_20470# a_38078_19348# VAPWR ppolyf_u_1k_6p0 r_width=1u r_length=5u
X75 a_57648_15007# a_57952_8833# VGND VGND nfet_06v0 ad=3.52p pd=16.88u as=2.08p ps=8.52u w=8u l=1u
X76 a_60233_31862# a_58985_37184# a_58985_37184# VAPWR pfet_06v0 ad=2.08p pd=8.52u as=3.52p ps=16.88u w=8u l=1u
X77 VGND a_12838_11118# a_12838_11118# VGND nfet_06v0 ad=3.52p pd=16.88u as=2.08p ps=8.52u w=8u l=2u
X78 VAPWR VAPWR VAPWR VAPWR pfet_06v0 ad=3.52p pd=16.88u as=0 ps=0 w=8u l=2u
X79 a_37790_12479# a_37878_12387# a_37790_14455# VGND nfet_06v0 ad=2.08p pd=8.52u as=2.08p ps=8.52u w=8u l=1u
X80 VGND a_12838_11118# a_11542_11118# VGND nfet_06v0 ad=3.52p pd=16.88u as=2.08p ps=8.52u w=8u l=2u
X81 a_56297_31862# bias VGND VGND nfet_06v0 ad=3.52p pd=16.88u as=2.08p ps=8.52u w=8u l=1u
X82 vext a_62855_19170# a_57681_34556# VAPWR pfet_06v0 ad=3.52p pd=16.88u as=2.08p ps=8.52u w=8u l=1u
X83 VAPWR a_24590_15686# a_24590_15686# VAPWR pfet_06v0 ad=3.52p pd=16.88u as=2.08p ps=8.52u w=8u l=2u
X84 a_63920_15007# a_56311_19078# VAPWR VAPWR pfet_06v0 ad=0.88p pd=4.88u as=0.52p ps=2.52u w=2u l=1u
X85 a_57056_8833# a_56664_10901# VGND VGND nfet_06v0 ad=1.76p pd=8.88u as=1.04p ps=4.52u w=4u l=1u
X86 VGND dsw_1_ a_63832_10901# VGND nfet_06v0 ad=1.04p pd=4.52u as=1.76p ps=8.88u w=4u l=1u
X87 a_60233_31862# a_60233_31862# VAPWR VAPWR pfet_06v0 ad=3.52p pd=16.88u as=2.08p ps=8.52u w=8u l=1u
X88 a_56297_31862# a_56223_19170# vout VAPWR pfet_06v0 ad=3.52p pd=16.88u as=2.08p ps=8.52u w=8u l=1u
X89 a_37790_16431# a_37878_14363# a_37790_14455# VGND nfet_06v0 ad=2.08p pd=8.52u as=3.52p ps=16.88u w=8u l=1u
X90 VGND VGND VGND VGND nfet_06v0 ad=2.08p pd=8.52u as=0 ps=0 w=8u l=2u
X91 VAPWR VAPWR VAPWR VAPWR pfet_06v0 ad=2.08p pd=8.52u as=0 ps=0 w=8u l=4u
X92 a_56297_31862# a_56385_31770# VAPWR VAPWR pfet_06v0 ad=2.08p pd=8.52u as=2.08p ps=8.52u w=8u l=1u
X93 a_42494_20470# a_42494_19348# VAPWR ppolyf_u_1k_6p0 r_width=1u r_length=5u
X94 a_42494_19348# a_43894_14363# a_42494_20470# VGND nfet_06v0 ad=2.08p pd=8.52u as=3.52p ps=16.88u w=8u l=1u
X95 a_24226_30337# a_26434_26215# VAPWR ppolyf_u_1k_6p0 r_width=1u r_length=20u
X96 VAPWR VAPWR VAPWR VAPWR pfet_06v0 ad=3.52p pd=16.88u as=0 ps=0 w=8u l=4u
X97 VGND bias a_58081_34648# VGND nfet_06v0 ad=2.08p pd=8.52u as=3.52p ps=16.88u w=8u l=1u
X98 VAPWR VAPWR VAPWR VAPWR pfet_06v0 ad=3.52p pd=16.88u as=0 ps=0 w=8u l=8u
X99 VGND a_12838_11118# a_11542_11118# VGND nfet_06v0 ad=3.52p pd=16.88u as=2.08p ps=8.52u w=8u l=2u
X100 vout a_56223_19170# a_13972_35251# VGND nfet_06v0 ad=2.08p pd=8.52u as=2.08p ps=8.52u w=8u l=1u
X101 a_58393_27544# a_56297_31862# a_58081_34648# VGND nfet_06v0 ad=3.52p pd=16.88u as=2.08p ps=8.52u w=8u l=2u
X102 a_11542_11118# a_12838_11118# VGND VGND nfet_06v0 ad=2.08p pd=8.52u as=3.52p ps=16.88u w=8u l=2u
X103 VAPWR a_24590_15686# a_12342_17754# VAPWR pfet_06v0 ad=3.52p pd=16.88u as=2.08p ps=8.52u w=8u l=2u
X104 VAPWR a_62936_8925# a_62855_19170# VAPWR pfet_06v0 ad=2.08p pd=8.52u as=3.52p ps=16.88u w=8u l=1u
X105 a_41390_19348# a_43894_10411# a_37790_10503# VGND nfet_06v0 ad=2.08p pd=8.52u as=2.08p ps=8.52u w=8u l=1u
X106 VAPWR VAPWR VAPWR ppolyf_u_1k_6p0 r_width=1u r_length=20u
X107 a_42494_19348# VGND VAPWR ppolyf_u_1k_6p0 r_width=1u r_length=5u
X108 a_42494_19348# a_43894_16339# VGND VGND nfet_06v0 ad=2.08p pd=8.52u as=2.08p ps=8.52u w=8u l=1u
X109 a_25798_19730# a_24590_19638# a_12030_11118# VAPWR pfet_06v0 ad=3.52p pd=16.88u as=2.08p ps=8.52u w=8u l=2u
X110 a_38630_22066# a_38630_20470# VAPWR ppolyf_u_1k_6p0 r_width=1u r_length=5u
X111 VGND VGND a_24778_26215# pnp_05p00x05p00
**devattr d=1000000,4000
X112 a_12342_17754# a_14276_37227# a_11542_11118# VAPWR pfet_06v0 ad=3.52p pd=16.88u as=2.08p ps=8.52u w=8u l=4u
X113 a_37790_12479# a_37878_12387# a_37790_14455# VGND nfet_06v0 ad=2.08p pd=8.52u as=2.08p ps=8.52u w=8u l=1u
X114 a_14276_37227# a_12030_11118# VAPWR VAPWR pfet_06v0 ad=3.52p pd=16.88u as=3.52p ps=16.88u w=8u l=8u
X115 VGND a_14276_37227# a_37658_36785# VGND nfet_06v0 ad=0.44p pd=2.88u as=0.44p ps=2.88u w=1u l=1u
X116 a_58081_34648# a_56297_31862# a_58393_27544# VGND nfet_06v0 ad=2.08p pd=8.52u as=3.52p ps=16.88u w=8u l=2u
X117 VAPWR VAPWR VAPWR VAPWR pfet_06v0 ad=3.52p pd=16.88u as=0 ps=0 w=8u l=4u
X118 VGND a_43894_16339# a_42494_19348# VGND nfet_06v0 ad=2.08p pd=8.52u as=3.52p ps=16.88u w=8u l=1u
X119 VAPWR VAPWR VAPWR VAPWR pfet_06v0 ad=2.08p pd=8.52u as=0 ps=0 w=8u l=4u
X120 a_58985_37184# bias VGND VGND nfet_06v0 ad=3.52p pd=16.88u as=2.08p ps=8.52u w=8u l=1u
X121 a_42494_20470# a_43894_12387# a_41390_19348# VGND nfet_06v0 ad=2.08p pd=8.52u as=3.52p ps=16.88u w=8u l=1u
X122 VAPWR VAPWR VAPWR VAPWR pfet_06v0 ad=3.52p pd=16.88u as=0 ps=0 w=8u l=8u
X123 a_12030_11118# a_24590_19638# a_25798_19730# VAPWR pfet_06v0 ad=2.08p pd=8.52u as=3.52p ps=16.88u w=8u l=2u
X124 a_56297_31862# a_62583_31836# cap_mim_2f0_m4m5_noshield c_width=30u c_length=30u
X125 VGND a_12838_11118# a_11542_11118# VGND nfet_06v0 ad=3.52p pd=16.88u as=2.08p ps=8.52u w=8u l=2u
X126 a_42494_19348# a_43894_14363# a_42494_20470# VGND nfet_06v0 ad=2.08p pd=8.52u as=2.08p ps=8.52u w=8u l=1u
X127 a_42494_19348# a_43894_16339# VGND VGND nfet_06v0 ad=3.52p pd=16.88u as=2.08p ps=8.52u w=8u l=1u
X128 VGND a_42494_19348# VAPWR ppolyf_u_1k_6p0 r_width=1u r_length=5u
X129 a_25330_30337# a_25882_26215# VAPWR ppolyf_u_1k_6p0 r_width=1u r_length=20u
X130 VAPWR a_12030_11118# a_14276_37227# VAPWR pfet_06v0 ad=3.52p pd=16.88u as=3.52p ps=16.88u w=8u l=8u
X131 a_42494_20470# a_43894_14363# a_42494_19348# VGND nfet_06v0 ad=2.08p pd=8.52u as=2.08p ps=8.52u w=8u l=1u
X132 a_61232_15007# a_61536_8833# VGND VGND nfet_06v0 ad=3.52p pd=16.88u as=2.08p ps=8.52u w=8u l=1u
X133 VGND a_14276_35251# a_14276_35251# VGND nfet_06v0 ad=3.52p pd=16.88u as=3.52p ps=16.88u w=8u l=8u
X134 a_19810_30337# VGND VAPWR ppolyf_u_1k_6p0 r_width=1u r_length=20u
X135 a_54960_15007# a_55264_8833# VGND VGND nfet_06v0 ad=3.52p pd=16.88u as=2.08p ps=8.52u w=8u l=1u
X136 VGND bias a_56297_31862# VGND nfet_06v0 ad=2.08p pd=8.52u as=3.52p ps=16.88u w=8u l=1u
X137 VGND a_12838_11118# a_13230_17754# VGND nfet_06v0 ad=3.52p pd=16.88u as=2.08p ps=8.52u w=8u l=2u
X138 a_14134_11118# a_11630_11026# a_13230_17754# VGND nfet_06v0 ad=3.52p pd=16.88u as=2.08p ps=8.52u w=8u l=2u
X139 a_13230_17754# a_12838_11118# VGND VGND nfet_06v0 ad=2.08p pd=8.52u as=3.52p ps=16.88u w=8u l=2u
X140 VGND a_42494_19348# VAPWR ppolyf_u_1k_6p0 r_width=1u r_length=5u
X141 a_42494_19348# VGND VAPWR ppolyf_u_1k_6p0 r_width=1u r_length=5u
X142 a_55856_15007# a_43894_16339# VAPWR VAPWR pfet_06v0 ad=0.88p pd=4.88u as=0.52p ps=2.52u w=2u l=1u
X143 a_37790_12479# a_37878_12387# a_37790_14455# VGND nfet_06v0 ad=3.52p pd=16.88u as=2.08p ps=8.52u w=8u l=1u
X144 a_27538_30337# a_28090_26215# VAPWR ppolyf_u_1k_6p0 r_width=1u r_length=20u
X145 a_11630_11026# a_24590_15686# VAPWR VAPWR pfet_06v0 ad=2.08p pd=8.52u as=3.52p ps=16.88u w=8u l=2u
X146 a_37790_16431# a_37878_16339# a_12082_26215# VGND nfet_06v0 ad=2.08p pd=8.52u as=2.08p ps=8.52u w=8u l=1u
X147 VAPWR VAPWR VAPWR VAPWR pfet_06v0 ad=3.52p pd=16.88u as=0 ps=0 w=8u l=4u
X148 a_56297_31862# bias VGND VGND nfet_06v0 ad=3.52p pd=16.88u as=2.08p ps=8.52u w=8u l=1u
X149 a_42494_20470# a_43894_12387# a_41390_19348# VGND nfet_06v0 ad=2.08p pd=8.52u as=2.08p ps=8.52u w=8u l=1u
X150 VGND VGND a_24778_26215# pnp_05p00x05p00
**devattr d=1000000,4000
X151 vout a_56223_19170# a_56297_31862# VAPWR pfet_06v0 ad=2.08p pd=8.52u as=2.08p ps=8.52u w=8u l=1u
X152 a_13230_17754# a_11630_11026# a_14134_11118# VGND nfet_06v0 ad=2.08p pd=8.52u as=3.52p ps=16.88u w=8u l=2u
X153 a_59440_15007# a_59744_8833# VGND VGND nfet_06v0 ad=3.52p pd=16.88u as=2.08p ps=8.52u w=8u l=1u
X154 a_42494_20470# a_43894_14363# a_42494_19348# VGND nfet_06v0 ad=3.52p pd=16.88u as=2.08p ps=8.52u w=8u l=1u
X155 VAPWR a_56385_31770# a_56297_31862# VAPWR pfet_06v0 ad=2.08p pd=8.52u as=2.08p ps=8.52u w=8u l=1u
X156 VGND VGND VGND VGND nfet_06v0 ad=3.52p pd=16.88u as=0 ps=0 w=8u l=8u
X157 a_25798_19730# a_24590_19638# a_12030_11118# VAPWR pfet_06v0 ad=3.52p pd=16.88u as=2.08p ps=8.52u w=8u l=2u
X158 VAPWR a_24590_15686# a_24590_15686# VAPWR pfet_06v0 ad=3.52p pd=16.88u as=2.08p ps=8.52u w=8u l=2u
X159 VGND VGND VGND VGND nfet_06v0 ad=3.52p pd=16.88u as=0 ps=0 w=8u l=2u
X160 a_57056_8833# a_56664_10901# VDPWR VDPWR pfet_06v0 ad=3.52p pd=16.88u as=2.08p ps=8.52u w=8u l=1u
X161 VDPWR dsw_1_ a_63832_10901# VDPWR pfet_06v0 ad=2.08p pd=8.52u as=3.52p ps=16.88u w=8u l=1u
X162 VAPWR VAPWR VAPWR VAPWR pfet_06v0 ad=3.52p pd=16.88u as=0 ps=0 w=8u l=4u
X163 a_34714_30337# a_35266_26215# VAPWR ppolyf_u_1k_6p0 r_width=1u r_length=20u
X164 VAPWR VAPWR VAPWR VAPWR pfet_06v0 ad=2.08p pd=8.52u as=0 ps=0 w=8u l=4u
X165 a_13230_17754# a_12430_17662# a_12342_17754# VAPWR pfet_06v0 ad=2.08p pd=8.52u as=3.52p ps=16.88u w=8u l=4u
X166 VGND bias a_56297_31862# VGND nfet_06v0 ad=2.08p pd=8.52u as=3.52p ps=16.88u w=8u l=1u
X167 a_56385_31770# a_64605_32796# VAPWR ppolyf_u_1k_6p0 r_width=2u r_length=9.5u
X168 VGND trim_2_ a_57560_10901# VGND nfet_06v0 ad=1.04p pd=4.52u as=1.76p ps=8.88u w=4u l=1u
X169 VAPWR VAPWR VAPWR VAPWR pfet_06v0 ad=3.52p pd=16.88u as=0 ps=0 w=8u l=2u
X170 VAPWR a_58393_27544# a_56385_31770# VAPWR pfet_06v0 ad=2.08p pd=8.52u as=3.52p ps=16.88u w=8u l=4u
X171 a_20362_30337# a_19258_26215# VAPWR ppolyf_u_1k_6p0 r_width=1u r_length=20u
X172 a_37790_12479# a_37878_10411# a_37790_10503# VGND nfet_06v0 ad=2.08p pd=8.52u as=2.08p ps=8.52u w=8u l=1u
X173 VAPWR VAPWR VAPWR VAPWR pfet_06v0 ad=2.08p pd=8.52u as=0 ps=0 w=8u l=2u
X174 VGND a_42494_19348# VAPWR ppolyf_u_1k_6p0 r_width=1u r_length=5u
X175 a_11542_11118# a_11630_11026# a_12030_11118# VGND nfet_06v0 ad=3.52p pd=16.88u as=2.08p ps=8.52u w=8u l=2u
X176 a_37790_10503# a_43894_10411# a_41390_19348# VGND nfet_06v0 ad=2.08p pd=8.52u as=2.08p ps=8.52u w=8u l=1u
X177 a_13230_17754# a_12838_11118# VGND VGND nfet_06v0 ad=2.08p pd=8.52u as=3.52p ps=16.88u w=8u l=2u
X178 a_12838_11118# a_11630_11026# a_11630_11026# VGND nfet_06v0 ad=3.52p pd=16.88u as=2.08p ps=8.52u w=8u l=2u
X179 vout a_56815_19170# a_13972_35251# VAPWR pfet_06v0 ad=2.08p pd=8.52u as=3.52p ps=16.88u w=8u l=1u
X180 VAPWR VAPWR VAPWR VAPWR pfet_06v0 ad=3.52p pd=16.88u as=0 ps=0 w=8u l=2u
X181 VGND VGND VGND VGND nfet_06v0 ad=3.52p pd=16.88u as=0 ps=0 w=8u l=8u
X182 a_24502_19730# a_24590_19638# a_14134_11118# VAPWR pfet_06v0 ad=3.52p pd=16.88u as=2.08p ps=8.52u w=8u l=2u
X183 a_37568_32797# a_37064_32705# a_37658_36785# VGND nfet_06v0 ad=0.44p pd=2.88u as=0.44p ps=2.88u w=1u l=1u
X184 a_42494_20470# a_43894_14363# a_42494_19348# VGND nfet_06v0 ad=2.08p pd=8.52u as=2.08p ps=8.52u w=8u l=1u
X185 a_37790_16431# a_37878_16339# a_12082_26215# VGND nfet_06v0 ad=3.52p pd=16.88u as=2.08p ps=8.52u w=8u l=1u
X186 VGND VGND a_24778_26215# pnp_05p00x05p00
**devattr d=1000000,4000
X187 a_56815_19170# a_56223_19170# VAPWR VAPWR pfet_06v0 ad=3.52p pd=16.88u as=2.08p ps=8.52u w=8u l=1u
X188 VAPWR VAPWR VAPWR VAPWR pfet_06v0 ad=3.52p pd=16.88u as=0 ps=0 w=8u l=8u
X189 a_11630_11026# a_11630_11026# a_12838_11118# VGND nfet_06v0 ad=2.08p pd=8.52u as=3.52p ps=16.88u w=8u l=2u
X190 VGND bias bias VGND nfet_06v0 ad=2.08p pd=8.52u as=3.52p ps=16.88u w=8u l=1u
X191 a_26986_30337# a_28642_26215# VAPWR ppolyf_u_1k_6p0 r_width=1u r_length=20u
X192 a_60336_15007# a_60640_8833# VGND VGND nfet_06v0 ad=3.52p pd=16.88u as=2.08p ps=8.52u w=8u l=1u
X193 VAPWR VAPWR VAPWR VAPWR pfet_06v0 ad=2.08p pd=8.52u as=0 ps=0 w=8u l=4u
X194 a_14276_37227# a_12030_11118# VAPWR VAPWR pfet_06v0 ad=3.52p pd=16.88u as=3.52p ps=16.88u w=8u l=8u
X195 a_56752_15007# a_57056_8833# VGND VGND nfet_06v0 ad=3.52p pd=16.88u as=2.08p ps=8.52u w=8u l=1u
X196 a_63024_15007# a_63328_8833# VGND VGND nfet_06v0 ad=3.52p pd=16.88u as=2.08p ps=8.52u w=8u l=1u
X197 a_42494_20470# a_43894_12387# a_41390_19348# VGND nfet_06v0 ad=2.08p pd=8.52u as=2.08p ps=8.52u w=8u l=1u
X198 a_16498_30337# a_15946_26215# VAPWR ppolyf_u_1k_6p0 r_width=1u r_length=20u
X199 a_12342_17754# a_12430_17662# a_13230_17754# VAPWR pfet_06v0 ad=3.52p pd=16.88u as=2.08p ps=8.52u w=8u l=4u
X200 VAPWR VAPWR VAPWR VAPWR pfet_06v0 ad=2.08p pd=8.52u as=0 ps=0 w=8u l=2u
X201 a_12082_26215# a_37878_16339# a_37790_16431# VGND nfet_06v0 ad=2.08p pd=8.52u as=3.52p ps=16.88u w=8u l=1u
X202 a_63328_8833# a_62936_10901# VGND VGND nfet_06v0 ad=1.76p pd=8.88u as=1.04p ps=4.52u w=4u l=1u
X203 VAPWR a_37064_32705# a_12030_11118# VAPWR pfet_06v0 ad=0.88p pd=4.88u as=0.88p ps=4.88u w=2u l=1u
X204 VAPWR VAPWR VAPWR VAPWR pfet_06v0 ad=2.08p pd=8.52u as=0 ps=0 w=8u l=4u
X205 VAPWR a_14134_11118# a_24502_19730# VAPWR pfet_06v0 ad=2.08p pd=8.52u as=3.52p ps=16.88u w=8u l=2u
X206 VAPWR a_60336_15007# a_37878_12387# VAPWR pfet_06v0 ad=0.52p pd=2.52u as=0.88p ps=4.88u w=2u l=1u
X207 a_13972_35251# a_56815_19170# vout VAPWR pfet_06v0 ad=2.08p pd=8.52u as=2.08p ps=8.52u w=8u l=1u
X208 VGND VGND VGND VGND nfet_06v0 ad=2.08p pd=8.52u as=0 ps=0 w=8u l=2u
X209 a_17602_30337# a_62855_19170# a_57681_34556# VGND nfet_06v0 ad=2.08p pd=8.52u as=2.08p ps=8.52u w=8u l=1u
X210 VAPWR VAPWR VAPWR VAPWR pfet_06v0 ad=3.52p pd=16.88u as=0 ps=0 w=8u l=8u
X211 a_59744_8833# a_59352_10901# VGND VGND nfet_06v0 ad=1.76p pd=8.88u as=1.04p ps=4.52u w=4u l=1u
X212 a_34162_30337# a_35818_26215# VAPWR ppolyf_u_1k_6p0 r_width=1u r_length=20u
X213 a_37790_10503# a_41390_19348# VAPWR ppolyf_u_1k_6p0 r_width=1u r_length=5u
X214 VAPWR a_56752_15007# a_43894_14363# VAPWR pfet_06v0 ad=0.52p pd=2.52u as=0.88p ps=4.88u w=2u l=1u
X215 VAPWR VAPWR VAPWR VAPWR pfet_06v0 ad=3.52p pd=16.88u as=0 ps=0 w=8u l=4u
X216 a_38078_20470# a_38078_19348# VAPWR ppolyf_u_1k_6p0 r_width=1u r_length=5u
X217 a_37790_16431# a_37878_16339# a_12082_26215# VGND nfet_06v0 ad=3.52p pd=16.88u as=2.08p ps=8.52u w=8u l=1u
X218 VAPWR a_12030_11118# a_14276_35251# VAPWR pfet_06v0 ad=3.52p pd=16.88u as=3.52p ps=16.88u w=8u l=8u
X219 VAPWR a_24590_15686# a_11630_11026# VAPWR pfet_06v0 ad=3.52p pd=16.88u as=2.08p ps=8.52u w=8u l=2u
X220 VGND VGND VGND VGND nfet_06v0 ad=2.08p pd=8.52u as=0 ps=0 w=8u l=2u
X221 VGND a_14276_35251# a_14276_35251# VGND nfet_06v0 ad=3.52p pd=16.88u as=3.52p ps=16.88u w=8u l=8u
X222 a_37790_14455# a_37878_14363# a_37790_16431# VGND nfet_06v0 ad=2.08p pd=8.52u as=2.08p ps=8.52u w=8u l=1u
X223 VGND VGND VGND VGND nfet_06v0 ad=3.52p pd=16.88u as=0 ps=0 w=8u l=2u
X224 a_20362_30337# a_20914_26215# VAPWR ppolyf_u_1k_6p0 r_width=1u r_length=20u
X225 VAPWR VAPWR VAPWR VAPWR pfet_06v0 ad=2.08p pd=8.52u as=0 ps=0 w=8u l=4u
X226 a_56297_31862# bias VGND VGND nfet_06v0 ad=3.52p pd=16.88u as=2.08p ps=8.52u w=8u l=1u
X227 a_36370_30337# a_38026_26215# VAPWR ppolyf_u_1k_6p0 r_width=1u r_length=20u
X228 a_24590_15686# a_24590_19638# a_24590_19638# VAPWR pfet_06v0 ad=3.52p pd=16.88u as=2.08p ps=8.52u w=8u l=2u
X229 VAPWR a_24590_15686# a_12342_17754# VAPWR pfet_06v0 ad=3.52p pd=16.88u as=2.08p ps=8.52u w=8u l=2u
X230 VGND VGND VGND pnp_05p00x05p00
**devattr d=1000000,4000
X231 VDPWR trim_2_ a_57560_10901# VDPWR pfet_06v0 ad=2.08p pd=8.52u as=3.52p ps=16.88u w=8u l=1u
X232 VAPWR VAPWR VAPWR VAPWR pfet_06v0 ad=3.52p pd=16.88u as=0 ps=0 w=8u l=8u
X233 vext a_62855_19170# a_57681_34556# VAPWR pfet_06v0 ad=2.08p pd=8.52u as=2.08p ps=8.52u w=8u l=1u
X234 a_37790_10503# a_37878_10411# a_37790_12479# VGND nfet_06v0 ad=2.08p pd=8.52u as=2.08p ps=8.52u w=8u l=1u
X235 a_12082_26215# a_37878_16339# a_37790_16431# VGND nfet_06v0 ad=2.08p pd=8.52u as=3.52p ps=16.88u w=8u l=1u
X236 a_22570_30337# a_23122_26215# VAPWR ppolyf_u_1k_6p0 r_width=1u r_length=20u
X237 a_42494_19348# VGND VAPWR ppolyf_u_1k_6p0 r_width=1u r_length=5u
X238 VGND a_43894_16339# a_42494_19348# VGND nfet_06v0 ad=2.08p pd=8.52u as=3.52p ps=16.88u w=8u l=1u
X239 a_14276_35251# a_14276_35251# VGND VGND nfet_06v0 ad=3.52p pd=16.88u as=3.52p ps=16.88u w=8u l=8u
X240 VGND a_12838_11118# a_12838_11118# VGND nfet_06v0 ad=3.52p pd=16.88u as=2.08p ps=8.52u w=8u l=2u
X241 a_37790_12479# a_37790_10503# VAPWR ppolyf_u_1k_6p0 r_width=1u r_length=5u
X242 VAPWR a_63024_15007# a_62936_8925# VAPWR pfet_06v0 ad=0.52p pd=2.52u as=0.88p ps=4.88u w=2u l=1u
X243 VAPWR a_12030_11118# a_13972_35251# VAPWR pfet_06v0 ad=3.52p pd=16.88u as=3.52p ps=16.88u w=8u l=8u
X244 VAPWR a_24590_15686# a_12342_17754# VAPWR pfet_06v0 ad=3.52p pd=16.88u as=2.08p ps=8.52u w=8u l=2u
X245 a_37526_22066# a_38078_20470# VAPWR ppolyf_u_1k_6p0 r_width=1u r_length=5u
X246 a_12342_17754# a_14276_37227# a_11542_11118# VAPWR pfet_06v0 ad=3.52p pd=16.88u as=2.08p ps=8.52u w=8u l=4u
X247 VAPWR a_59440_15007# a_37878_10411# VAPWR pfet_06v0 ad=0.52p pd=2.52u as=0.88p ps=4.88u w=2u l=1u
X248 VAPWR VAPWR VAPWR VAPWR pfet_06v0 ad=3.52p pd=16.88u as=0 ps=0 w=8u l=8u
X249 a_12838_11118# a_11630_11026# a_11630_11026# VGND nfet_06v0 ad=3.52p pd=16.88u as=2.08p ps=8.52u w=8u l=2u
X250 a_37790_14455# a_37878_14363# a_37790_16431# VGND nfet_06v0 ad=2.08p pd=8.52u as=2.08p ps=8.52u w=8u l=1u
X251 VGND a_12838_11118# a_13230_17754# VGND nfet_06v0 ad=3.52p pd=16.88u as=2.08p ps=8.52u w=8u l=2u
X252 a_62128_15007# a_37878_16339# VAPWR VAPWR pfet_06v0 ad=0.88p pd=4.88u as=0.52p ps=2.52u w=2u l=1u
X253 VAPWR VAPWR VAPWR VAPWR pfet_06v0 ad=2.08p pd=8.52u as=0 ps=0 w=8u l=4u
X254 a_11542_11118# a_11630_11026# a_12030_11118# VGND nfet_06v0 ad=3.52p pd=16.88u as=2.08p ps=8.52u w=8u l=2u
X255 a_55264_8833# a_54872_10901# VGND VGND nfet_06v0 ad=1.76p pd=8.88u as=1.04p ps=4.52u w=4u l=1u
X256 VGND VGND VGND VGND nfet_06v0 ad=3.52p pd=16.88u as=0 ps=0 w=8u l=8u
X257 a_36922_30337# a_12430_17662# VAPWR ppolyf_u_1k_6p0 r_width=1u r_length=20u
X258 VAPWR VAPWR VAPWR VAPWR pfet_06v0 ad=3.52p pd=16.88u as=0 ps=0 w=8u l=4u
X259 VAPWR VAPWR VAPWR VAPWR pfet_06v0 ad=2.08p pd=8.52u as=0 ps=0 w=8u l=4u
X260 a_58081_34648# bias VGND VGND nfet_06v0 ad=3.52p pd=16.88u as=2.08p ps=8.52u w=8u l=1u
X261 a_42494_19348# a_43894_14363# a_42494_20470# VGND nfet_06v0 ad=2.08p pd=8.52u as=3.52p ps=16.88u w=8u l=1u
X262 VAPWR VAPWR VAPWR VAPWR pfet_06v0 ad=3.52p pd=16.88u as=0 ps=0 w=8u l=4u
X263 a_37790_10503# a_43894_10411# a_41390_19348# VGND nfet_06v0 ad=3.52p pd=16.88u as=2.08p ps=8.52u w=8u l=1u
X264 a_56385_31770# a_57681_34556# a_58081_34648# VGND nfet_06v0 ad=3.52p pd=16.88u as=2.08p ps=8.52u w=8u l=2u
X265 a_12430_17662# a_12030_11118# VAPWR VAPWR pfet_06v0 ad=3.52p pd=16.88u as=3.52p ps=16.88u w=8u l=8u
X266 VGND a_43894_16339# a_42494_19348# VGND nfet_06v0 ad=2.08p pd=8.52u as=2.08p ps=8.52u w=8u l=1u
X267 a_37790_10503# a_41390_19348# VAPWR ppolyf_u_1k_6p0 r_width=1u r_length=5u
X268 vext a_63447_19170# a_57681_34556# VGND nfet_06v0 ad=2.08p pd=8.52u as=2.08p ps=8.52u w=8u l=1u
X269 a_55856_15007# a_56160_8833# VGND VGND nfet_06v0 ad=3.52p pd=16.88u as=2.08p ps=8.52u w=8u l=1u
X270 a_62128_15007# a_62432_8833# VGND VGND nfet_06v0 ad=3.52p pd=16.88u as=2.08p ps=8.52u w=8u l=1u
X271 a_22570_30337# a_20914_26215# VAPWR ppolyf_u_1k_6p0 r_width=1u r_length=20u
X272 a_63328_8833# a_62936_10901# VDPWR VDPWR pfet_06v0 ad=3.52p pd=16.88u as=2.08p ps=8.52u w=8u l=1u
X273 a_37790_14455# a_37878_12387# a_37790_12479# VGND nfet_06v0 ad=2.08p pd=8.52u as=2.08p ps=8.52u w=8u l=1u
X274 VGND a_42494_19348# VAPWR ppolyf_u_1k_6p0 r_width=1u r_length=5u
X275 vext a_62855_19170# a_57681_34556# VAPWR pfet_06v0 ad=2.08p pd=8.52u as=2.08p ps=8.52u w=8u l=1u
X276 a_57681_34556# a_63447_19170# a_17602_30337# VAPWR pfet_06v0 ad=2.08p pd=8.52u as=2.08p ps=8.52u w=8u l=1u
X277 a_58393_27544# a_58393_27544# VAPWR VAPWR pfet_06v0 ad=3.52p pd=16.88u as=2.08p ps=8.52u w=8u l=4u
X278 a_41390_19348# a_43894_10411# a_37790_10503# VGND nfet_06v0 ad=2.08p pd=8.52u as=2.08p ps=8.52u w=8u l=1u
X279 a_42494_19348# a_43894_16339# VGND VGND nfet_06v0 ad=2.08p pd=8.52u as=2.08p ps=8.52u w=8u l=1u
X280 VAPWR VAPWR VAPWR VAPWR pfet_06v0 ad=3.52p pd=16.88u as=0 ps=0 w=8u l=8u
X281 VAPWR a_37064_32705# a_37064_33889# VAPWR pfet_06v0 ad=0.88p pd=4.88u as=0.88p ps=4.88u w=2u l=1u
X282 VGND a_19258_26215# VAPWR ppolyf_u_1k_6p0 r_width=1u r_length=20u
X283 a_56297_31862# a_56815_19170# vout VGND nfet_06v0 ad=2.08p pd=8.52u as=2.08p ps=8.52u w=8u l=1u
X284 a_59744_8833# a_59352_10901# VDPWR VDPWR pfet_06v0 ad=3.52p pd=16.88u as=2.08p ps=8.52u w=8u l=1u
X285 VGND bias a_56297_31862# VGND nfet_06v0 ad=2.08p pd=8.52u as=3.52p ps=16.88u w=8u l=1u
X286 a_41390_19348# a_43894_12387# a_42494_20470# VGND nfet_06v0 ad=2.08p pd=8.52u as=2.08p ps=8.52u w=8u l=1u
X287 a_56297_31862# a_56385_31770# VAPWR VAPWR pfet_06v0 ad=2.08p pd=8.52u as=2.08p ps=8.52u w=8u l=1u
X288 a_42494_20470# a_42494_19348# VAPWR ppolyf_u_1k_6p0 r_width=1u r_length=5u
X289 a_58985_37184# bias VGND VGND nfet_06v0 ad=3.52p pd=16.88u as=2.08p ps=8.52u w=8u l=1u
X290 a_13230_17754# a_12838_11118# VGND VGND nfet_06v0 ad=2.08p pd=8.52u as=3.52p ps=16.88u w=8u l=2u
X291 a_37790_14455# a_37878_14363# a_37790_16431# VGND nfet_06v0 ad=3.52p pd=16.88u as=2.08p ps=8.52u w=8u l=1u
X292 a_24590_19638# a_24590_19638# a_24590_15686# VAPWR pfet_06v0 ad=2.08p pd=8.52u as=3.52p ps=16.88u w=8u l=2u
X293 VAPWR a_37064_32705# a_37568_32797# VAPWR pfet_06v0 ad=0.88p pd=4.88u as=0.88p ps=4.88u w=2u l=1u
X294 VAPWR a_14134_11118# a_25798_19730# VAPWR pfet_06v0 ad=2.08p pd=8.52u as=3.52p ps=16.88u w=8u l=2u
X295 VGND a_12838_11118# a_11542_11118# VGND nfet_06v0 ad=3.52p pd=16.88u as=2.08p ps=8.52u w=8u l=2u
X296 VAPWR a_12030_11118# a_12430_17662# VAPWR pfet_06v0 ad=3.52p pd=16.88u as=3.52p ps=16.88u w=8u l=8u
X297 a_56297_31862# bias VGND VGND nfet_06v0 ad=3.52p pd=16.88u as=2.08p ps=8.52u w=8u l=1u
X298 a_57681_34556# a_62855_19170# vext VAPWR pfet_06v0 ad=2.08p pd=8.52u as=3.52p ps=16.88u w=8u l=1u
X299 a_42494_19348# a_43894_14363# a_42494_20470# VGND nfet_06v0 ad=2.08p pd=8.52u as=2.08p ps=8.52u w=8u l=1u
X300 a_42494_19348# a_43894_16339# VGND VGND nfet_06v0 ad=3.52p pd=16.88u as=2.08p ps=8.52u w=8u l=1u
X301 VGND VGND a_14276_37227# pnp_05p00x05p00
**devattr d=1000000,4000
X302 VAPWR a_24590_15686# a_24590_15686# VAPWR pfet_06v0 ad=3.52p pd=16.88u as=2.08p ps=8.52u w=8u l=2u
X303 a_58985_37184# a_58985_37184# a_60233_31862# VAPWR pfet_06v0 ad=3.52p pd=16.88u as=2.08p ps=8.52u w=8u l=1u
X304 a_37790_10503# a_43894_10411# a_41390_19348# VGND nfet_06v0 ad=3.52p pd=16.88u as=2.08p ps=8.52u w=8u l=1u
X305 VAPWR VAPWR VAPWR VAPWR pfet_06v0 ad=3.52p pd=16.88u as=0 ps=0 w=8u l=4u
X306 VAPWR a_56385_31770# a_56297_31862# VAPWR pfet_06v0 ad=2.08p pd=8.52u as=2.08p ps=8.52u w=8u l=1u
X307 a_13230_17754# a_12838_11118# VGND VGND nfet_06v0 ad=2.08p pd=8.52u as=3.52p ps=16.88u w=8u l=2u
X308 VGND VGND VGND VGND nfet_06v0 ad=3.52p pd=16.88u as=0 ps=0 w=8u l=8u
X309 VAPWR VAPWR VAPWR ppolyf_u_1k_6p0 r_width=1u r_length=5u
X310 a_14134_11118# a_11630_11026# a_13230_17754# VGND nfet_06v0 ad=3.52p pd=16.88u as=2.08p ps=8.52u w=8u l=2u
X311 a_17602_30337# a_63447_19170# a_57681_34556# VAPWR pfet_06v0 ad=3.52p pd=16.88u as=2.08p ps=8.52u w=8u l=1u
X312 VGND bias a_56297_31862# VGND nfet_06v0 ad=2.08p pd=8.52u as=3.52p ps=16.88u w=8u l=1u
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
