christoph-weiser/gf180mcu_cw_ip_vref/xschem/sch/bandgap_cm/bandgap/bandgap.pex.spice

* PEX CC extract

.subckt bandgap vdd vbg vss tio_7_ tio_6_ tio_5_ tio_4_ tio_3_ tio_2_ tio_1_ tio_0_ trim_7_ trim_6_
+ trim_5_ trim_4_ trim_3_ trim_2_ trim_1_ trim_0_ iout en

viout   iout    vss     0
vtio7   tio_7_  vss     0
vtio6   tio_6_  vss     0
vtio5   tio_5_  gate    0
vtio4   tio_4_  vy      0
vtio3   tio_3_  vx      0
vtio2   tio_2_  vss     0
vtio1   tio_1_  vs1     0
vtio0   tio_0_  bias    0

X0 vss vss vss vss nfet_06v0 ad=3.52p pd=16.88u as=3.52p ps=16.88u w=8u l=8u
X1 vss vss vss vss nfet_06v0 ad=-0.26381n pd=-1.72223m as=-0 ps=-0 w=8u l=8u
X2 vss vss vss vss nfet_06v0 ad=-0 pd=-0 as=-0 ps=-0 w=8u l=8u
X3 vss vss vss vss nfet_06v0 ad=-0 pd=-0 as=-0 ps=-0 w=8u l=8u
X4 vss vss vss vss nfet_06v0 ad=-0 pd=-0 as=-0 ps=-0 w=8u l=8u
X5 vb1 vb1 vss vss nfet_06v0 ad=14.96p pd=72.4u as=-0 ps=-0 w=8u l=8u
X6 vb1 vb1 vss vss nfet_06v0 ad=0 pd=0 as=-0 ps=-0 w=8u l=8u
X7 vss vss vss vss nfet_06v0 ad=-0 pd=-0 as=-0 ps=-0 w=8u l=8u
X8 vss vss vss vss nfet_06v0 ad=-0 pd=-0 as=-0 ps=-0 w=8u l=8u
X9 bias vb1 vss vss nfet_06v0 ad=7.04p pd=33.76u as=-0 ps=-0 w=8u l=8u
X10 vss vb1 bias vss nfet_06v0 ad=-0 pd=-0 as=0 ps=0 w=8u l=8u
X11 vss vss vss vss nfet_06v0 ad=-0 pd=-0 as=-0 ps=-0 w=8u l=8u
X12 vss vss vss vss nfet_06v0 ad=-0 pd=-0 as=-0 ps=-0 w=8u l=8u
X13 vss vb1 vb1 vss nfet_06v0 ad=-0 pd=-0 as=0 ps=0 w=8u l=8u
X14 vss vb1 vb1 vss nfet_06v0 ad=-0 pd=-0 as=0 ps=0 w=8u l=8u
X15 vss vss vss vss nfet_06v0 ad=-0 pd=-0 as=-0 ps=-0 w=8u l=8u
X16 vss vss vss vss nfet_06v0 ad=-0 pd=-0 as=-0 ps=-0 w=8u l=8u
X17 vss vss vss vss nfet_06v0 ad=-0 pd=-0 as=-0 ps=-0 w=8u l=8u
X18 vss vss vss vss nfet_06v0 ad=-0 pd=-0 as=-0 ps=-0 w=8u l=8u
X19 vss vss vss vss nfet_06v0 ad=-0 pd=-0 as=-0 ps=-0 w=8u l=8u
X20 bg__mi1_mi2_me1_me2_me3_me4_0/enb en vss vss nfet_06v0 ad=0.88p pd=4.88u as=0.88p ps=4.88u w=2u l=1u
X21 vs2 bg__mi1_mi2_me1_me2_me3_me4_0/enb vss vss nfet_06v0 ad=1.32p pd=7.76u as=-0 ps=-0 w=2u l=1u
X22 vb1 bg__mi1_mi2_me1_me2_me3_me4_0/enb vss vss nfet_06v0 ad=0 pd=0 as=-0 ps=-0 w=2u l=1u
X23 bg__mi1_mi2_me1_me2_me3_me4_0/enb en vdd vdd pfet_06v0 ad=0.88p pd=4.88u as=0.88p ps=4.88u w=2u l=1u
X24 vs1 en vdd vdd pfet_06v0 ad=0.88p pd=4.88u as=0.92372n ps=4.30706m w=2u l=1u
X25 gate en vdd vdd pfet_06v0 ad=17.52p pd=73.04u as=0 ps=0 w=2u l=1u
X26 vss vs2 gate vss nfet_06v0 ad=0.44p pd=2.88u as=0.44p ps=2.88u w=1u l=1u
X27 bg__ms1_ms2_ms3_ms4_c1_0/vs3 en vs2 vss nfet_06v0 ad=1.32p pd=8.64u as=0 ps=0 w=1u l=1u
X28 vss vx bg__ms1_ms2_ms3_ms4_c1_0/vs3 vss nfet_06v0 ad=-0 pd=-0 as=0 ps=0 w=1u l=1u
X29 vs1 en bg__ms1_ms2_ms3_ms4_c1_0/vs3 vss nfet_06v0 ad=0.44p pd=2.88u as=0 ps=0 w=1u l=1u
X30 vs1 vss cap_mim_2f0_m4m5_noshield c_width=10u c_length=10u
X31 vdd vdd vdd ppolyf_u_1k r_width=1u r_length=20u
X32 vdd vdd vdd ppolyf_u_1k r_width=1u r_length=20u
X33 vdd vdd vdd ppolyf_u_1k r_width=1u r_length=20u
X34 bg__r1_r2_r3_ro_0/m2_1892_4406# bg__trimres_0/pos vdd ppolyf_u_1k r_width=1u r_length=20u
X35 bg__r1_r2_r3_ro_0/m2_1892_4406# bg__r1_r2_r3_ro_0/m2_2444_234# vdd ppolyf_u_1k r_width=1u r_length=20u
X36 bg__r1_r2_r3_ro_0/m2_2996_4406# bg__r1_r2_r3_ro_0/m2_2444_234# vdd ppolyf_u_1k r_width=1u r_length=20u
X37 bg__r1_r2_r3_ro_0/m2_2996_4406# bg__r1_r2_r3_ro_0/m2_3548_234# vdd ppolyf_u_1k r_width=1u r_length=20u
X38 bg__r1_r2_r3_ro_0/m2_4100_4406# bg__r1_r2_r3_ro_0/m2_3548_234# vdd ppolyf_u_1k r_width=1u r_length=20u
X39 bg__r1_r2_r3_ro_0/m2_4100_4406# bg__r1_r2_r3_ro_0/m2_4652_234# vdd ppolyf_u_1k r_width=1u r_length=20u
X40 bg__r1_r2_r3_ro_0/m2_5204_4406# bg__r1_r2_r3_ro_0/m2_4652_234# vdd ppolyf_u_1k r_width=1u r_length=20u
X41 bg__r1_r2_r3_ro_0/m2_5204_4406# bg__r1_r2_r3_ro_0/m2_5756_234# vdd ppolyf_u_1k r_width=1u r_length=20u
X42 bg__r1_r2_r3_ro_0/m2_6308_4406# bg__r1_r2_r3_ro_0/m2_5756_234# vdd ppolyf_u_1k r_width=1u r_length=20u
X43 bg__r1_r2_r3_ro_0/m2_6308_4406# bg__r1_r2_r3_ro_0/m2_6860_234# vdd ppolyf_u_1k r_width=1u r_length=20u
X44 vbg bg__r1_r2_r3_ro_0/m2_6860_234# vdd ppolyf_u_1k r_width=1u r_length=20u
X45 vdd vdd vdd ppolyf_u_1k r_width=1u r_length=20u
X46 vdd vdd vdd ppolyf_u_1k r_width=1u r_length=20u
X47 vss bg__r1_r2_r3_ro_0/m2_9068_n166# vdd ppolyf_u_1k r_width=1u r_length=20u
X48 bg__r1_r2_r3_ro_0/m2_9620_4406# vss vdd ppolyf_u_1k r_width=1u r_length=20u
X49 bg__r1_r2_r3_ro_0/m2_10172_4406# bg__r1_r2_r3_ro_0/m2_9068_n166# vdd ppolyf_u_1k r_width=1u r_length=20u
X50 bg__r1_r2_r3_ro_0/m2_10172_4406# bg__r1_r2_r3_ro_0/m2_10724_n166# vdd ppolyf_u_1k r_width=1u r_length=20u
X51 bg__r1_r2_r3_ro_0/m2_9620_4406# bg__r1_r2_r3_ro_0/m2_11276_234# vdd ppolyf_u_1k r_width=1u r_length=20u
X52 bg__r1_r2_r3_ro_0/m2_11828_4406# bg__r1_r2_r3_ro_0/m2_11276_234# vdd ppolyf_u_1k r_width=1u r_length=20u
X53 bg__r1_r2_r3_ro_0/m2_12380_4406# bg__r1_r2_r3_ro_0/m2_10724_n166# vdd ppolyf_u_1k r_width=1u r_length=20u
X54 bg__r1_r2_r3_ro_0/m2_12380_4406# bg__r1_r2_r3_ro_0/m2_12932_n166# vdd ppolyf_u_1k r_width=1u r_length=20u
X55 bg__r1_r2_r3_ro_0/m2_11828_4406# bg__r1_r2_r3_ro_0/m2_13484_234# vdd ppolyf_u_1k r_width=1u r_length=20u
X56 bg__r1_r2_r3_ro_0/m2_14036_4406# bg__r1_r2_r3_ro_0/m2_13484_234# vdd ppolyf_u_1k r_width=1u r_length=20u
X57 bg__r1_r2_r3_ro_0/m2_14588_3806# vbe2 vdd ppolyf_u_1k r_width=1u r_length=20u
X58 bg__r1_r2_r3_ro_0/m2_15140_4406# bg__r1_r2_r3_ro_0/m2_12932_n166# vdd ppolyf_u_1k r_width=1u r_length=20u
X59 bg__r1_r2_r3_ro_0/m2_15140_4406# bg__r1_r2_r3_ro_0/m2_15692_n166# vdd ppolyf_u_1k r_width=1u r_length=20u
X60 bg__r1_r2_r3_ro_0/m2_14036_4406# bg__r1_r2_r3_ro_0/m2_16244_234# vdd ppolyf_u_1k r_width=1u r_length=20u
X61 bg__r1_r2_r3_ro_0/m2_16796_4406# bg__r1_r2_r3_ro_0/m2_16244_234# vdd ppolyf_u_1k r_width=1u r_length=20u
X62 bg__r1_r2_r3_ro_0/m2_17348_4406# bg__r1_r2_r3_ro_0/m2_15692_n166# vdd ppolyf_u_1k r_width=1u r_length=20u
X63 bg__r1_r2_r3_ro_0/m2_17348_4406# bg__r1_r2_r3_ro_0/m2_17900_n166# vdd ppolyf_u_1k r_width=1u r_length=20u
X64 bg__r1_r2_r3_ro_0/m2_16796_4406# bg__r1_r2_r3_ro_0/m2_18452_234# vdd ppolyf_u_1k r_width=1u r_length=20u
X65 bg__r1_r2_r3_ro_0/m2_19004_4406# bg__r1_r2_r3_ro_0/m2_18452_234# vdd ppolyf_u_1k r_width=1u r_length=20u
X66 bg__r1_r2_r3_ro_0/m2_19556_4406# bg__r1_r2_r3_ro_0/m2_17900_n166# vdd ppolyf_u_1k r_width=1u r_length=20u
X67 bg__r1_r2_r3_ro_0/m2_19556_4406# bg__r1_r2_r3_ro_0/m2_20108_n166# vdd ppolyf_u_1k r_width=1u r_length=20u
X68 bg__r1_r2_r3_ro_0/m2_19004_4406# bg__r1_r2_r3_ro_0/m2_20660_234# vdd ppolyf_u_1k r_width=1u r_length=20u
X69 bg__r1_r2_r3_ro_0/m2_21212_4406# bg__r1_r2_r3_ro_0/m2_20660_234# vdd ppolyf_u_1k r_width=1u r_length=20u
X70 bg__r1_r2_r3_ro_0/m2_21764_4406# bg__r1_r2_r3_ro_0/m2_20108_n166# vdd ppolyf_u_1k r_width=1u r_length=20u
X71 bg__r1_r2_r3_ro_0/m2_21764_4406# bg__r1_r2_r3_ro_0/m2_22316_n166# vdd ppolyf_u_1k r_width=1u r_length=20u
X72 bg__r1_r2_r3_ro_0/m2_14588_3806# vy vdd ppolyf_u_1k r_width=1u r_length=20u
X73 bg__r1_r2_r3_ro_0/m2_21212_4406# bg__r1_r2_r3_ro_0/m2_23420_234# vdd ppolyf_u_1k r_width=1u r_length=20u
X74 bg__r1_r2_r3_ro_0/m2_23972_4406# bg__r1_r2_r3_ro_0/m2_23420_234# vdd ppolyf_u_1k r_width=1u r_length=20u
X75 bg__r1_r2_r3_ro_0/m2_24524_4406# bg__r1_r2_r3_ro_0/m2_22316_n166# vdd ppolyf_u_1k r_width=1u r_length=20u
X76 bg__r1_r2_r3_ro_0/m2_24524_4406# bg__r1_r2_r3_ro_0/m2_25076_n166# vdd ppolyf_u_1k r_width=1u r_length=20u
X77 bg__r1_r2_r3_ro_0/m2_23972_4406# bg__r1_r2_r3_ro_0/m2_25628_234# vdd ppolyf_u_1k r_width=1u r_length=20u
X78 bg__r1_r2_r3_ro_0/m2_26180_4406# bg__r1_r2_r3_ro_0/m2_25628_234# vdd ppolyf_u_1k r_width=1u r_length=20u
X79 bg__r1_r2_r3_ro_0/m2_26732_4406# bg__r1_r2_r3_ro_0/m2_25076_n166# vdd ppolyf_u_1k r_width=1u r_length=20u
X80 bg__r1_r2_r3_ro_0/m2_26732_4406# vy vdd ppolyf_u_1k r_width=1u r_length=20u
X81 bg__r1_r2_r3_ro_0/m2_26180_4406# bg__r1_r2_r3_ro_0/m2_27836_234# vdd ppolyf_u_1k r_width=1u r_length=20u
X82 vx bg__r1_r2_r3_ro_0/m2_27836_234# vdd ppolyf_u_1k r_width=1u r_length=20u
X83 vdd vdd vdd ppolyf_u_1k r_width=1u r_length=20u
X84 vdd vdd vdd ppolyf_u_1k r_width=1u r_length=20u
X85 vdd vdd vdd ppolyf_u_1k r_width=1u r_length=20u
X86 vdd vdd vdd vdd pfet_06v0 ad=3.52p pd=16.88u as=3.52p ps=16.88u w=8u l=8u
X87 vdd vdd vdd vdd pfet_06v0 ad=0 pd=0 as=0 ps=0 w=8u l=8u
X88 vdd vdd vdd vdd pfet_06v0 ad=0 pd=0 as=0 ps=0 w=8u l=8u
X89 vdd vdd vdd vdd pfet_06v0 ad=0 pd=0 as=0 ps=0 w=8u l=8u
X90 vdd vdd vdd vdd pfet_06v0 ad=0 pd=0 as=0 ps=0 w=8u l=8u
X91 bg__m1_m2_mb1_mo1_mo2_0/iout gate vdd vdd pfet_06v0 ad=14.08p pd=67.52u as=0 ps=0 w=8u l=8u
X92 bg__m1_m2_mb1_mo1_mo2_0/iout gate vdd vdd pfet_06v0 ad=0 pd=0 as=0 ps=0 w=8u l=8u
X93 vdd vdd vdd vdd pfet_06v0 ad=0 pd=0 as=0 ps=0 w=8u l=8u
X94 vdd vdd vdd vdd pfet_06v0 ad=0 pd=0 as=0 ps=0 w=8u l=8u
X95 vdd gate vb1 vdd pfet_06v0 ad=0 pd=0 as=7.04p ps=33.76u w=8u l=8u
X96 vdd gate vx vdd pfet_06v0 ad=0 pd=0 as=21.12p ps=0.10128m w=8u l=8u
X97 vdd vdd vdd vdd pfet_06v0 ad=0 pd=0 as=0 ps=0 w=8u l=8u
X98 vdd vdd vdd vdd pfet_06v0 ad=0 pd=0 as=0 ps=0 w=8u l=8u
X99 vbg gate vdd vdd pfet_06v0 ad=14.08p pd=67.52u as=0 ps=0 w=8u l=8u
X100 vbg gate vdd vdd pfet_06v0 ad=0 pd=0 as=0 ps=0 w=8u l=8u
X101 vdd vdd vdd vdd pfet_06v0 ad=0 pd=0 as=0 ps=0 w=8u l=8u
X102 vdd vdd vdd vdd pfet_06v0 ad=0 pd=0 as=0 ps=0 w=8u l=8u
X103 vdd gate vy vdd pfet_06v0 ad=0 pd=0 as=14.08p ps=67.52u w=8u l=8u
X104 vdd gate vy vdd pfet_06v0 ad=0 pd=0 as=0 ps=0 w=8u l=8u
X105 vdd vdd vdd vdd pfet_06v0 ad=0 pd=0 as=0 ps=0 w=8u l=8u
X106 vdd vdd vdd vdd pfet_06v0 ad=0 pd=0 as=0 ps=0 w=8u l=8u
X107 vx gate vdd vdd pfet_06v0 ad=0 pd=0 as=0 ps=0 w=8u l=8u
X108 vx gate vdd vdd pfet_06v0 ad=0 pd=0 as=0 ps=0 w=8u l=8u
X109 vdd vdd vdd vdd pfet_06v0 ad=0 pd=0 as=0 ps=0 w=8u l=8u
X110 vdd vdd vdd vdd pfet_06v0 ad=0 pd=0 as=0 ps=0 w=8u l=8u
X111 vdd gate vx vdd pfet_06v0 ad=0 pd=0 as=0 ps=0 w=8u l=8u
X112 vdd gate vx vdd pfet_06v0 ad=0 pd=0 as=0 ps=0 w=8u l=8u
X113 vdd vdd vdd vdd pfet_06v0 ad=0 pd=0 as=0 ps=0 w=8u l=8u
X114 vdd vdd vdd vdd pfet_06v0 ad=0 pd=0 as=0 ps=0 w=8u l=8u
X115 vy gate vdd vdd pfet_06v0 ad=0 pd=0 as=0 ps=0 w=8u l=8u
X116 vy gate vdd vdd pfet_06v0 ad=0 pd=0 as=0 ps=0 w=8u l=8u
X117 vdd vdd vdd vdd pfet_06v0 ad=0 pd=0 as=0 ps=0 w=8u l=8u
X118 vdd vdd vdd vdd pfet_06v0 ad=0 pd=0 as=0 ps=0 w=8u l=8u
X119 vdd gate vbg vdd pfet_06v0 ad=0 pd=0 as=0 ps=0 w=8u l=8u
X120 vdd gate vbg vdd pfet_06v0 ad=0 pd=0 as=0 ps=0 w=8u l=8u
X121 vdd vdd vdd vdd pfet_06v0 ad=0 pd=0 as=0 ps=0 w=8u l=8u
X122 vdd vdd vdd vdd pfet_06v0 ad=0 pd=0 as=0 ps=0 w=8u l=8u
X123 vb1 gate vdd vdd pfet_06v0 ad=0 pd=0 as=0 ps=0 w=8u l=8u
X124 vx gate vdd vdd pfet_06v0 ad=0 pd=0 as=0 ps=0 w=8u l=8u
X125 vdd vdd vdd vdd pfet_06v0 ad=0 pd=0 as=0 ps=0 w=8u l=8u
X126 vdd vdd vdd vdd pfet_06v0 ad=0 pd=0 as=0 ps=0 w=8u l=8u
X127 vdd gate bg__m1_m2_mb1_mo1_mo2_0/iout vdd pfet_06v0 ad=0 pd=0 as=0 ps=0 w=8u l=8u
X128 vdd gate bg__m1_m2_mb1_mo1_mo2_0/iout vdd pfet_06v0 ad=0 pd=0 as=0 ps=0 w=8u l=8u
X129 vdd vdd vdd vdd pfet_06v0 ad=0 pd=0 as=0 ps=0 w=8u l=8u
X130 vdd vdd vdd vdd pfet_06v0 ad=0 pd=0 as=0 ps=0 w=8u l=8u
X131 vdd vdd vdd vdd pfet_06v0 ad=0 pd=0 as=0 ps=0 w=8u l=8u
X132 vdd vdd vdd vdd pfet_06v0 ad=0 pd=0 as=0 ps=0 w=8u l=8u
X133 vdd vdd vdd vdd pfet_06v0 ad=0 pd=0 as=0 ps=0 w=8u l=8u
X134 vdd vdd vdd ppolyf_u_1k r_width=1u r_length=5u
X135 vdd vdd vdd ppolyf_u_1k r_width=1u r_length=5u
X136 bg__trimres_0/bgt__runits_0/m2_772_1390# bg__trimres_0/pos vdd ppolyf_u_1k r_width=1u r_length=5u
X137 bg__trimres_0/bgt__runits_0/m2_772_2986# bg__trimres_0/bgt__runits_0/m2_772_1390# vdd ppolyf_u_1k r_width=1u r_length=5u
X138 bg__trimres_0/bgt__runits_0/m2_1324_1390# bg__trimres_0/bgt__runits_0/m2_1324_218# vdd ppolyf_u_1k r_width=1u r_length=5u
X139 bg__trimres_0/bgt__runits_0/m2_772_2986# bg__trimres_0/bgt__runits_0/m2_1324_1390# vdd ppolyf_u_1k r_width=1u r_length=5u
X140 bg__trimres_0/bgt__runits_0/m2_1876_1390# bg__trimres_0/bgt__runits_0/m2_1324_218# vdd ppolyf_u_1k r_width=1u r_length=5u
X141 bg__trimres_0/bgt__runits_0/m2_1876_2986# bg__trimres_0/bgt__runits_0/m2_1876_1390# vdd ppolyf_u_1k r_width=1u r_length=5u
X142 bg__trimres_0/bgt__runits_0/m2_2428_1390# bg__trimres_0/bgt__runits_0/a6 vdd ppolyf_u_1k r_width=1u r_length=5u
X143 bg__trimres_0/bgt__runits_0/m2_1876_2986# bg__trimres_0/bgt__runits_0/m2_2428_1390# vdd ppolyf_u_1k r_width=1u r_length=5u
X144 bg__trimres_0/bgt__runits_0/m2_2980_1390# bg__trimres_0/bgt__runits_0/a6 vdd ppolyf_u_1k r_width=1u r_length=5u
X145 bg__trimres_0/bgt__runits_0/m2_2980_2986# bg__trimres_0/bgt__runits_0/m2_2980_1390# vdd ppolyf_u_1k r_width=1u r_length=5u
X146 bg__trimres_0/bgt__runits_0/m2_3532_1390# bg__trimres_0/bgt__runits_0/a5 vdd ppolyf_u_1k r_width=1u r_length=5u
X147 bg__trimres_0/bgt__runits_0/m2_2980_2986# bg__trimres_0/bgt__runits_0/m2_3532_1390# vdd ppolyf_u_1k r_width=1u r_length=5u
X148 bg__trimres_0/bgt__runits_0/m2_4084_1390# bg__trimres_0/bgt__runits_0/a5 vdd ppolyf_u_1k r_width=1u r_length=5u
X149 bg__trimres_0/bgt__runits_0/a4 bg__trimres_0/bgt__runits_0/m2_4084_1390# vdd ppolyf_u_1k r_width=1u r_length=5u
X150 bg__trimres_0/bgt__runits_0/a3 bg__trimres_0/bgt__runits_0/a2 vdd ppolyf_u_1k r_width=1u r_length=5u
X151 bg__trimres_0/bgt__runits_0/a4 bg__trimres_0/bgt__runits_0/a3 vdd ppolyf_u_1k r_width=1u r_length=5u
X152 bg__trimres_0/bgt__runits_0/a3 bg__trimres_0/bgt__runits_0/a2 vdd ppolyf_u_1k r_width=1u r_length=5u
X153 vdd vdd vdd ppolyf_u_1k r_width=1u r_length=5u
X154 bg__trimres_0/bgt__runits_0/a1 bg__trimres_0/bgt__runits_0/a0 vdd ppolyf_u_1k r_width=1u r_length=5u
X155 bg__trimres_0/bgt__runits_0/a2 bg__trimres_0/bgt__runits_0/a1 vdd ppolyf_u_1k r_width=1u r_length=5u
X156 bg__trimres_0/bgt__runits_0/a1 bg__trimres_0/bgt__runits_0/a0 vdd ppolyf_u_1k r_width=1u r_length=5u
X157 bg__trimres_0/bgt__runits_0/a2 bg__trimres_0/bgt__runits_0/a1 vdd ppolyf_u_1k r_width=1u r_length=5u
X158 bg__trimres_0/bgt__runits_0/a1 bg__trimres_0/bgt__runits_0/a0 vdd ppolyf_u_1k r_width=1u r_length=5u
X159 bg__trimres_0/bgt__runits_0/a2 bg__trimres_0/bgt__runits_0/a1 vdd ppolyf_u_1k r_width=1u r_length=5u
X160 bg__trimres_0/bgt__runits_0/a1 bg__trimres_0/bgt__runits_0/a0 vdd ppolyf_u_1k r_width=1u r_length=5u
X161 bg__trimres_0/bgt__runits_0/a2 bg__trimres_0/bgt__runits_0/a1 vdd ppolyf_u_1k r_width=1u r_length=5u
X162 bg__trimres_0/bgt__runits_0/a1 bg__trimres_0/bgt__runits_0/a0 vdd ppolyf_u_1k r_width=1u r_length=5u
X163 vss bg__trimres_0/bgt__runits_0/a0 vdd ppolyf_u_1k r_width=1u r_length=5u
X164 bg__trimres_0/bgt__runits_0/a1 bg__trimres_0/bgt__runits_0/a0 vdd ppolyf_u_1k r_width=1u r_length=5u
X165 vss bg__trimres_0/bgt__runits_0/a0 vdd ppolyf_u_1k r_width=1u r_length=5u
X166 bg__trimres_0/bgt__runits_0/a1 bg__trimres_0/bgt__runits_0/a0 vdd ppolyf_u_1k r_width=1u r_length=5u
X167 vss bg__trimres_0/bgt__runits_0/a0 vdd ppolyf_u_1k r_width=1u r_length=5u
X168 bg__trimres_0/bgt__runits_0/a1 bg__trimres_0/bgt__runits_0/a0 vdd ppolyf_u_1k r_width=1u r_length=5u
X169 vss bg__trimres_0/bgt__runits_0/a0 vdd ppolyf_u_1k r_width=1u r_length=5u
X170 bg__trimres_0/bgt__runits_0/a0 vss vdd ppolyf_u_1k r_width=1u r_length=5u
X171 vss bg__trimres_0/bgt__runits_0/a0 vdd ppolyf_u_1k r_width=1u r_length=5u
X172 bg__trimres_0/bgt__runits_0/a0 vss vdd ppolyf_u_1k r_width=1u r_length=5u
X173 vss bg__trimres_0/bgt__runits_0/a0 vdd ppolyf_u_1k r_width=1u r_length=5u
X174 bg__trimres_0/bgt__runits_0/a0 vss vdd ppolyf_u_1k r_width=1u r_length=5u
X175 vss bg__trimres_0/bgt__runits_0/a0 vdd ppolyf_u_1k r_width=1u r_length=5u
X176 bg__trimres_0/bgt__runits_0/a0 vss vdd ppolyf_u_1k r_width=1u r_length=5u
X177 vss bg__trimres_0/bgt__runits_0/a0 vdd ppolyf_u_1k r_width=1u r_length=5u
X178 bg__trimres_0/bgt__runits_0/a0 vss vdd ppolyf_u_1k r_width=1u r_length=5u
X179 vss bg__trimres_0/bgt__runits_0/a0 vdd ppolyf_u_1k r_width=1u r_length=5u
X180 bg__trimres_0/bgt__runits_0/a0 vss vdd ppolyf_u_1k r_width=1u r_length=5u
X181 vss bg__trimres_0/bgt__runits_0/a0 vdd ppolyf_u_1k r_width=1u r_length=5u
X182 vdd vdd vdd ppolyf_u_1k r_width=1u r_length=5u
X183 vdd vdd vdd ppolyf_u_1k r_width=1u r_length=5u
X184 bg__trimres_0/bgt__runits_0/a3 trim_4_ bg__trimres_0/bgt__runits_0/a4 vss nfet_06v0 ad=3.52p pd=16.88u as=2.08p ps=8.52u w=8u l=1u
X185 bg__trimres_0/bgt__runits_0/a4 trim_4_ bg__trimres_0/bgt__runits_0/a3 vss nfet_06v0 ad=2.08p pd=8.52u as=2.08p ps=8.52u w=8u l=1u
X186 bg__trimres_0/bgt__runits_0/a3 trim_4_ bg__trimres_0/bgt__runits_0/a4 vss nfet_06v0 ad=2.08p pd=8.52u as=2.08p ps=8.52u w=8u l=1u
X187 bg__trimres_0/bgt__runits_0/a4 trim_4_ bg__trimres_0/bgt__runits_0/a3 vss nfet_06v0 ad=2.08p pd=8.52u as=3.52p ps=16.88u w=8u l=1u
X188 bg__trimres_0/bgt__runits_0/a4 trim_5_ bg__trimres_0/bgt__runits_0/a5 vss nfet_06v0 ad=78.07999p pd=0.33952m as=78.07999p ps=0.33952m w=8u l=1u
X189 bg__trimres_0/bgt__runits_0/a5 trim_5_ bg__trimres_0/bgt__runits_0/a4 vss nfet_06v0 ad=0 pd=0 as=0 ps=0 w=8u l=1u
X190 bg__trimres_0/bgt__runits_0/a4 trim_5_ bg__trimres_0/bgt__runits_0/a5 vss nfet_06v0 ad=0 pd=0 as=0 ps=0 w=8u l=1u
X191 bg__trimres_0/bgt__runits_0/a5 trim_5_ bg__trimres_0/bgt__runits_0/a4 vss nfet_06v0 ad=0 pd=0 as=0 ps=0 w=8u l=1u
X192 bg__trimres_0/bgt__runits_0/a5 trim_6_ bg__trimres_0/bgt__runits_0/a6 vss nfet_06v0 ad=0 pd=0 as=78.07999p ps=0.33952m w=8u l=1u
X193 bg__trimres_0/bgt__runits_0/a6 trim_6_ bg__trimres_0/bgt__runits_0/a5 vss nfet_06v0 ad=0 pd=0 as=0 ps=0 w=8u l=1u
X194 bg__trimres_0/bgt__runits_0/a5 trim_6_ bg__trimres_0/bgt__runits_0/a6 vss nfet_06v0 ad=0 pd=0 as=0 ps=0 w=8u l=1u
X195 bg__trimres_0/bgt__runits_0/a6 trim_6_ bg__trimres_0/bgt__runits_0/a5 vss nfet_06v0 ad=0 pd=0 as=0 ps=0 w=8u l=1u
X196 bg__trimres_0/bgt__runits_0/a6 trim_7_ bg__trimres_0/pos vss nfet_06v0 ad=0 pd=0 as=33.27999p ps=0.13632m w=8u l=1u
X197 bg__trimres_0/pos trim_7_ bg__trimres_0/bgt__runits_0/a6 vss nfet_06v0 ad=0 pd=0 as=0 ps=0 w=8u l=1u
X198 bg__trimres_0/bgt__runits_0/a6 trim_7_ bg__trimres_0/pos vss nfet_06v0 ad=0 pd=0 as=0 ps=0 w=8u l=1u
X199 bg__trimres_0/pos trim_7_ bg__trimres_0/bgt__runits_0/a6 vss nfet_06v0 ad=0 pd=0 as=0 ps=0 w=8u l=1u
X200 bg__trimres_0/bgt__runits_0/a3 trim_4_ bg__trimres_0/bgt__runits_0/a4 vss nfet_06v0 ad=89.59999p pd=0.4064m as=0 ps=0 w=8u l=1u
X201 bg__trimres_0/bgt__runits_0/a4 trim_4_ bg__trimres_0/bgt__runits_0/a3 vss nfet_06v0 ad=0 pd=0 as=0 ps=0 w=8u l=1u
X202 bg__trimres_0/bgt__runits_0/a3 trim_4_ bg__trimres_0/bgt__runits_0/a4 vss nfet_06v0 ad=0 pd=0 as=0 ps=0 w=8u l=1u
X203 bg__trimres_0/bgt__runits_0/a4 trim_4_ bg__trimres_0/bgt__runits_0/a3 vss nfet_06v0 ad=0 pd=0 as=0 ps=0 w=8u l=1u
X204 bg__trimres_0/bgt__runits_0/a4 trim_5_ bg__trimres_0/bgt__runits_0/a5 vss nfet_06v0 ad=0 pd=0 as=0 ps=0 w=8u l=1u
X205 bg__trimres_0/bgt__runits_0/a5 trim_5_ bg__trimres_0/bgt__runits_0/a4 vss nfet_06v0 ad=0 pd=0 as=0 ps=0 w=8u l=1u
X206 bg__trimres_0/bgt__runits_0/a4 trim_5_ bg__trimres_0/bgt__runits_0/a5 vss nfet_06v0 ad=0 pd=0 as=0 ps=0 w=8u l=1u
X207 bg__trimres_0/bgt__runits_0/a5 trim_5_ bg__trimres_0/bgt__runits_0/a4 vss nfet_06v0 ad=0 pd=0 as=0 ps=0 w=8u l=1u
X208 bg__trimres_0/bgt__runits_0/a5 trim_6_ bg__trimres_0/bgt__runits_0/a6 vss nfet_06v0 ad=0 pd=0 as=0 ps=0 w=8u l=1u
X209 bg__trimres_0/bgt__runits_0/a6 trim_6_ bg__trimres_0/bgt__runits_0/a5 vss nfet_06v0 ad=0 pd=0 as=0 ps=0 w=8u l=1u
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
X297 bg__trimres_0/bgt__runits_0/a2 trim_3_ bg__trimres_0/bgt__runits_0/a3 vss nfet_06v0 ad=0 pd=0 as=0 ps=0 w=8u l=1u
X298 bg__trimres_0/bgt__runits_0/a3 trim_3_ bg__trimres_0/bgt__runits_0/a2 vss nfet_06v0 ad=0 pd=0 as=0 ps=0 w=8u l=1u
X299 bg__trimres_0/bgt__runits_0/a2 trim_3_ bg__trimres_0/bgt__runits_0/a3 vss nfet_06v0 ad=0 pd=0 as=0 ps=0 w=8u l=1u
X300 bg__trimres_0/bgt__runits_0/a2 trim_2_ bg__trimres_0/bgt__runits_0/a1 vss nfet_06v0 ad=0 pd=0 as=0 ps=0 w=8u l=1u
X301 bg__trimres_0/bgt__runits_0/a1 trim_2_ bg__trimres_0/bgt__runits_0/a2 vss nfet_06v0 ad=0 pd=0 as=0 ps=0 w=8u l=1u
X302 bg__trimres_0/bgt__runits_0/a2 trim_2_ bg__trimres_0/bgt__runits_0/a1 vss nfet_06v0 ad=0 pd=0 as=0 ps=0 w=8u l=1u
X303 bg__trimres_0/bgt__runits_0/a1 trim_2_ bg__trimres_0/bgt__runits_0/a2 vss nfet_06v0 ad=0 pd=0 as=0 ps=0 w=8u l=1u
X304 bg__trimres_0/bgt__runits_0/a1 trim_1_ bg__trimres_0/bgt__runits_0/a0 vss nfet_06v0 ad=0 pd=0 as=0 ps=0 w=8u l=1u
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
