christoph-weiser/gf180mcu_cw_ip_vref/(commit log)

2026-09-29 added more xschem symbols
    [stbprobe.sch]
2026-09-29 added ngspice_get_expr.sym device
2026-09-29 added schematic pages
    [bandgap.sch, bg_amplifier.sch, bg_trimres.sch]
2026-09-29 added testbenches
    [ac_bandgap_psrr.sch, ac_bandgap_stb.sch, ac_bg_amplifier_stb.sch, dc_bandgap_power.sch, dc_bandgap_supply.sch, dc_bandgap_temperature.sch, dc_bg_amplifier_icmr.sch, mc_bandgap_temperature.sch]
2026-09-29 removed ext blocks
    [dc_bandgap_temperature.sch, op_bandgap.sch]
2026-09-29 inserted links
2026-09-30 op power analysis results added
2026-09-30 replaced dc power analysis with op analysis
    [op_bandgap_power.sch]
2026-09-30 changed tb name for power assessment.
2026-09-30 udpated op tb and added op_bandgap results
    [op_bandgap.sch]
2026-09-30 removed tb that are not strictly required to validate the spec
    [ac_bg_amplifier_stb.sch, dc_bg_amplifier_icmr.sch, mc_bg_amplifier.sch, no_bg_amplifier.sch, op_bg_amplifier.sch, tr_bg_amplifier.sch, tr_bg_amplifier_slew.sch]
2026-10-01 added trim tb and conf
    [tr_bandgap_trim.sch, tr_bandgap_trim_ss.sch]
2026-10-01 changed cl to match spec.
    [tr_bandgap_startup.sch]
2026-10-02 added tb and conf for off-state current
    [tr_bandgap_power_off.sch]
2026-10-02 added results for off-state current
2026-10-02 inserted result table
2026-10-03 added levelshifter sch, tb and conf
    [levelshifter.sch, tr_levelshifter.sch]
2026-10-03 added spdt sch, tb and conf
    [dc_spdt_leakage.sch, dc_spdt_ron.sch, spdt.sch, tr_spdt.sch]
2026-10-03 added testbuffer sch, sym
    [tb_amplifier.sch, testbuffer.sch]
2026-10-03 added top-level schematic and added to xschemrc
    [gf180mcu_cw_ip_vref.sch]
2026-10-04 added all testbenches for testbuffer
    [ac_tb_amplifier_cin.sch, ac_tb_amplifier_cmrr.sch, ac_tb_amplifier_psrr.sch, ac_tb_amplifier_stb.sch, dc_tb_amplifier_icmr.sch, mc_tb_amplifier.sch, no_tb_amplifier.sch, op_tb_amplifier.sch]
2026-10-04 added top-level simulation
    [tr_gf180mcu_cw_ip_vref.sch]
2026-10-05 io names match schematic
2026-10-06 added print statements
    [dc_spdt_leakage.sch]
2026-10-06 added reference to spdt switch results
2026-10-12 added par parameter to mosfet symbols
2026-10-12 updated mc_bandgap_temperature tb for -40 to 85 temperature range
2026-10-16 connected resistor bulk terminal to vdd
2026-10-16 updated documentation with latest testresults after schematic change
